CooterPMcGrew/Flight_Computer_REV01/ISS_MCU_REV03-Zynq_PS_CONF.pdf

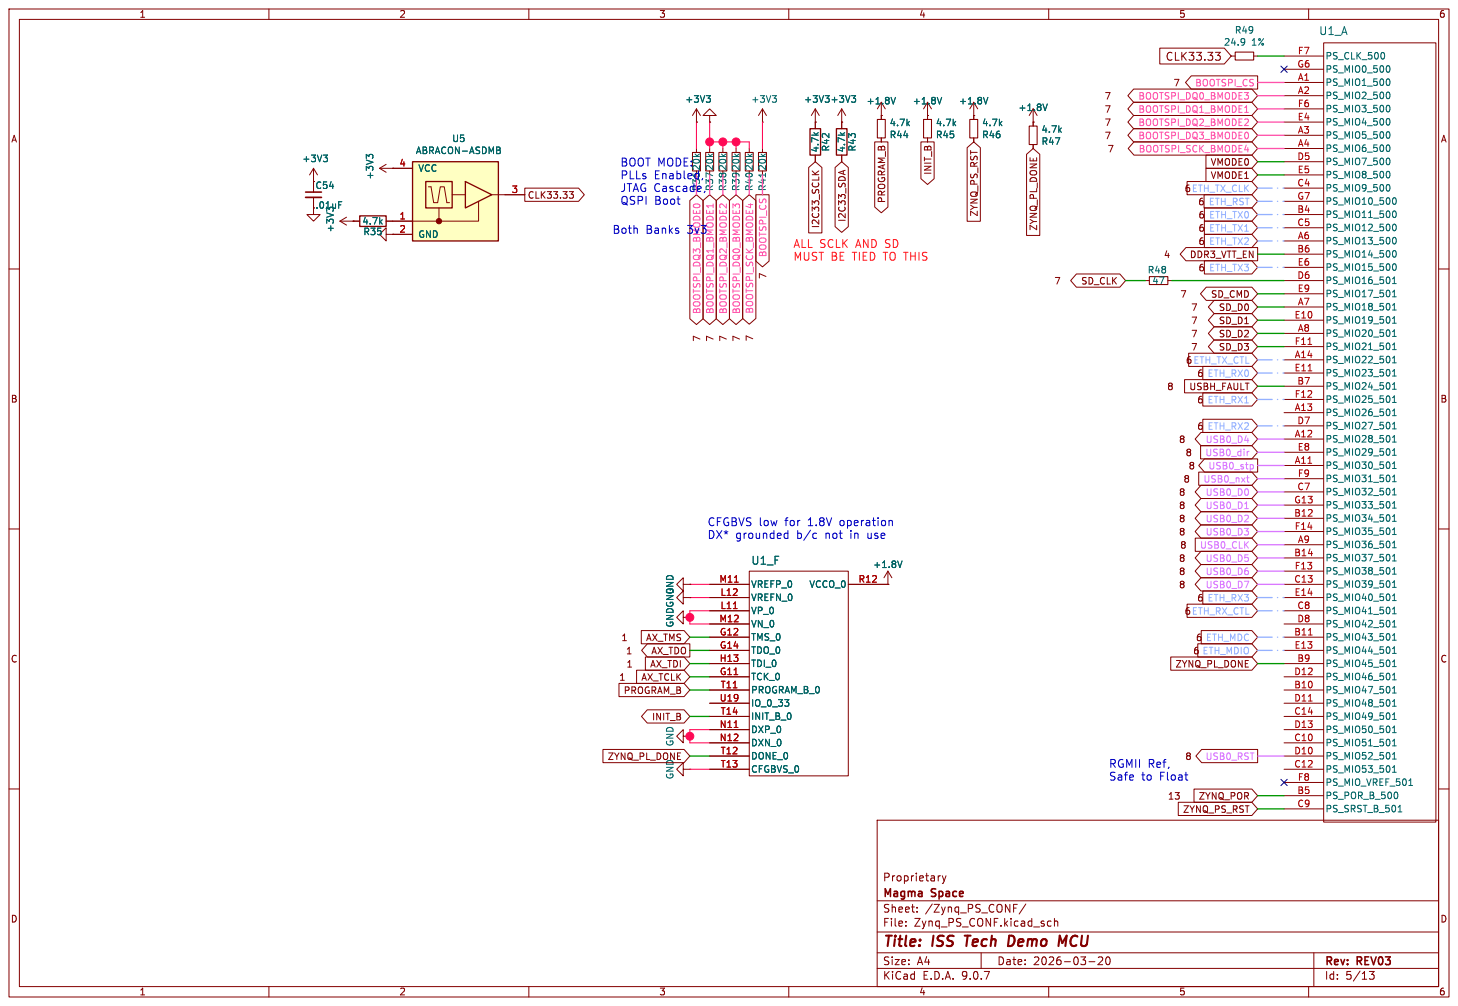
[picture p14: page 1]

Both Banks 3v3 BOOT MODE: PLLs Enabled,

Safe to Float CFGBVS low for 1.8V operation DX* grounded b/c not in use ALL SCLK AND SD

MUST BE TIED TO THIS

Magma Space
File: Zynq_PS_CONF.kicad_sch Sheet: /Zynq_PS_CONF/
Id: 5/13 Title: ISS Tech Demo MCU
