CooterPMcGrew/Flight_Computer_REV01/ISS_MCU_REV05.pdf

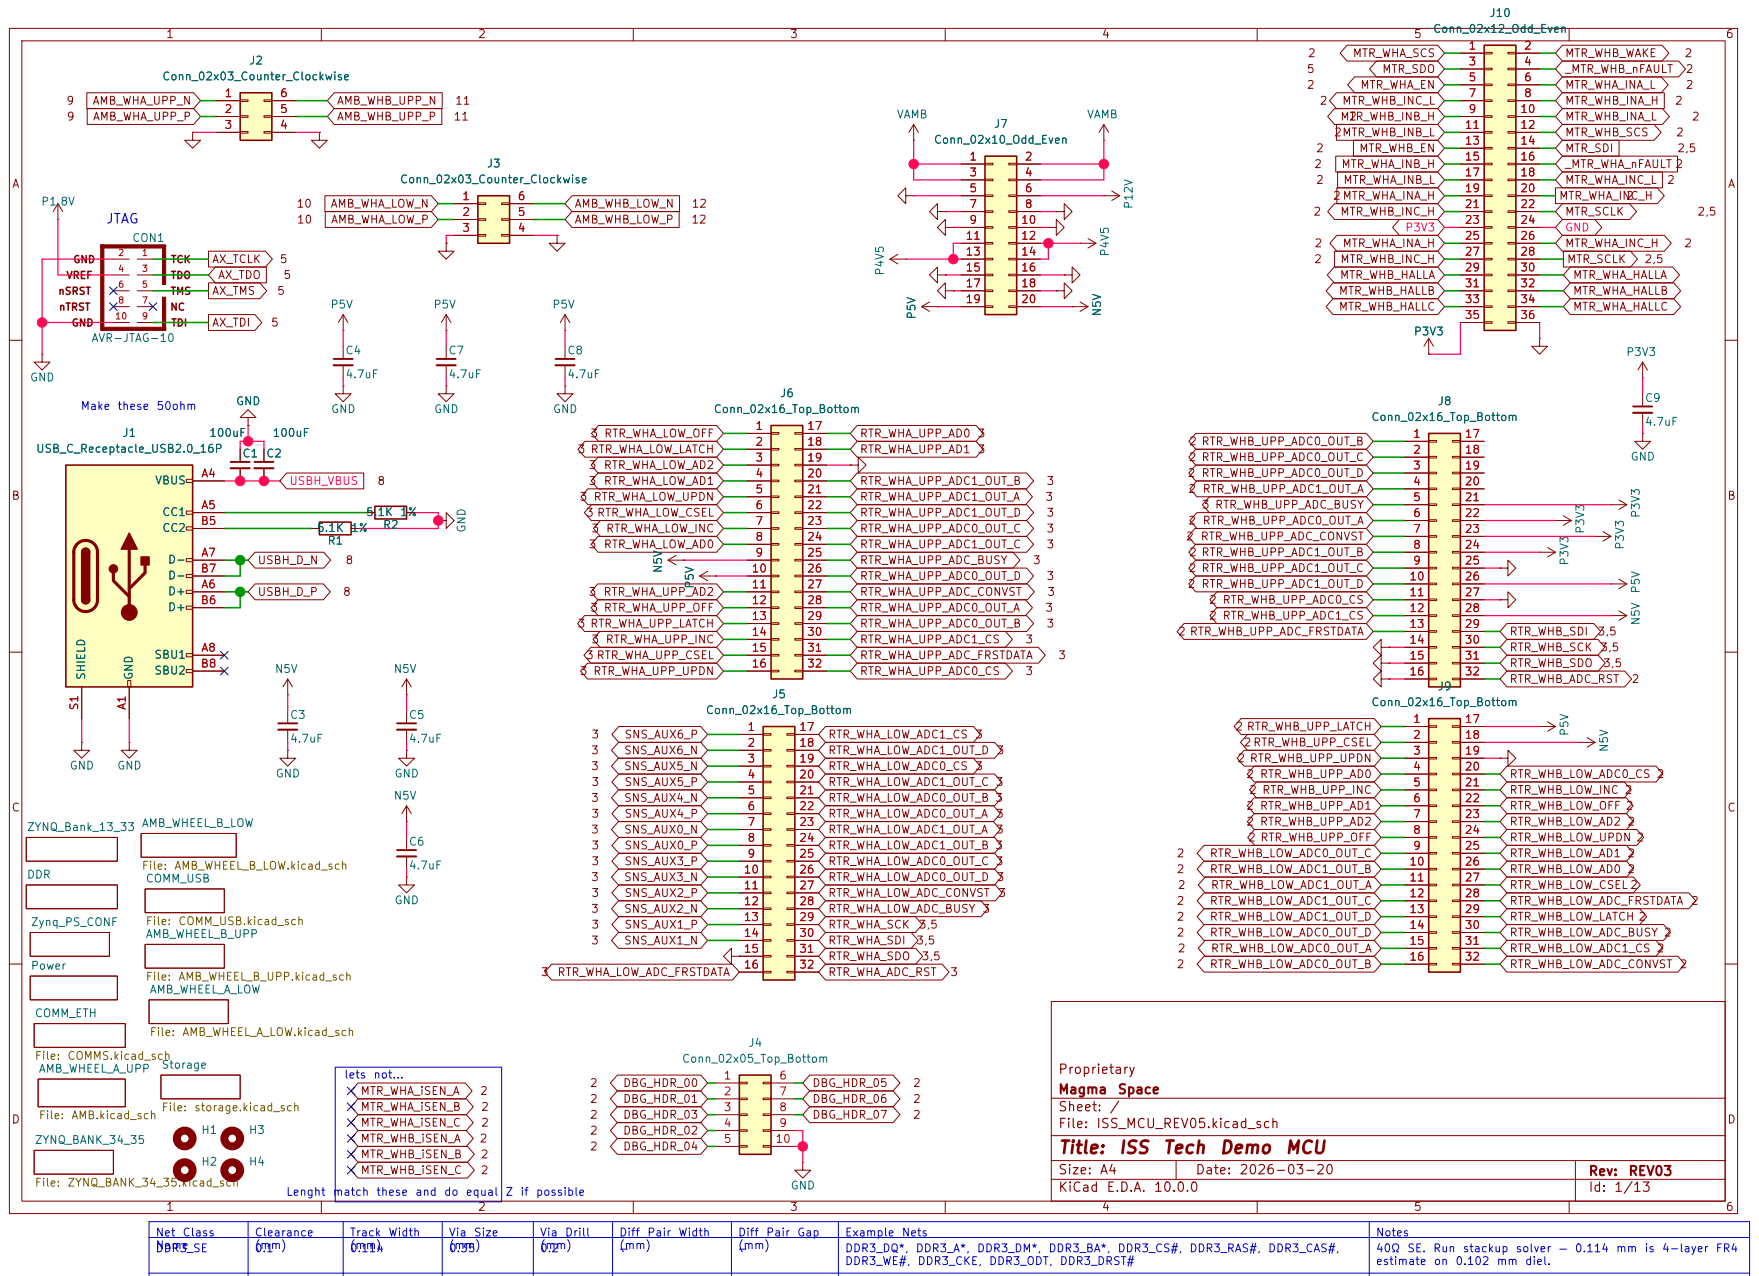
[picture p15: page 1]

Magma Space
Sheet: /
D Date: 2026-03-20 KiCad E.D.A. 10.0.0
File: ISS_MCU_REV05.kicad_sch
Title: ISS Tech Demo MCU

Size: A4 | Rev: REV03

0.1 | Track Width 0.114 | Via Size 0.35 | Via Drill (mm) 0.2 | Diff Pair Width — | Diff Pair Gap — | Example Nets DDR3_DQ*, DDR3_A*, DDR3_DM*, DDR3_BA*, DDR3_CS#, DDR3_RAS#, DDR3_CAS#, | Notes DDR3_SE

(mm) | (mm) | (mm) | | (mm) | (mm) | DDR3_WE#, DDR3_CKE, DDR3_ODT, DDR3_DRST# | 40Ω SE. Run stackup solver — 0.114 mm is 4-layer FR4

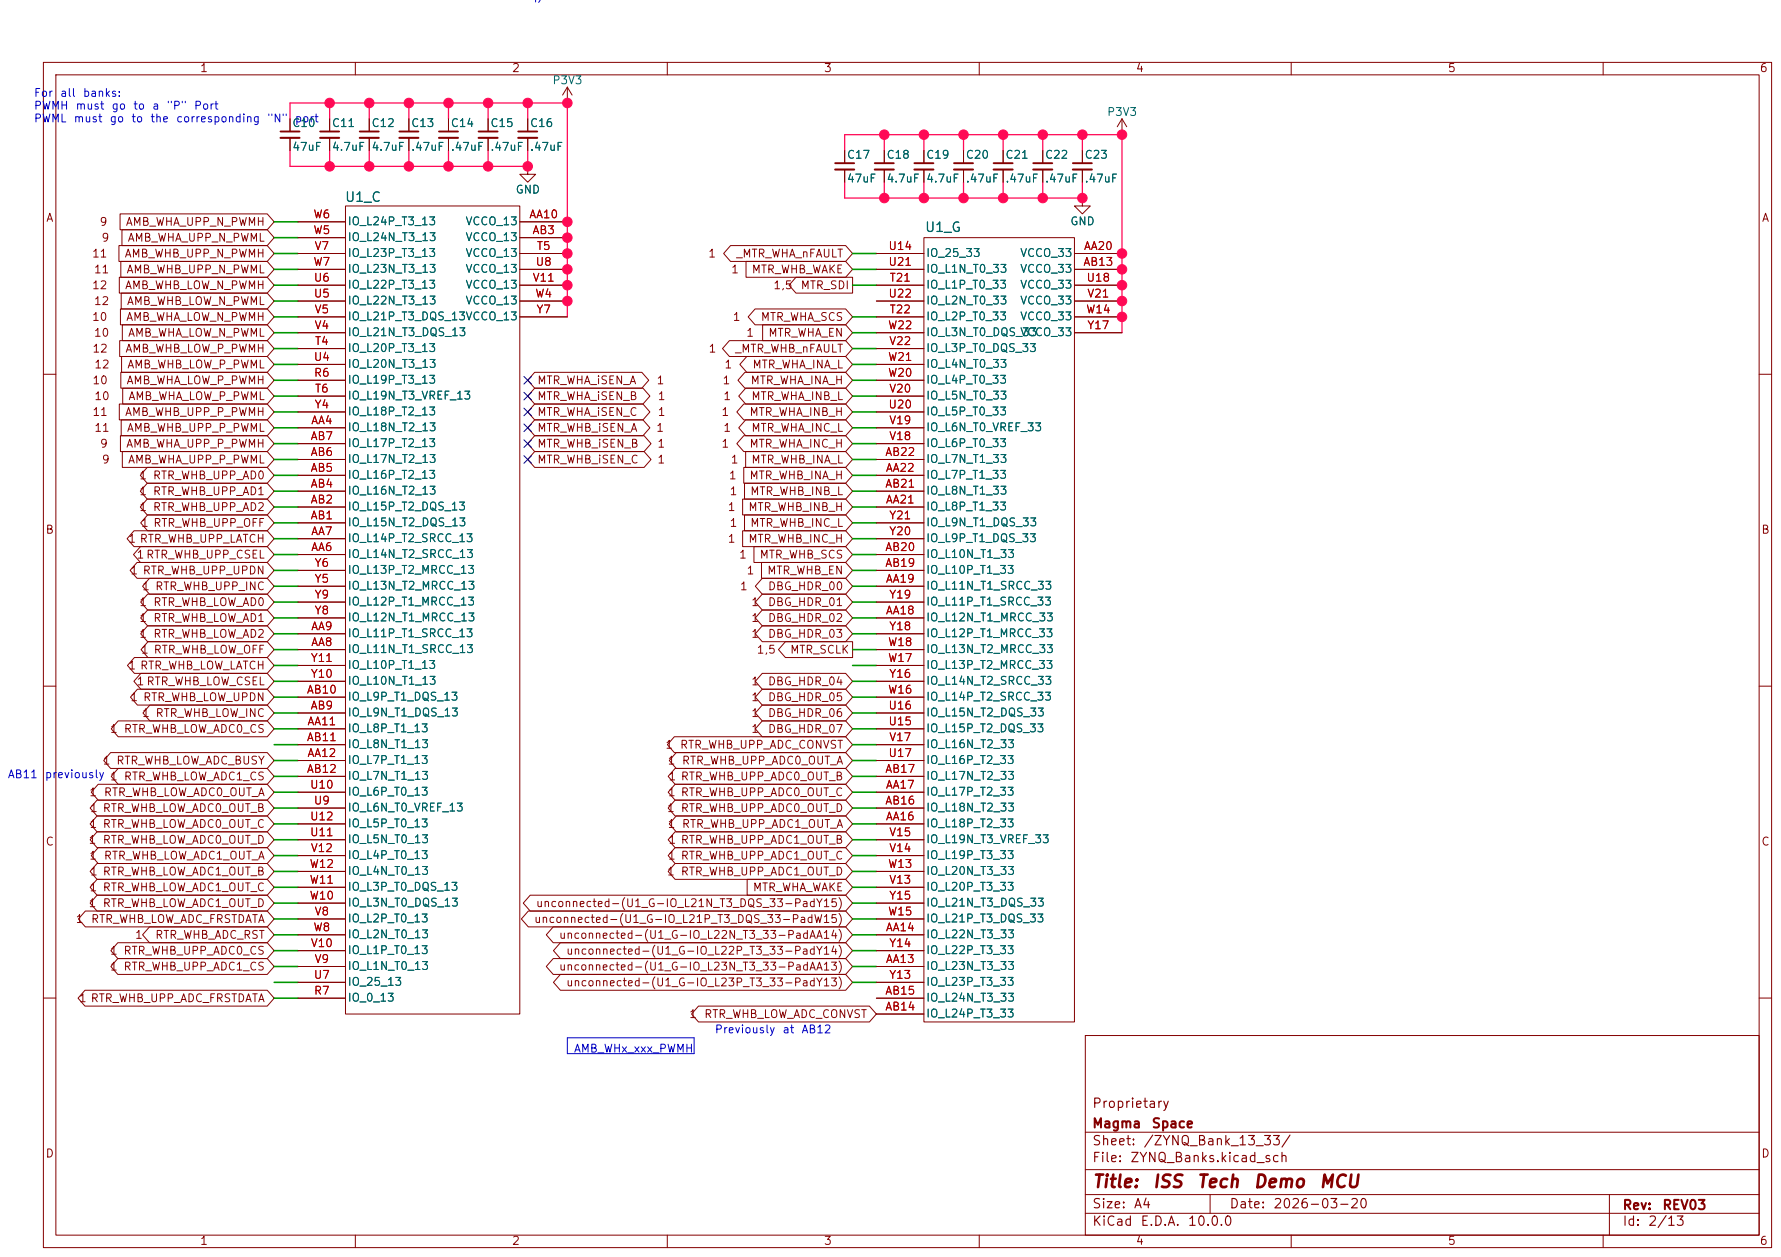
[picture p16: page 2]

Proprietary
Magma Space
Sheet: /ZYNQ_Bank_13_33/
D Date: 2026-03-20 KiCad E.D.A. 10.0.0
File: ZYNQ_Banks.kicad_sch
Title: ISS Tech Demo MCU

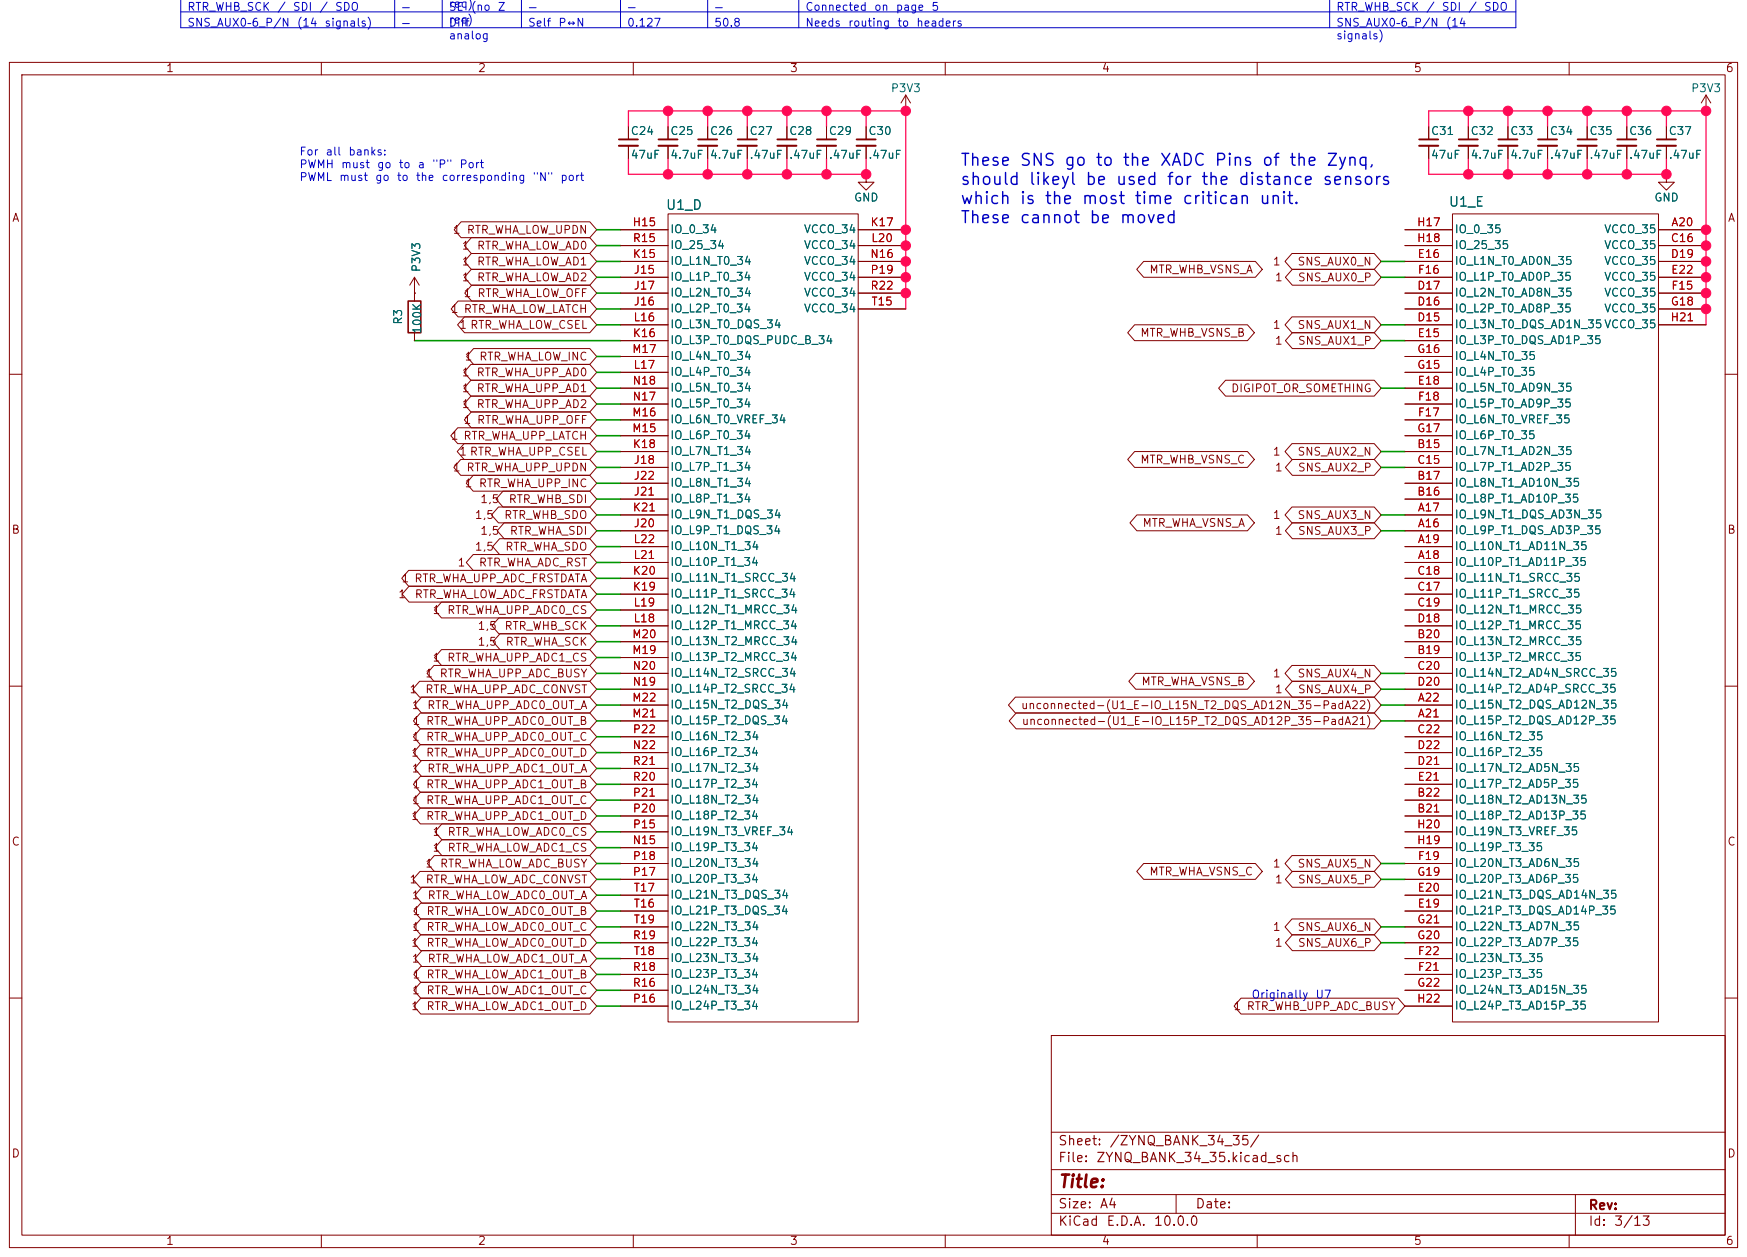
[picture p17: page 3]

For all banks: PWMH must go to a "P" Port PWML must go to the corresponding "N" port

These SNS go to the XADC Pins of the Zynq,
should likeyl be used for the distance sensors
which is the most time critican unit.
These cannot be moved

Size: A4 | Rev:
KiCad E.D.A. 10.0.0

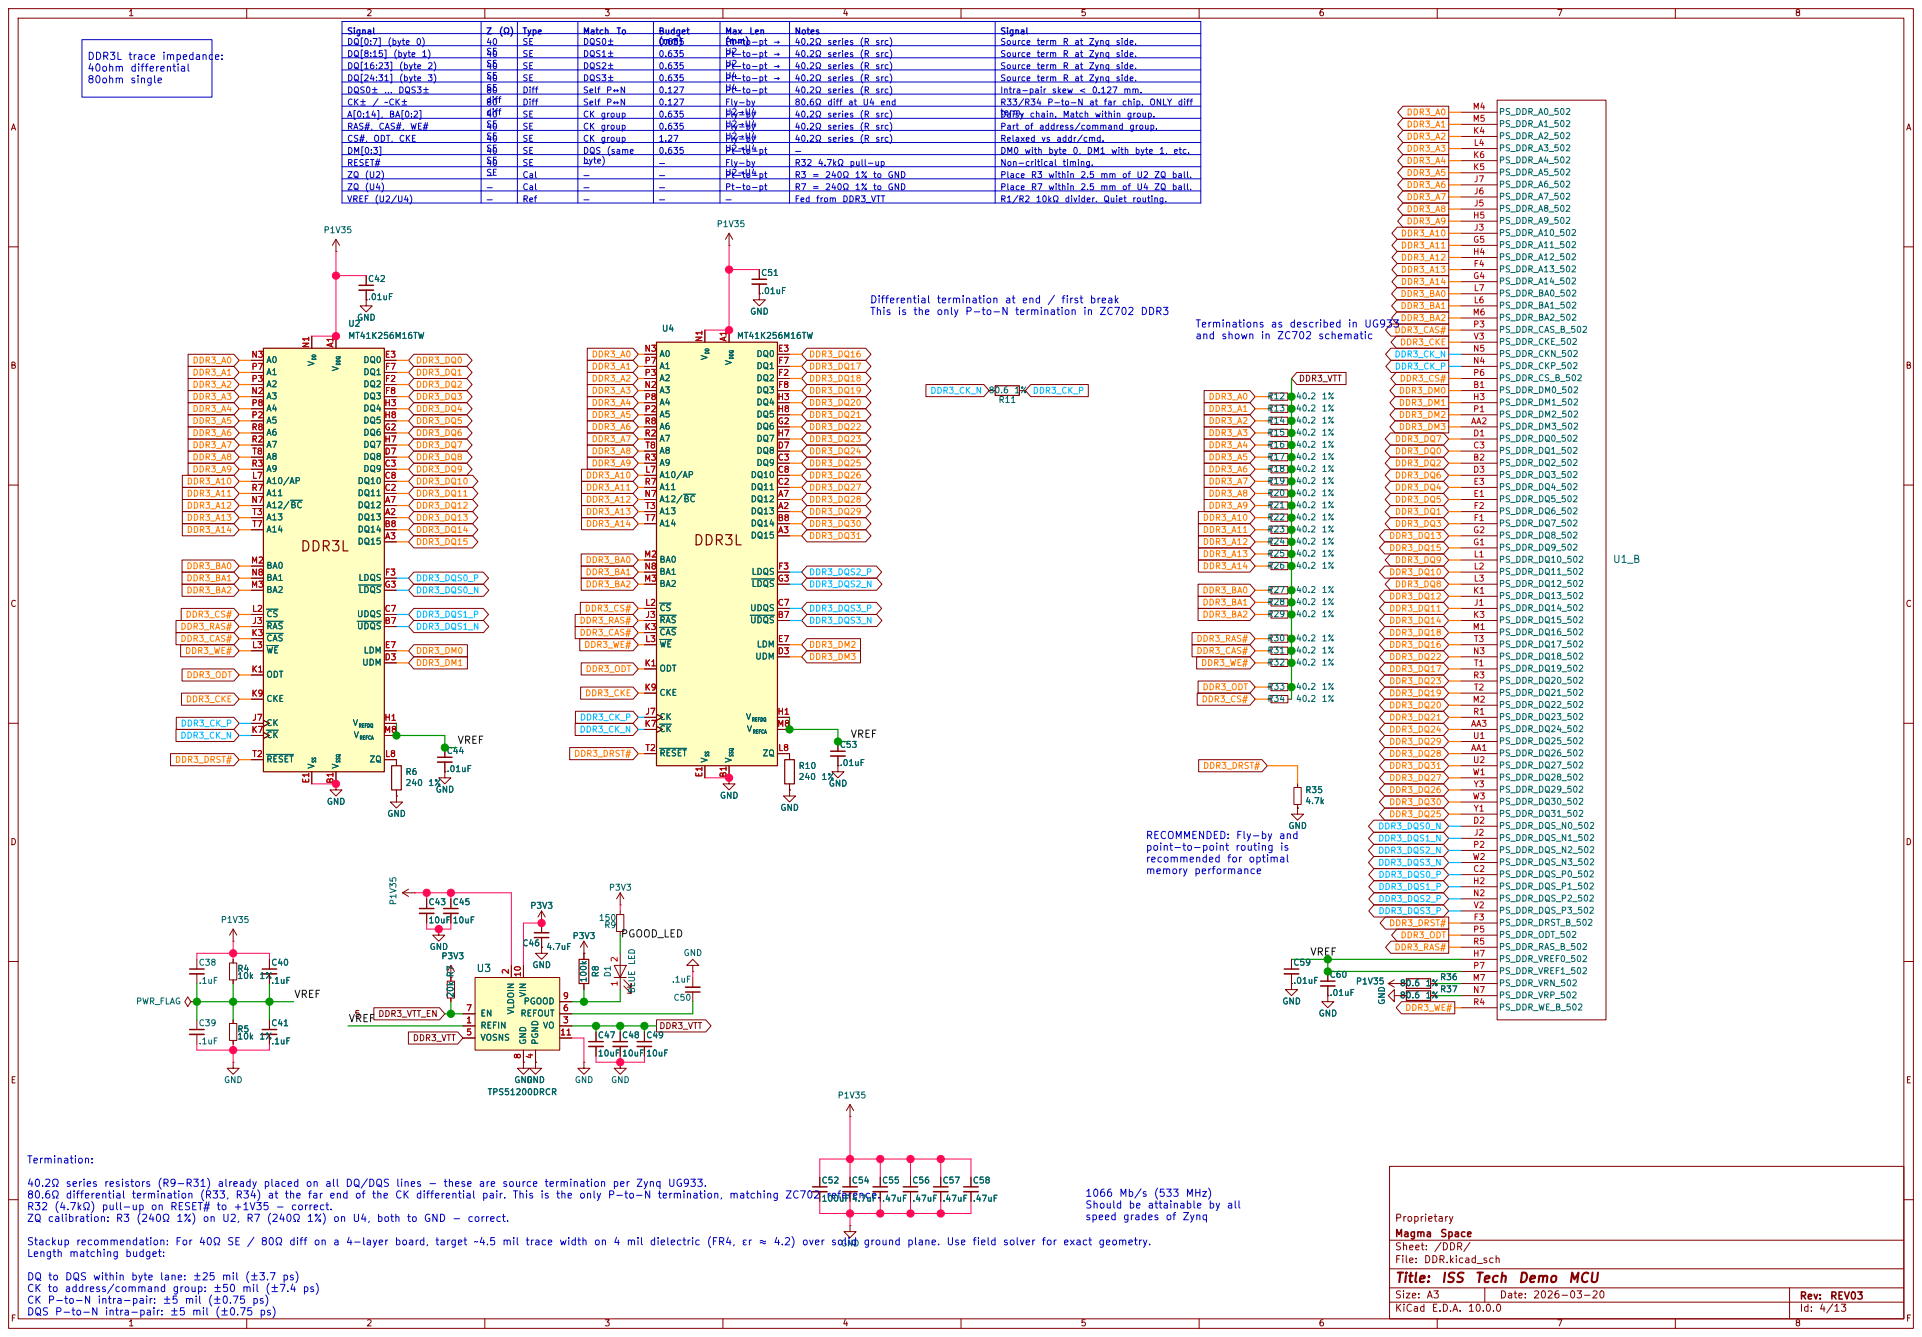
[picture p18: page 4]

Signal | Z (Ω) | Type | Match To | Budget | Max Len

DQ[0:7] (byte 0) | 40 SE 40 | SE | DQS0± | (mm) 0.635 | (mm) Pt-to-pt → | Notes 40.2Ω series (R src) | Signal Source term R at Zynq side. DQ[8:15] (byte 1)

SE 40 | SE | DQS1± | 0.635 | U2 Pt-to-pt → | 40.2Ω series (R src) | Source term R at Zynq side. DQ[16:23] (byte 2)
SE 40 | SE | DQS2± | 0.635 | U2 Pt-to-pt → | 40.2Ω series (R src) | Source term R at Zynq side. DQ[24:31] (byte 3)
80 SE | SE | DQS3± | 0.635 | U4 Pt-to-pt → | 40.2Ω series (R src) | Source term R at Zynq side. DQS0± … DQS3±
diff 80 | Diff | Self P↔N | 0.127 | U4 Pt-to-pt | 40.2Ω series (R src) | Intra-pair skew < 0.127 mm. CK± / ~CK±
40 40 | SE | CK group | 0.635 | Fly-by U2→U4 | 80.6Ω diff at U4 end 40.2Ω series (R src) | R33/R34 P-to-N at far chip. ONLY diff A[0:14], BA[0:2] term. SE Daisy chain. Match within group. RAS#, CAS#, WE#

and shown in ZC702 schematic DDR3L trace impedance:
40ohm differential 80ohm single

diff | Diff | Self P↔N | 0.127 | Fly-by U2→U4

SE 40 | SE | CK group | 0.635 | Fly-by U2→U4 | 40.2Ω series (R src) | Part of address/command group. CS#, ODT, CKE

SE | SE | CK group | 1.27 | Fly-by U2→U4 | 40.2Ω series (R src) | Relaxed vs addr/cmd.

DM[0:3] | 40 SE 40 | SE | DQS (same byte) | 0.635 | Pt-to-pt | — | DM0 with byte 0, DM1 with byte 1, etc. RESET#

SE | SE | — | — | Fly-by U2→U4 | R32 4.7kΩ pull-up | Non-critical timing.

ZQ (U2) | — — — | Cal Cal Ref | — — — | — — — | Pt-to-pt Pt-to-pt — | R3 = 240Ω 1% to GND R7 = 240Ω 1% to GND Fed from DDR3_VTT | Place R3 within 2.5 mm of U2 ZQ ball. ZQ (U4) Place R7 within 2.5 mm of U4 ZQ ball. VREF (U2/U4) R1/R2 10kΩ divider. Quiet routing.

Differential termination at end / first break
This is the only P-to-N termination in ZC702 DDR3
DDR3_DM2 DDR3_DM3 DDR3_DQ24 DDR3_DQ26 DDR3_DQ22 DDR3_DQ25 DDR3_DQ23 DDR3_DQS2_N

Terminations as described in UG933

RECOMMENDED: Fly-by and
point-to-point routing is
recommended for optimal memory performance

1066 Mb/s (533 MHz)
Should be attainable by all
speed grades of Zynq

Proprietary
Magma Space
Sheet: /DDR/
File: DDR.kicad_sch
Title: ISS Tech Demo MCU
F Date: 2026-03-20 KiCad E.D.A. 10.0.0

DQ to DQS within byte lane: ±25 mil (±3.7 ps)
CK to address/command group: ±50 mil (±7.4 ps)
CK P-to-N intra-pair: ±5 mil (±0.75 ps)
DQS P-to-N intra-pair: ±5 mil (±0.75 ps)

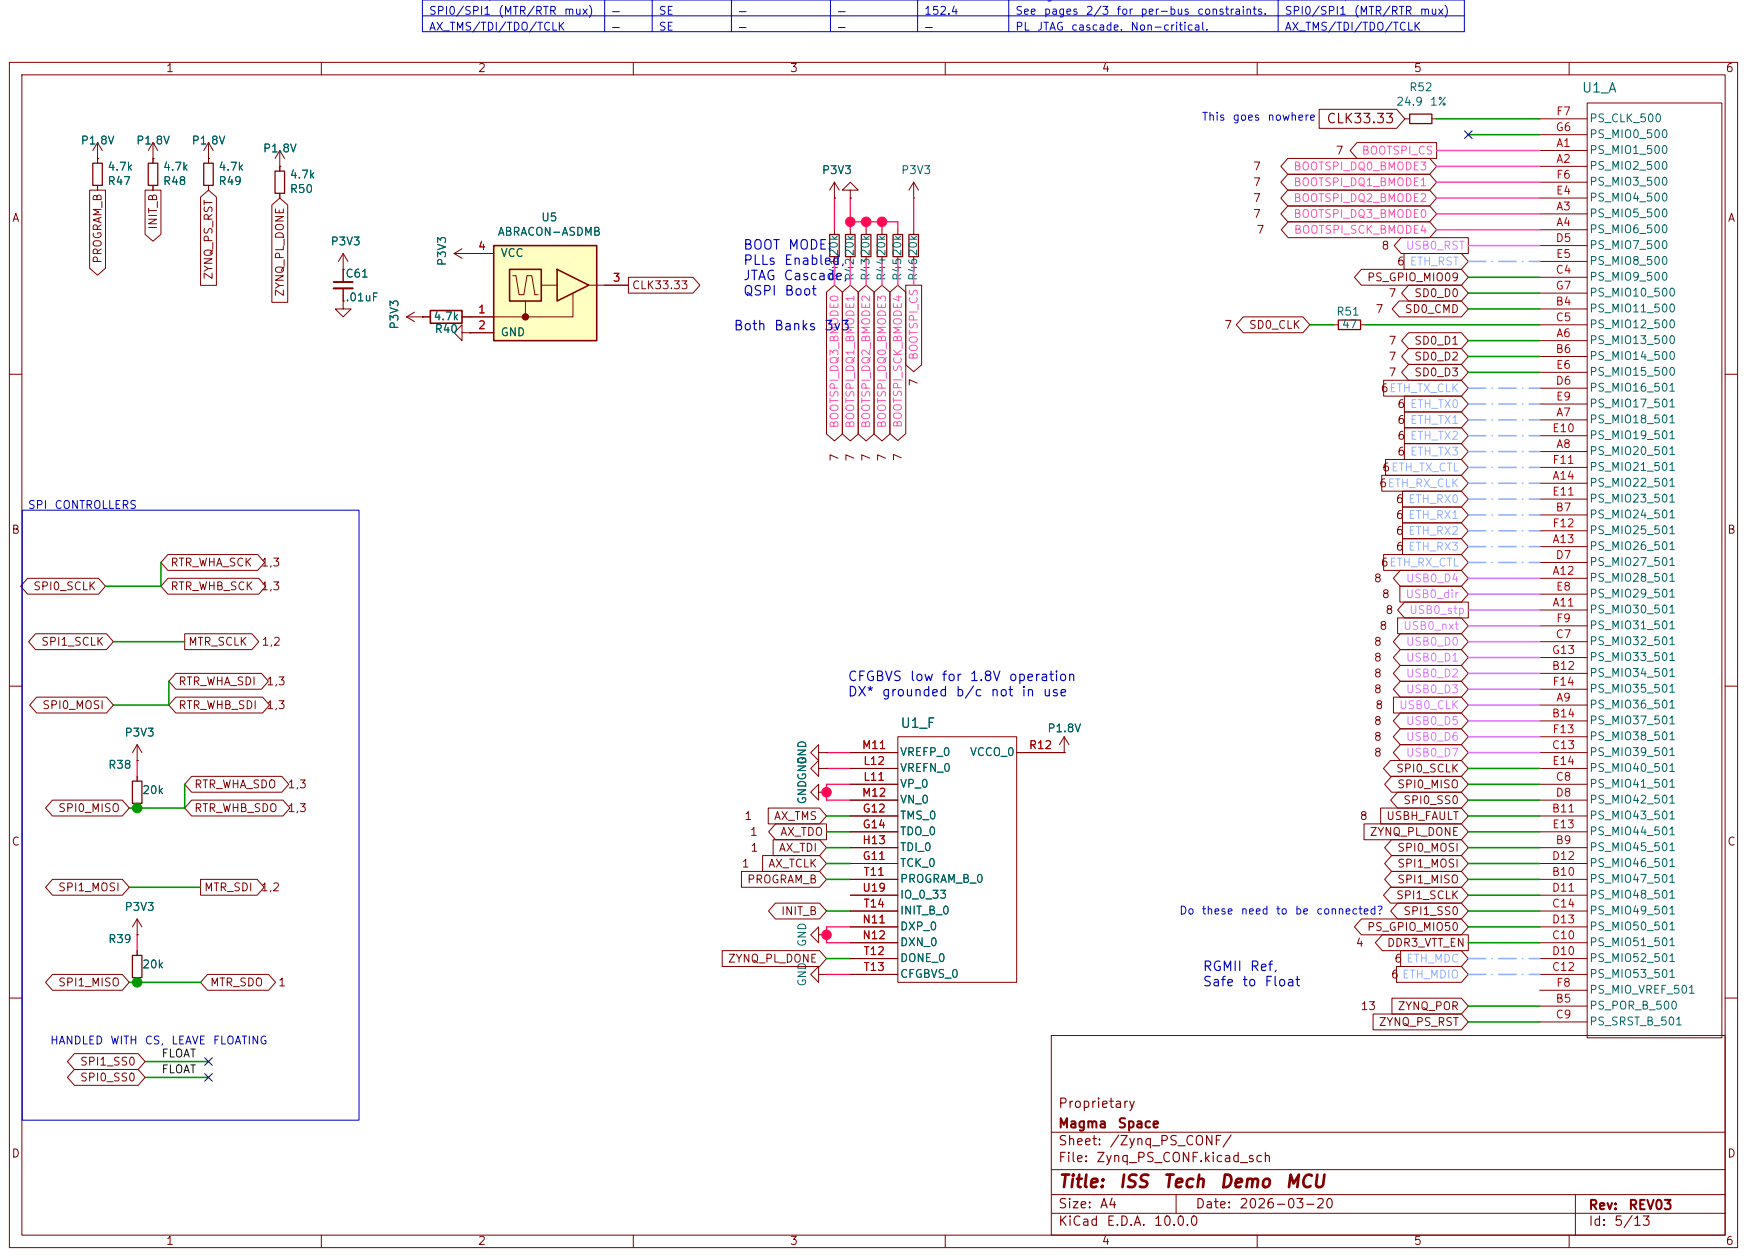
[picture p19: page 5]

SPI0/SPI1 (MTR/RTR mux) | — | SE | — | — | 152.4 | See pages 2/3 for per-bus constraints. | SPI0/SPI1 (MTR/RTR mux)
AX_TMS/TDI/TDO/TCLK | — | SE | — | — | — | PL JTAG cascade. Non-critical. | AX_TMS/TDI/TDO/TCLK

BOOT MODE: PLLs Enabled,

Safe to Float Both Banks 3v3

Proprietary
Magma Space
Sheet: /Zynq_PS_CONF/
D Date: 2026-03-20 KiCad E.D.A. 10.0.0
File: Zynq_PS_CONF.kicad_sch
Title: ISS Tech Demo MCU

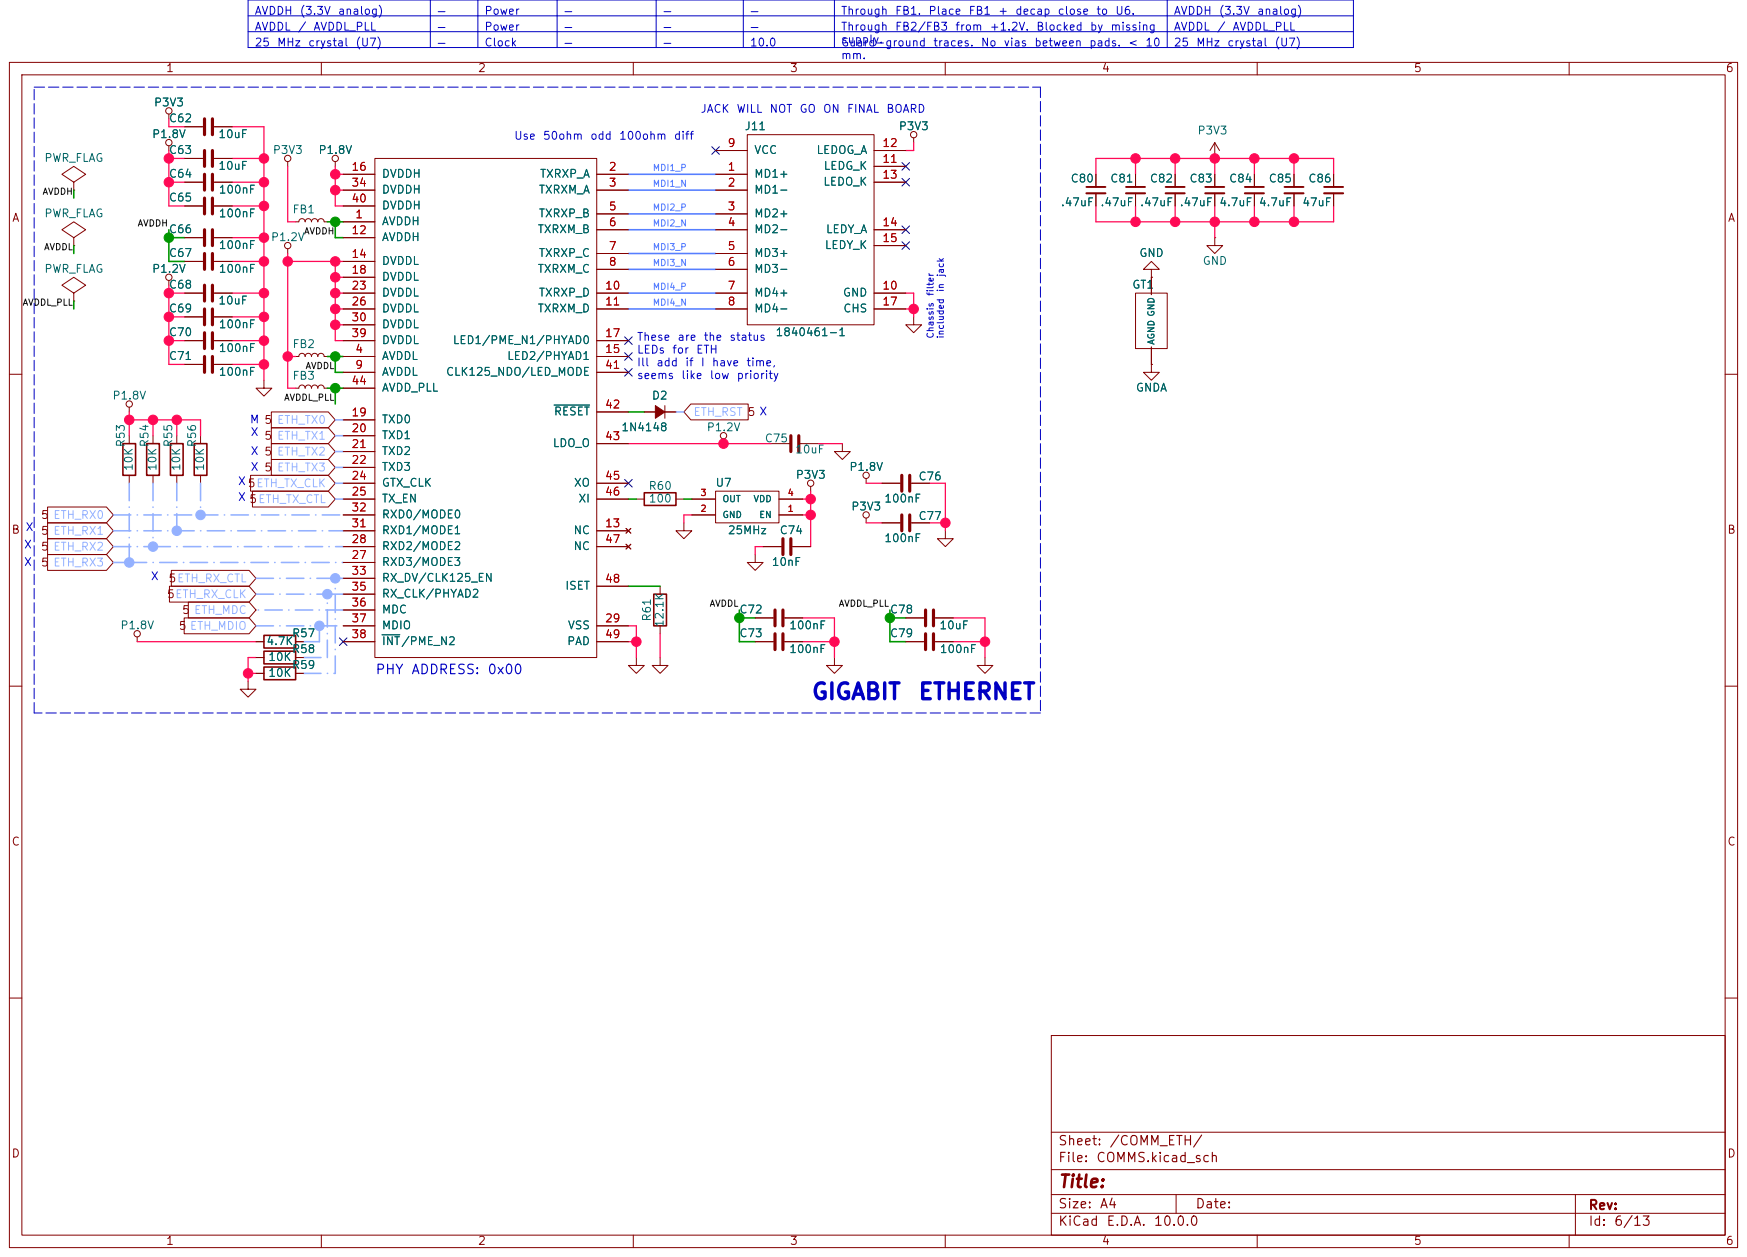
[picture p20: page 6]

AVDDL / AVDDL_PLL | — | Power | — | — | — | Through FB2/FB3 from +1.2V. Blocked by missing

supply.

JACK WILL NOT GO ON FINAL BOARD
AVDDL MDI1_P MDI1_N

These are the status
LEDs for ETH

Ill add if I have time, seems like low priority X

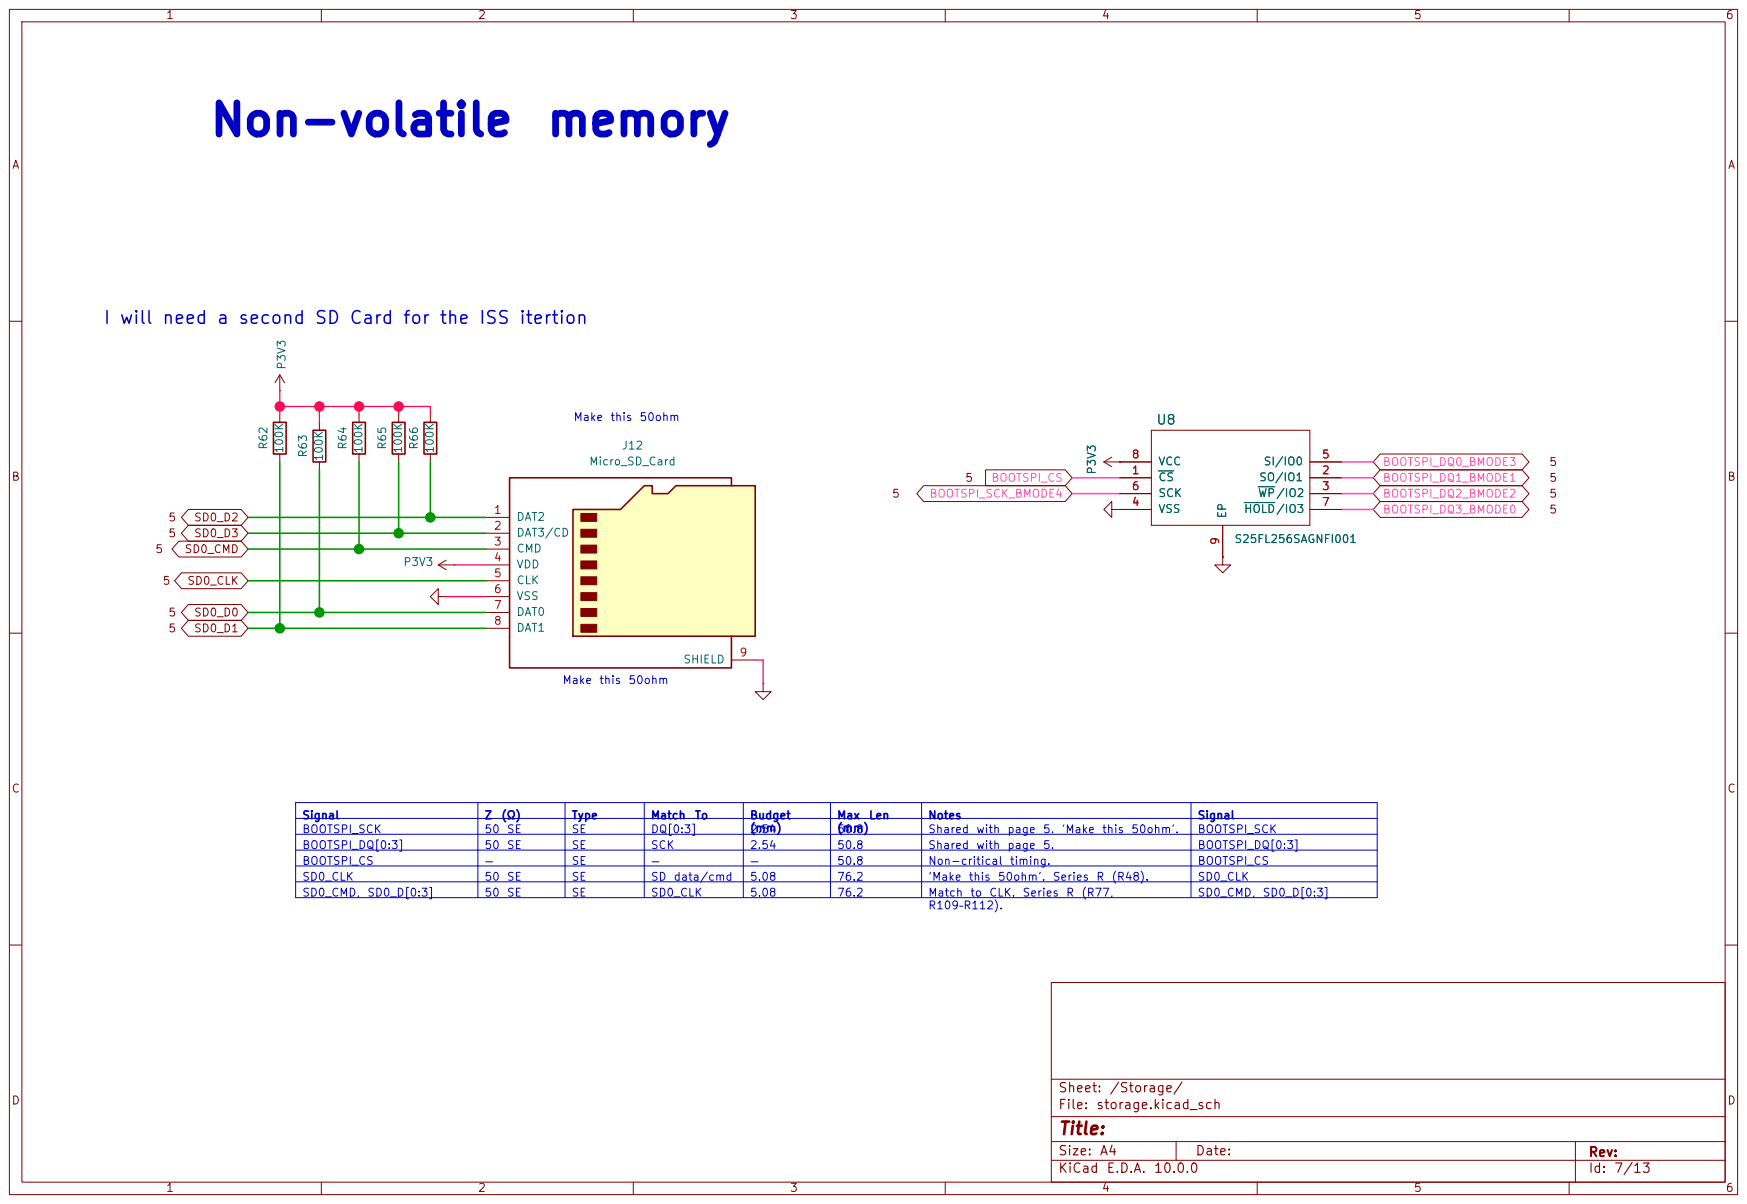
[picture p21: page 7]

I will need a second SD Card for the ISS itertion

Signal | Z (Ω) 50 SE | Type SE | Match To DQ[0:3] | Budget 2.54 | Max Len (mm) 50.8 | Notes Shared with page 5. 'Make this 50ohm'. | Signal BOOTSPI_SCK BOOTSPI_SCK

BOOTSPI_DQ[0:3] | 50 SE — | SE SE | SCK — | 2.54 — | 50.8 | Shared with page 5. Non-critical timing. | BOOTSPI_DQ[0:3] BOOTSPI_CS BOOTSPI_CS

SD0_CLK | 50 SE | SE | SD data/cmd | 5.08 | 76.2 | 'Make this 50ohm'. Series R (R48). | SD0_CLK
SD0_CMD, SD0_D[0:3] | 50 SE | SE | SD0_CLK | 5.08 | 76.2 | Match to CLK. Series R (R77, | SD0_CMD, SD0_D[0:3]

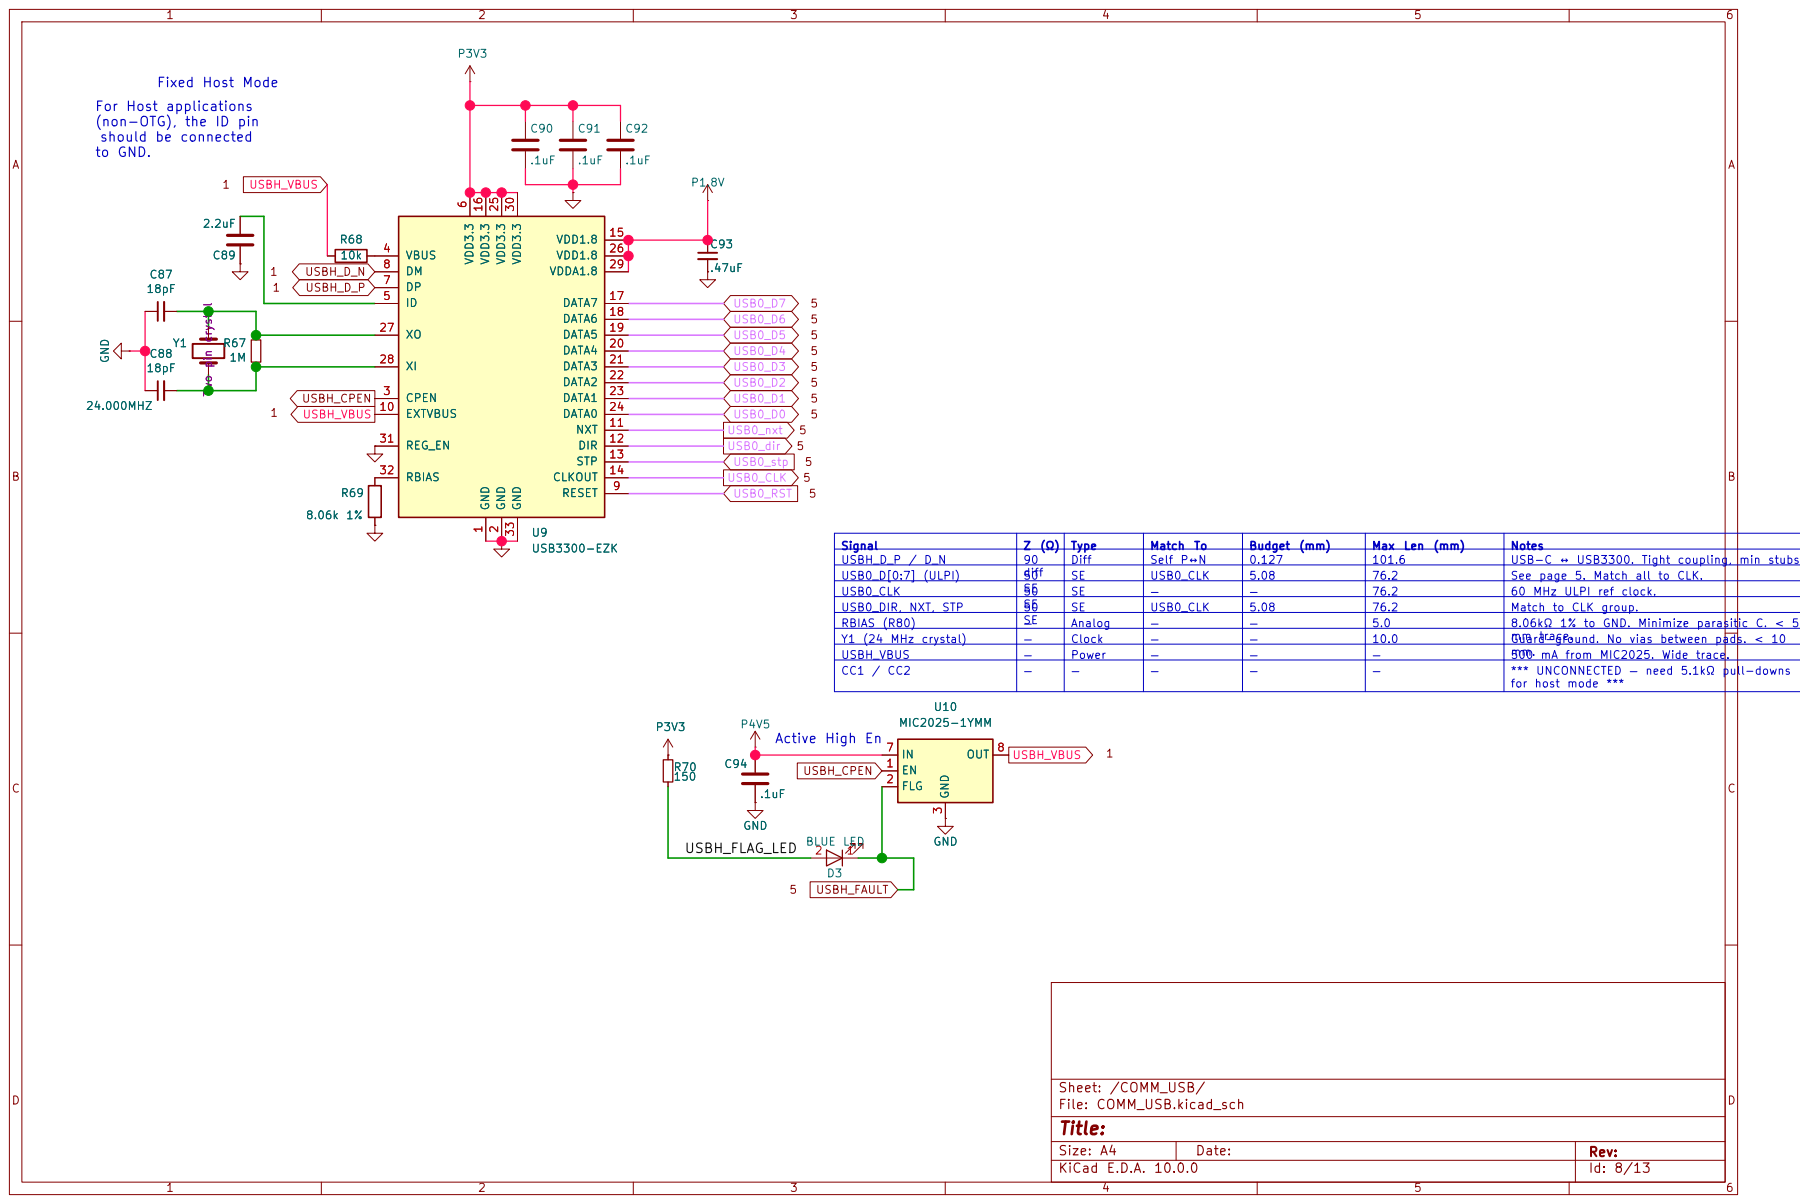
[picture p22: page 8]

to GND. Fixed Host Mode

For Host applications
(non-OTG), the ID pin
should be connected

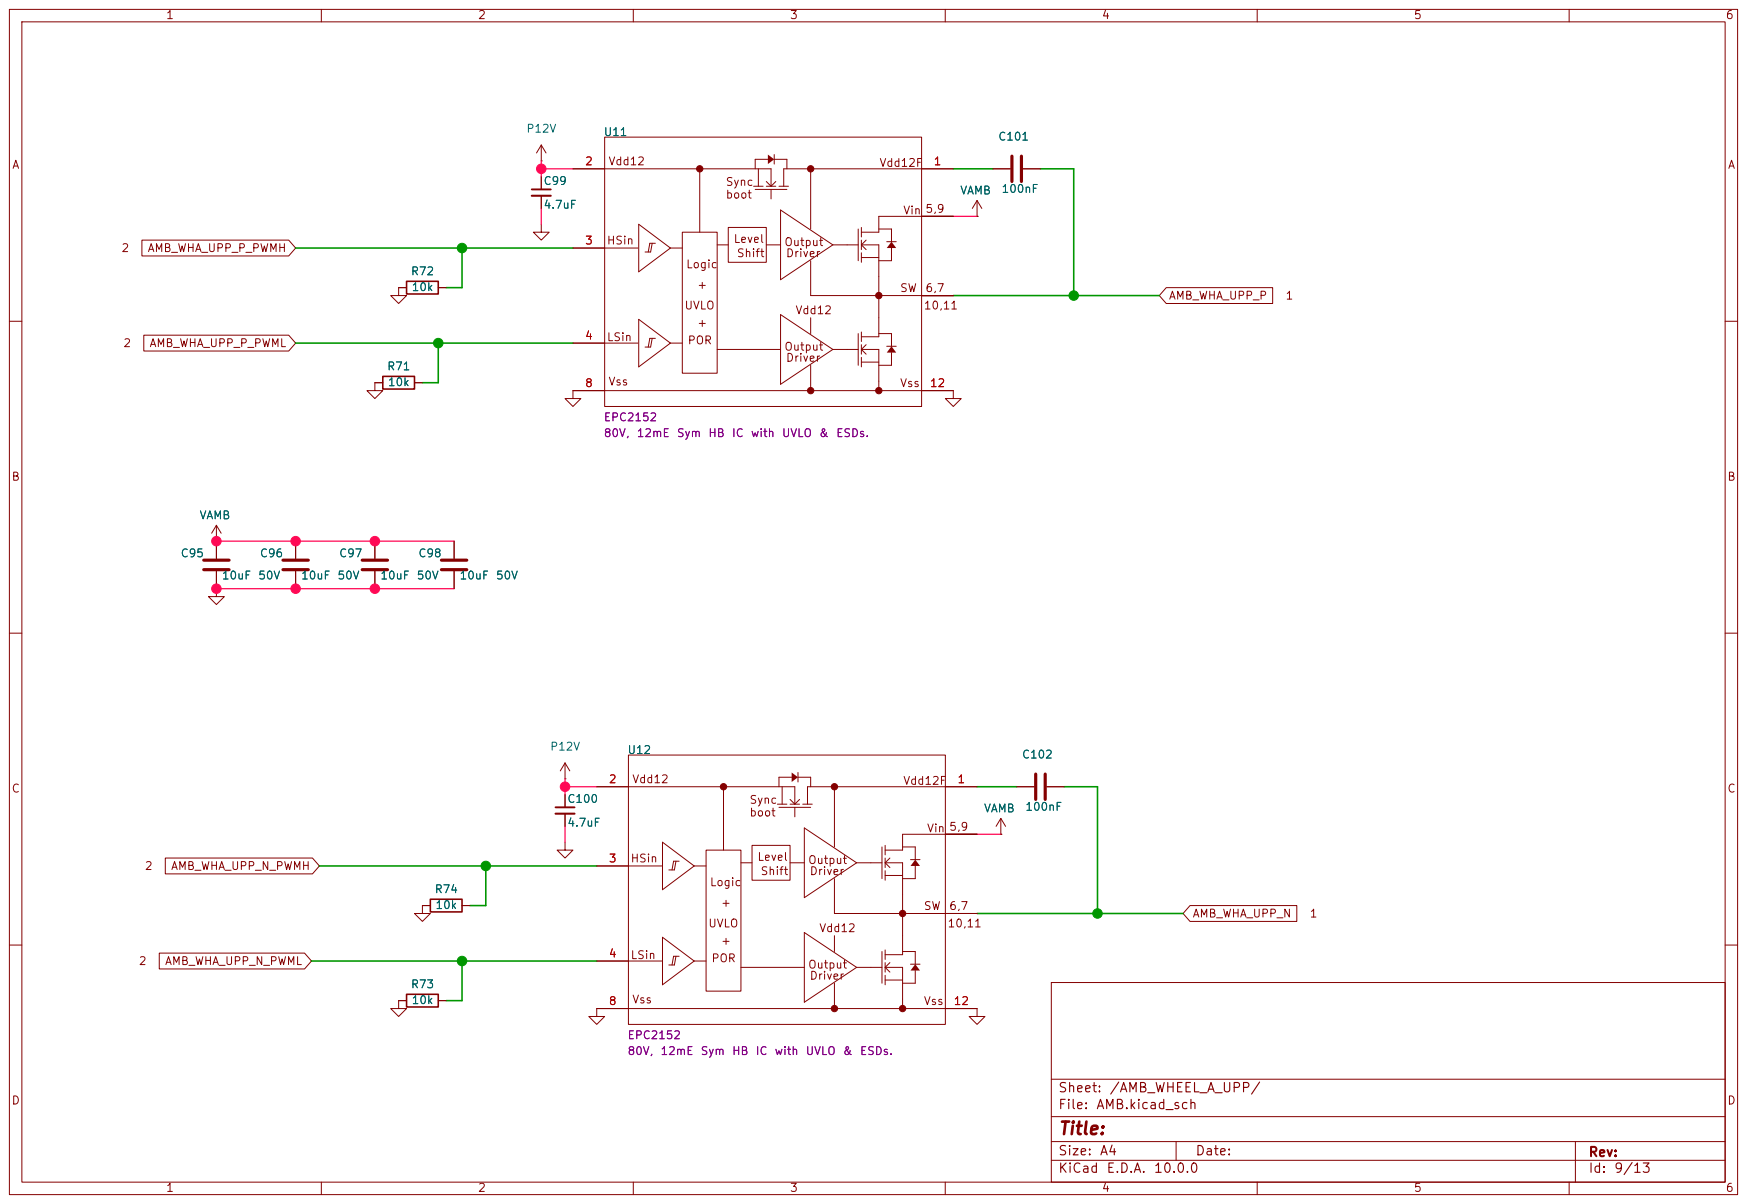
[picture p23: page 9]

80V, 12mE Sym HB IC with UVLO & ESDs. R71

80V, 12mE Sym HB IC with UVLO & ESDs. R73

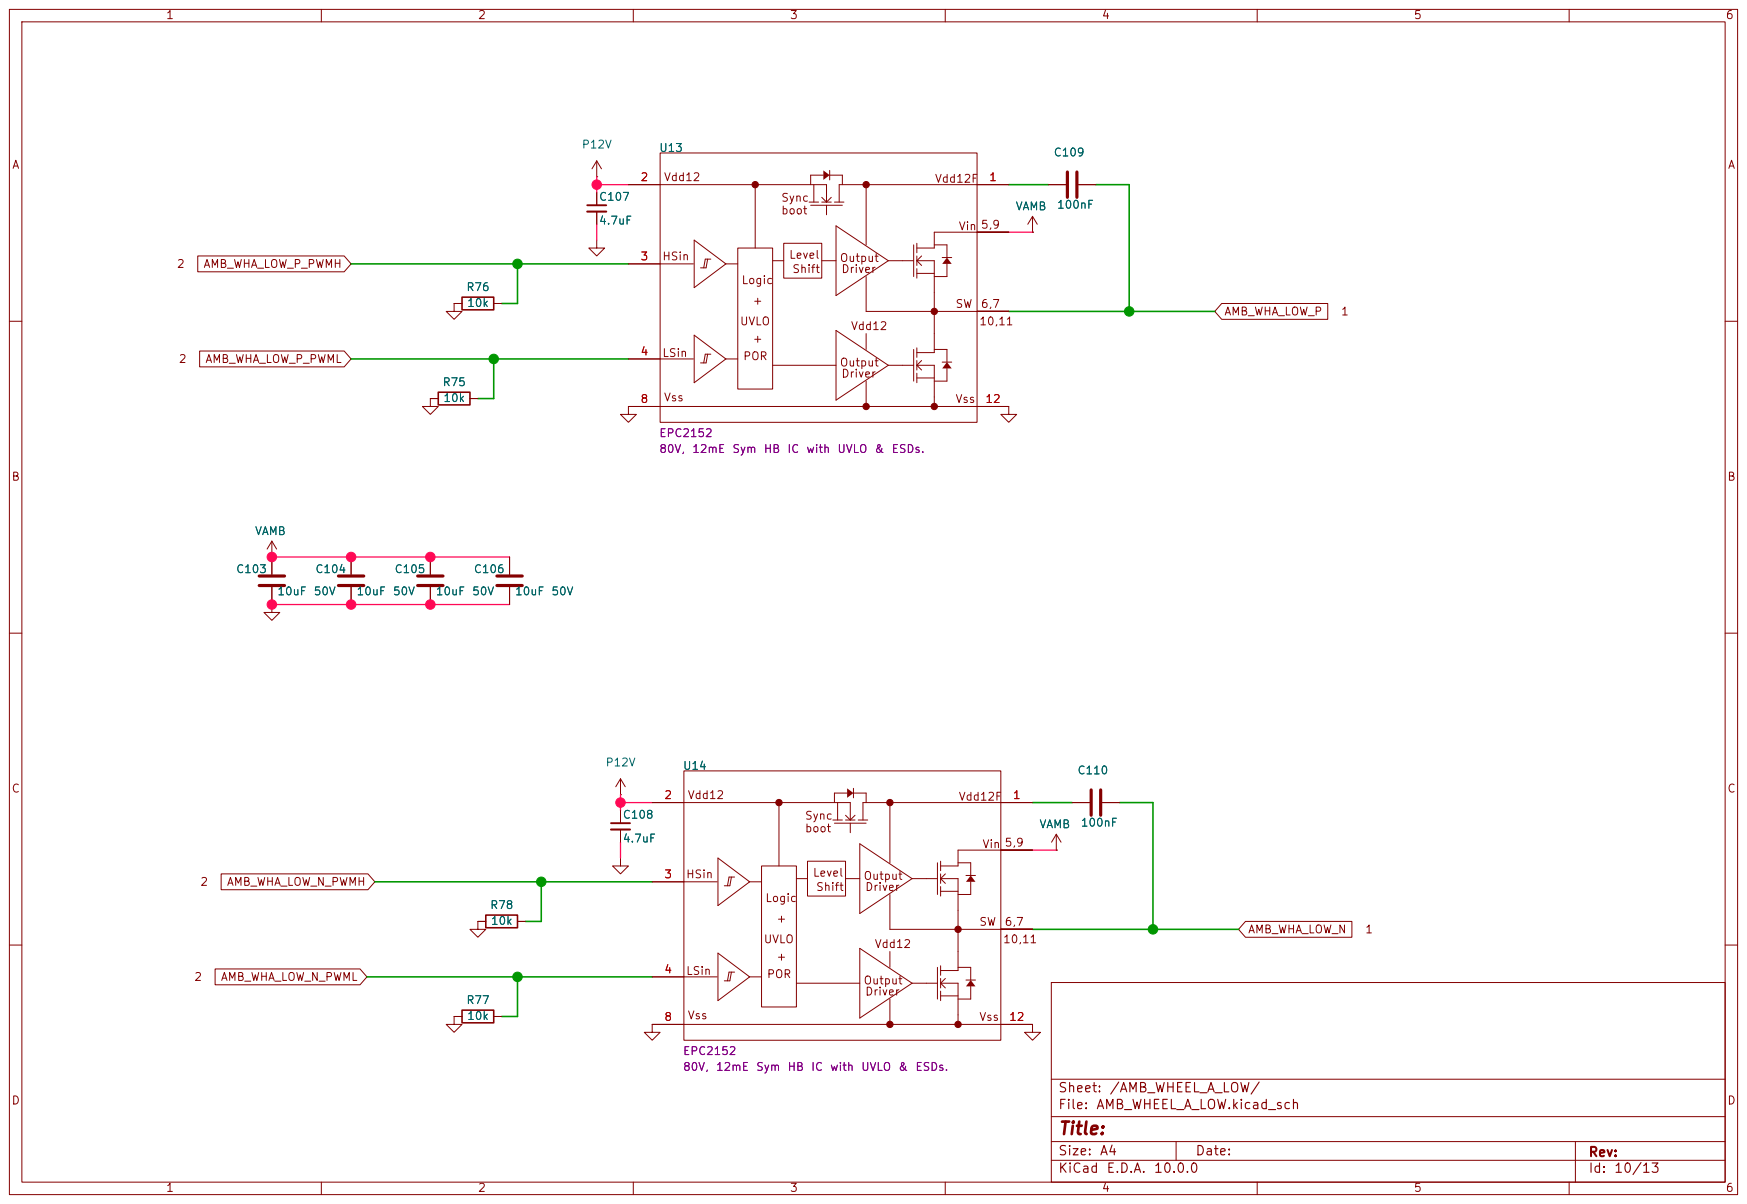
[picture p24: page 10]

80V, 12mE Sym HB IC with UVLO & ESDs. C103

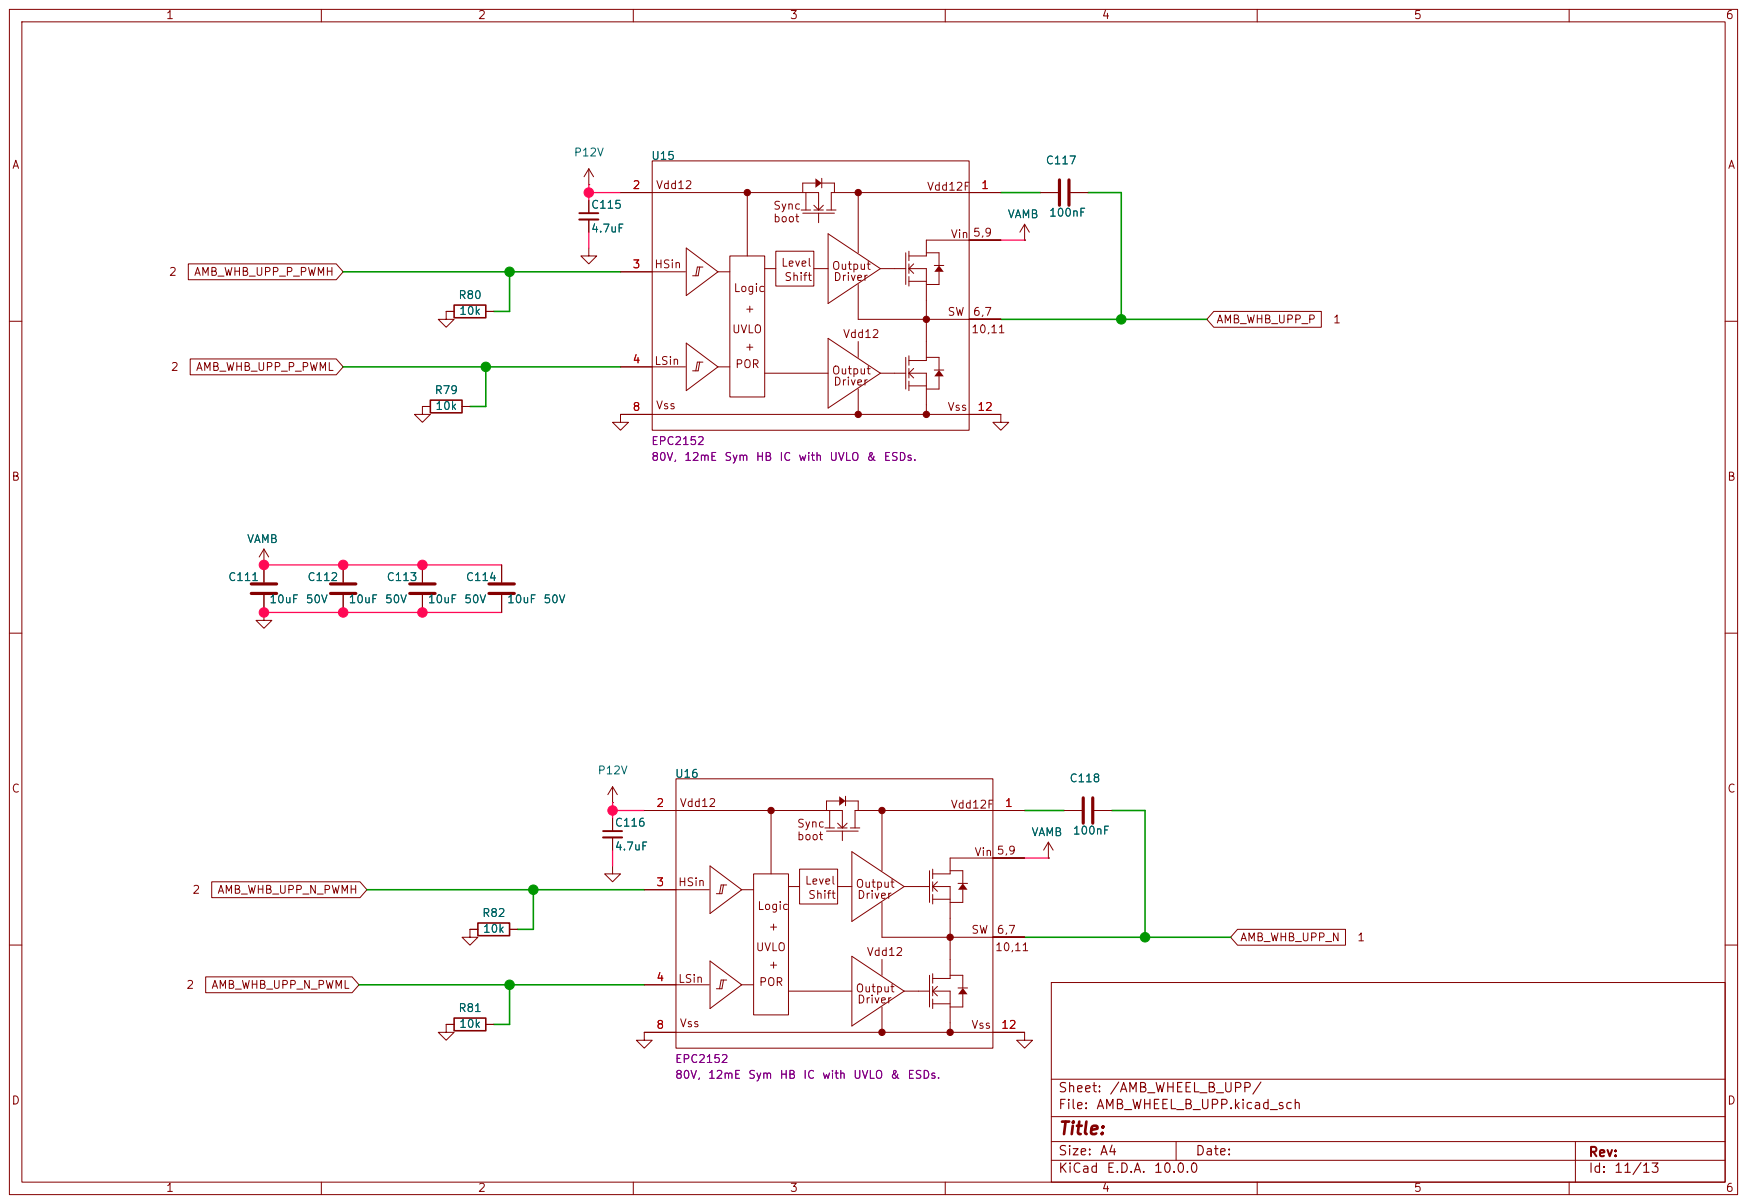
[picture p25: page 11]

80V, 12mE Sym HB IC with UVLO & ESDs. C113

EPC2152
80V, 12mE Sym HB IC with UVLO & ESDs.

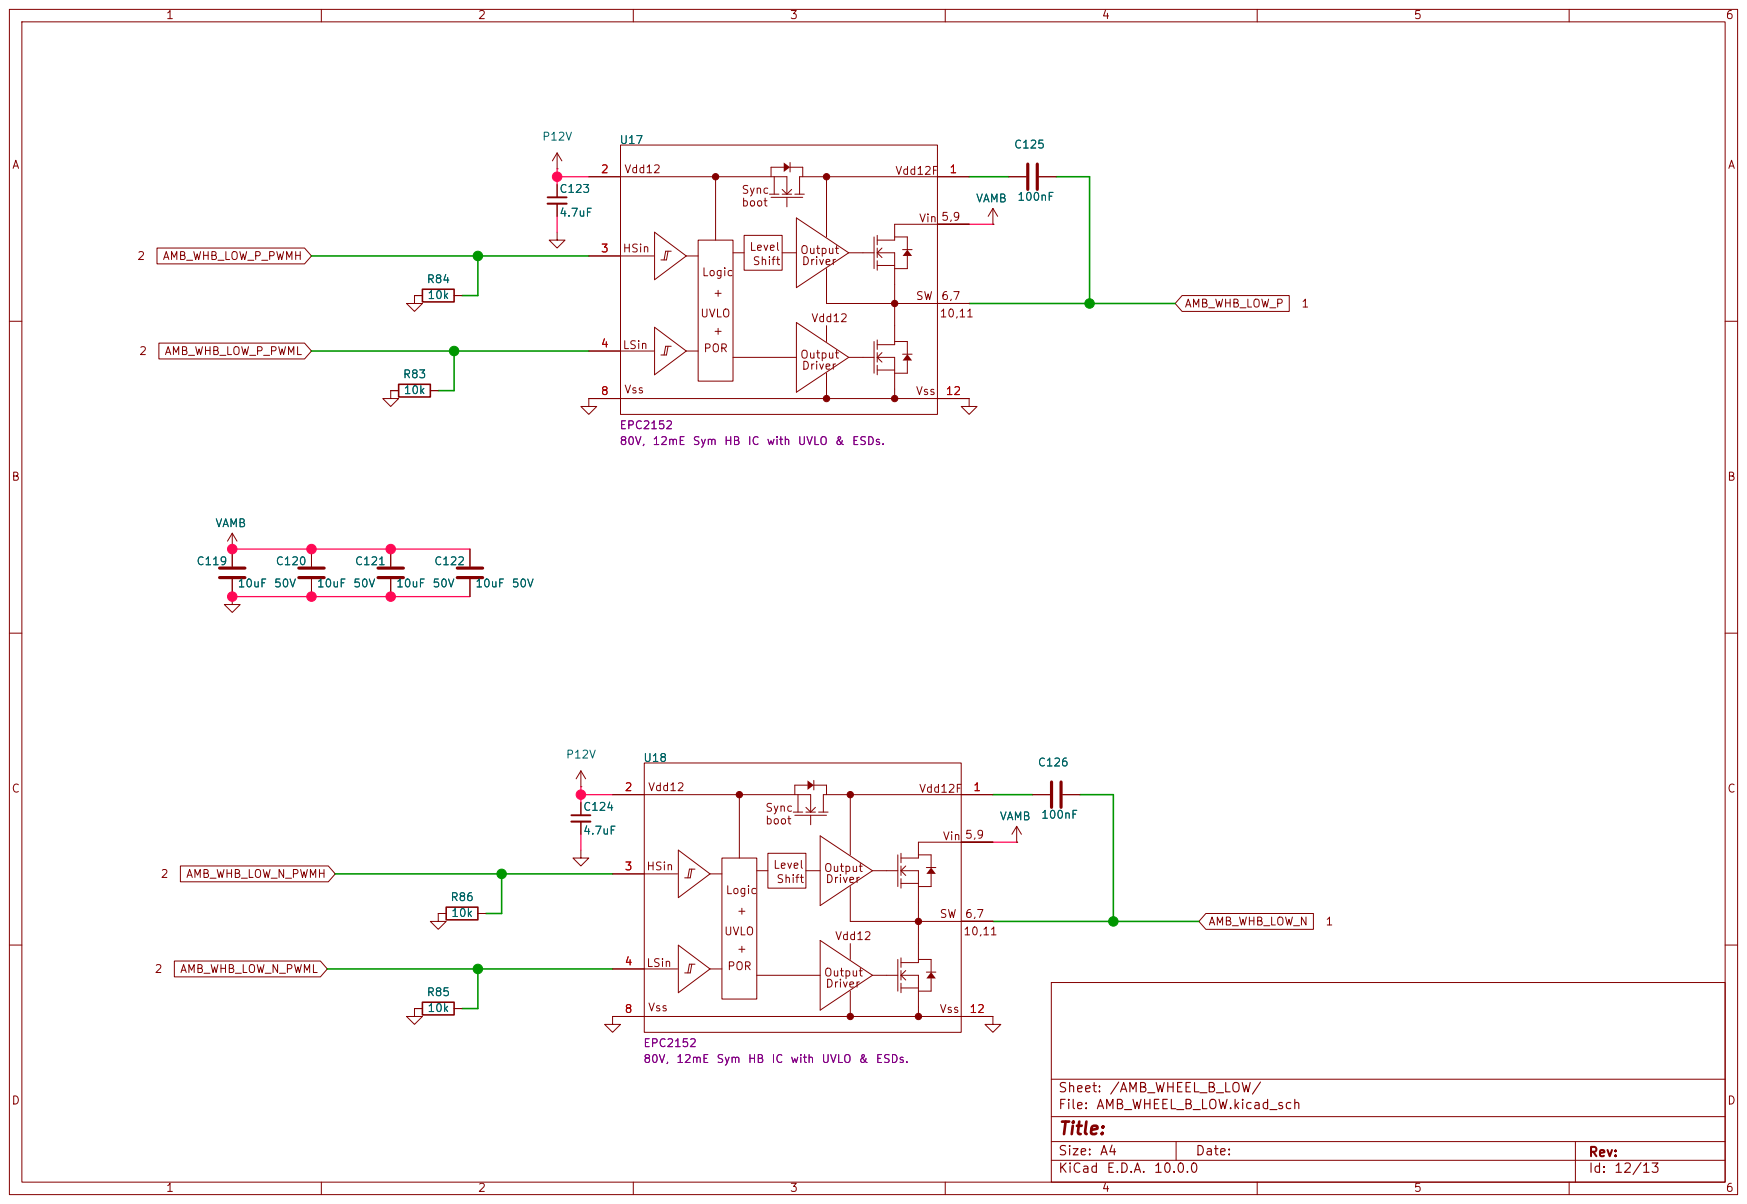
[picture p26: page 12]

80V, 12mE Sym HB IC with UVLO & ESDs. C124

EPC2152
80V, 12mE Sym HB IC with UVLO & ESDs.

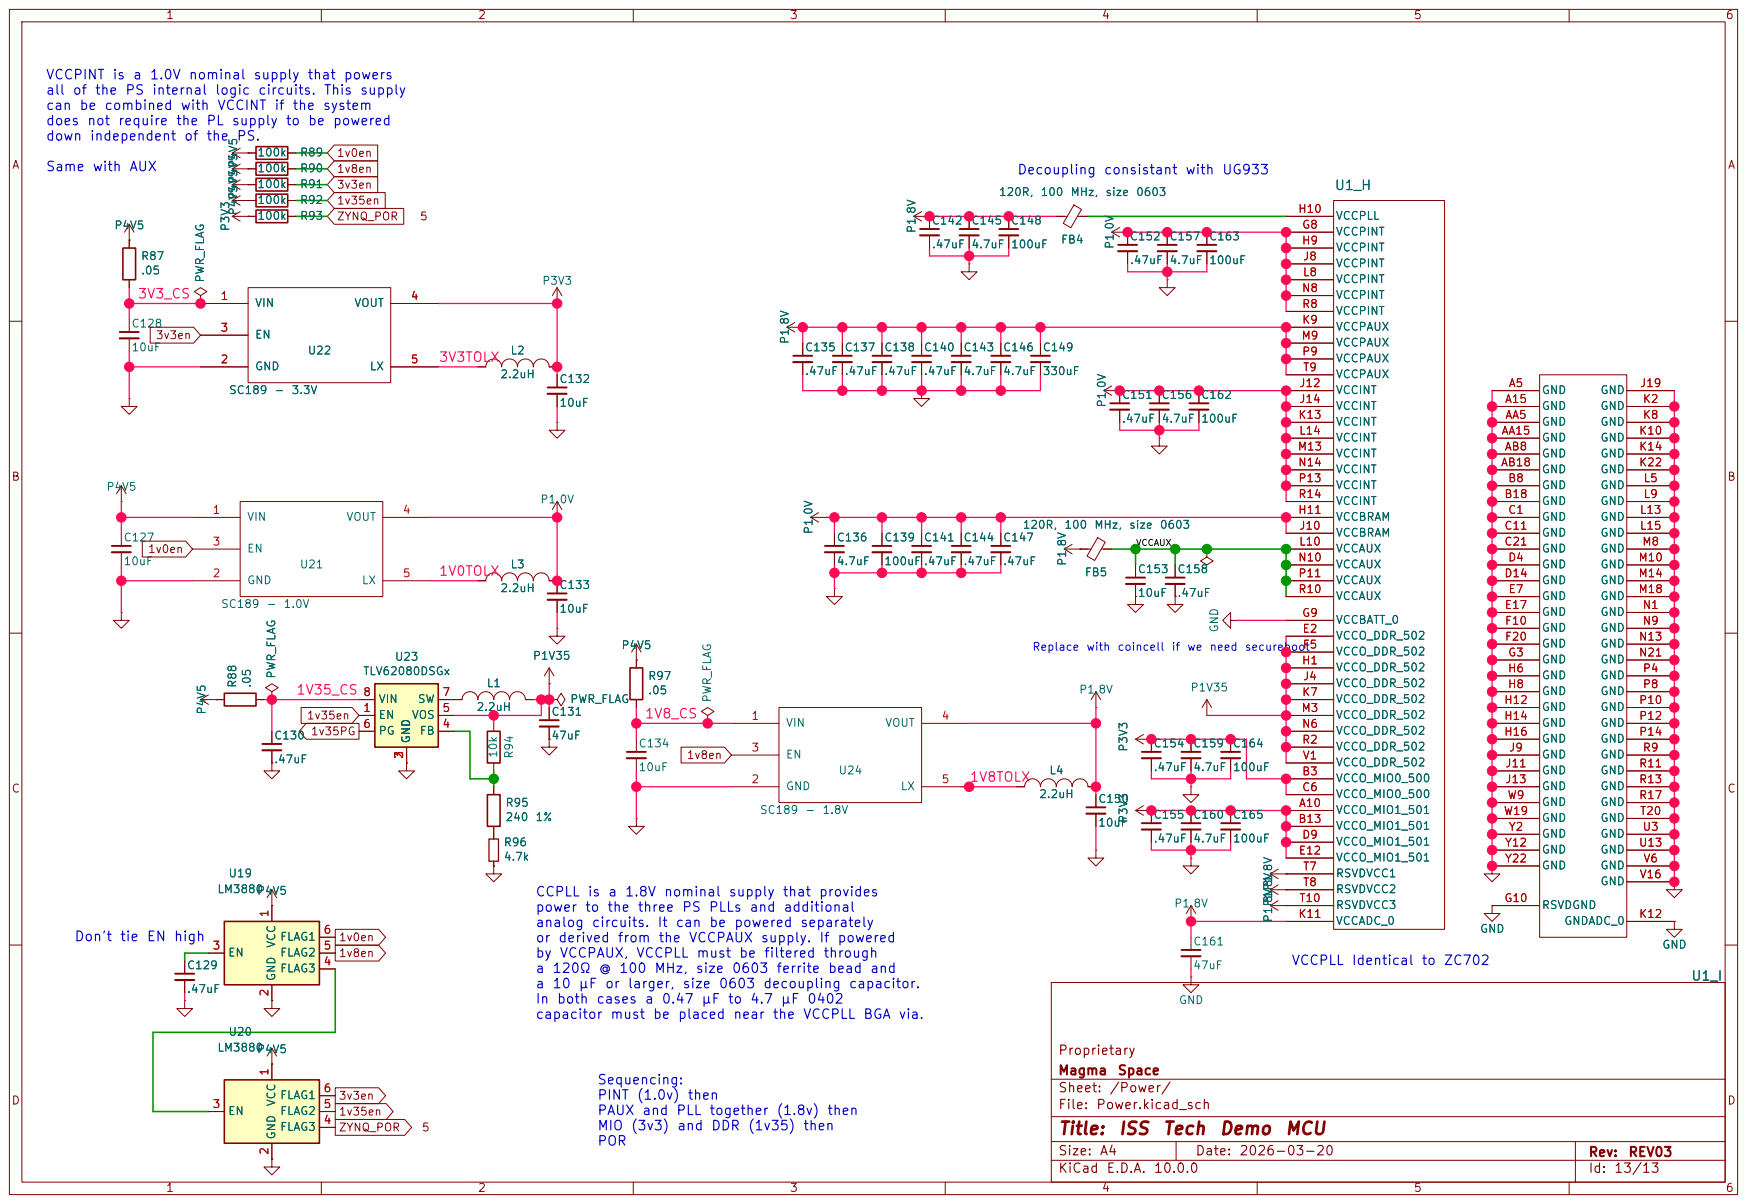
[picture p27: page 13]

VCCPINT is a 1.0V nominal supply that powers all of the PS internal logic circuits. This supply can be combined with VCCINT if the system

does not require the PL supply to be powered
down independent of the PS. Same with AUX
LM3880P4V5 PWR_FLAG R87

Decoupling consistant with UG933 CCPLL is a 1.8V nominal supply that provides power to the three PS PLLs and additional analog circuits. It can be powered separately or derived from the VCCPAUX supply. If powered

1V0TOLX Don't tie EN high

Replace with coincell if we need secureboot

by VCCPAUX, VCCPLL must be filtered through a 120Ω @ 100 MHz, size 0603 ferrite bead and

a 10 µF or larger, size 0603 decoupling capacitor.
In both cases a 0.47 µF to 4.7 µF 0402
capacitor must be placed near the VCCPLL BGA via.

Magma Space
Sheet: /Power/
D Date: 2026-03-20 KiCad E.D.A. 10.0.0
File: Power.kicad_sch
Title: ISS Tech Demo MCU

Sequencing:
PINT (1.0v) then
PAUX and PLL together (1.8v) then MIO (3v3) and DDR (1v35) then POR
