CooterPMcGrew/Flight_Computer_REV01/ISS_MCU_REV03.pdf

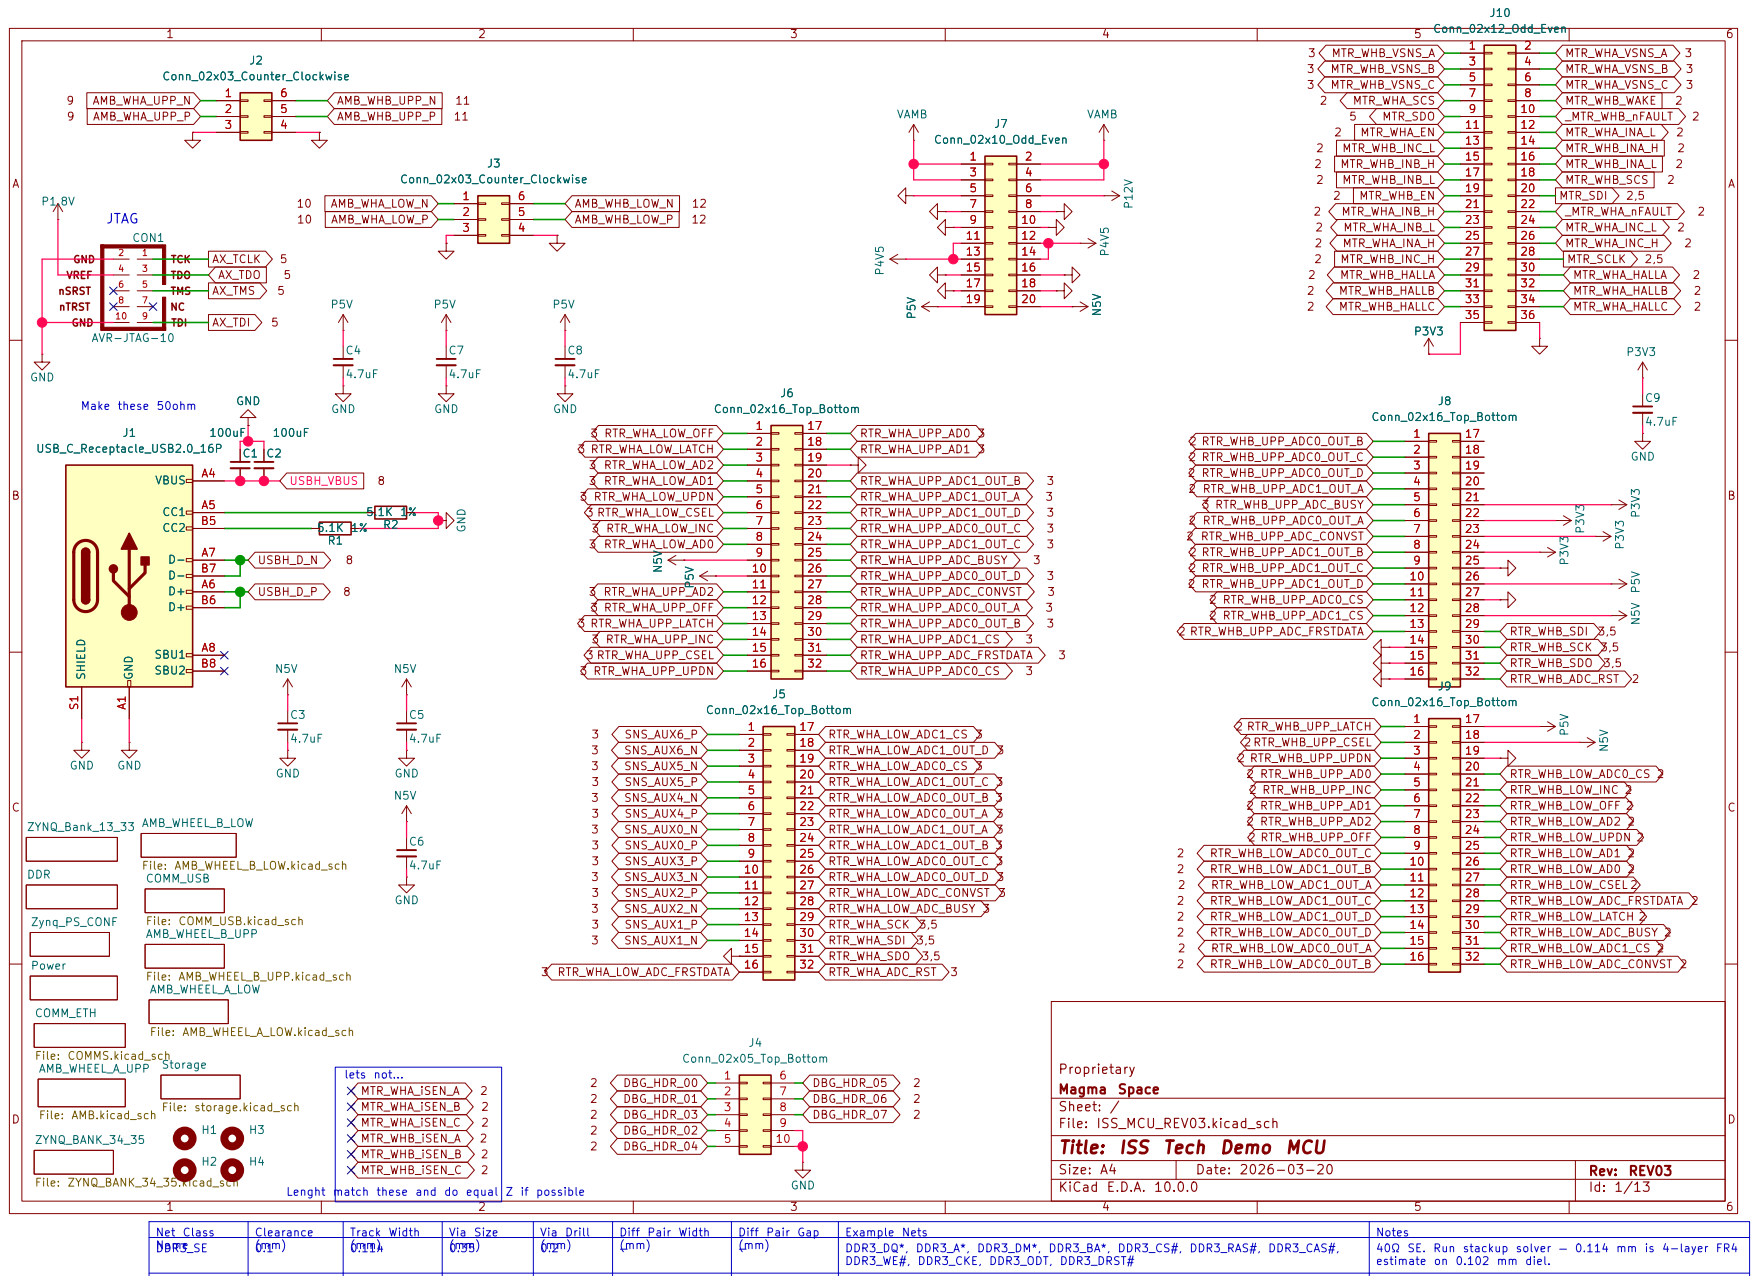
[picture p28: page 1]

File: storage.kicad_sch Power DDR

Proprietary
Magma Space
Sheet: /
D Date: 2026-03-20 KiCad E.D.A. 10.0.0
File: ISS_MCU_REV03.kicad_sch
Title: ISS Tech Demo MCU

Size: A4 | Rev: REV03

Net Class Name | Clearance 0.1 | Track Width 0.114 | Via Size 0.35 | Via Drill (mm) 0.2 | Diff Pair Width — | Diff Pair Gap — | Example Nets DDR3_DQ*, DDR3_A*, DDR3_DM*, DDR3_BA*, DDR3_CS#, DDR3_RAS#, DDR3_CAS#, | Notes DDR3_SE

(mm) | (mm) | (mm) | | (mm) | (mm) | DDR3_WE#, DDR3_CKE, DDR3_ODT, DDR3_DRST# | 40Ω SE. Run stackup solver — 0.114 mm is 4-layer FR4

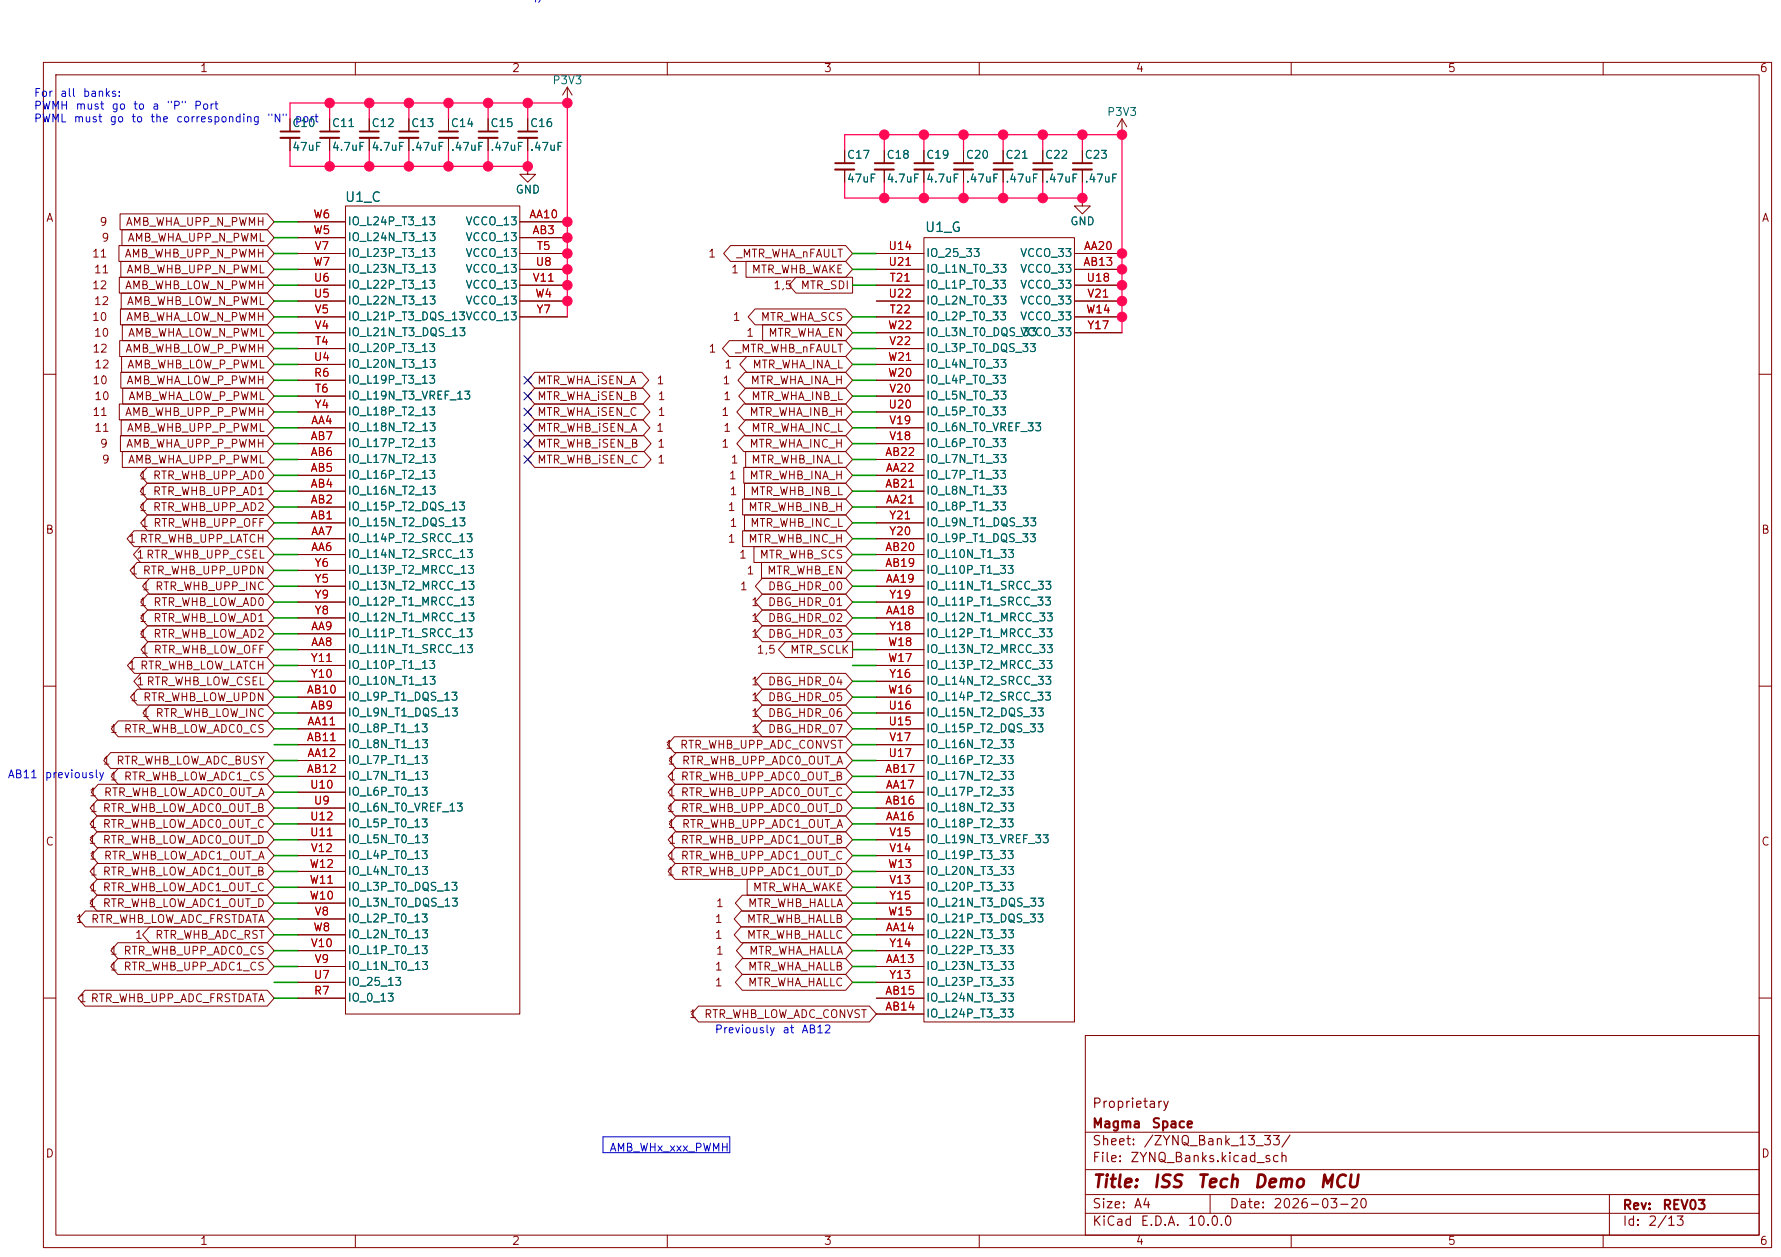
[picture p29: page 2]

Proprietary
Magma Space
Sheet: /ZYNQ_Bank_13_33/
D Date: 2026-03-20 KiCad E.D.A. 10.0.0
File: ZYNQ_Banks.kicad_sch
Title: ISS Tech Demo MCU

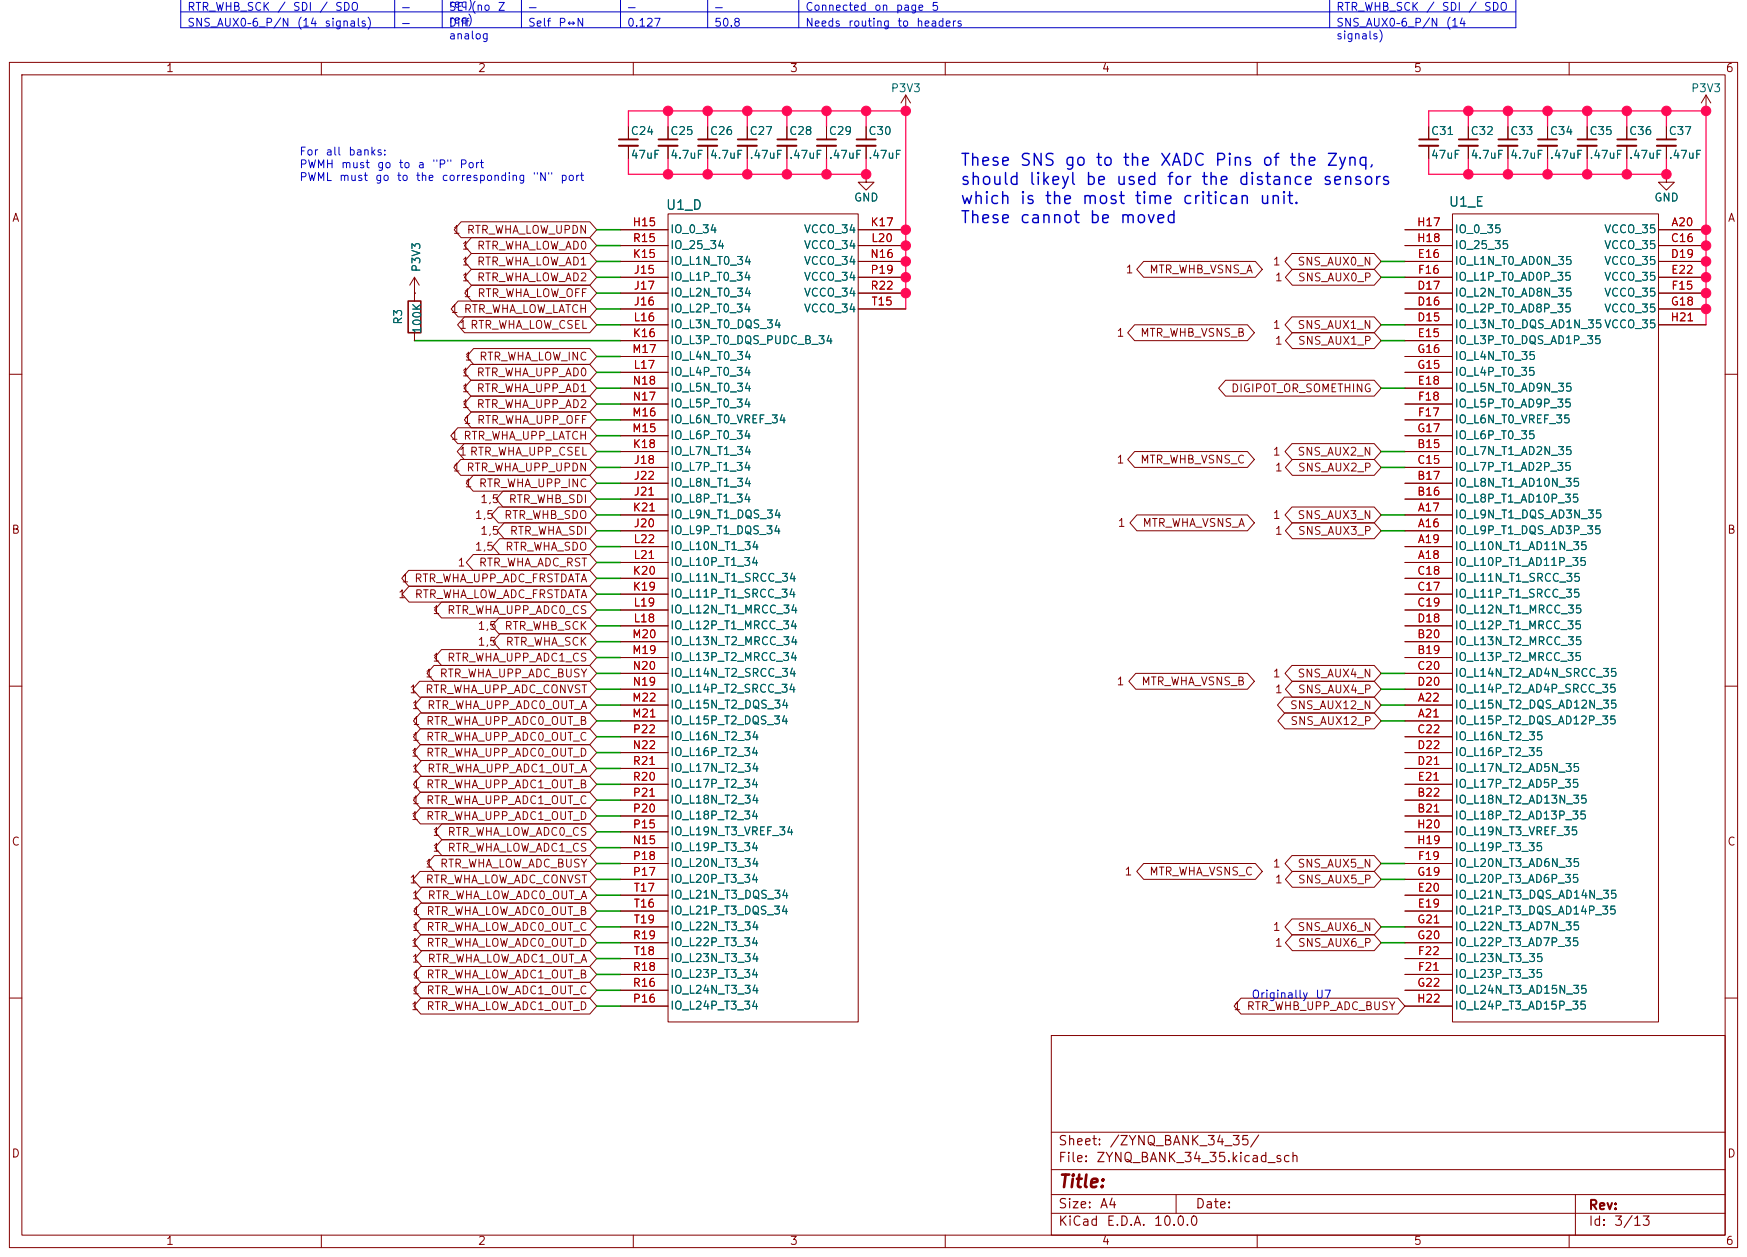
[picture p30: page 3]

For all banks: PWMH must go to a "P" Port PWML must go to the corresponding "N" port

These SNS go to the XADC Pins of the Zynq,
should likeyl be used for the distance sensors
which is the most time critican unit.
These cannot be moved

Size: A4 | Rev:
KiCad E.D.A. 10.0.0

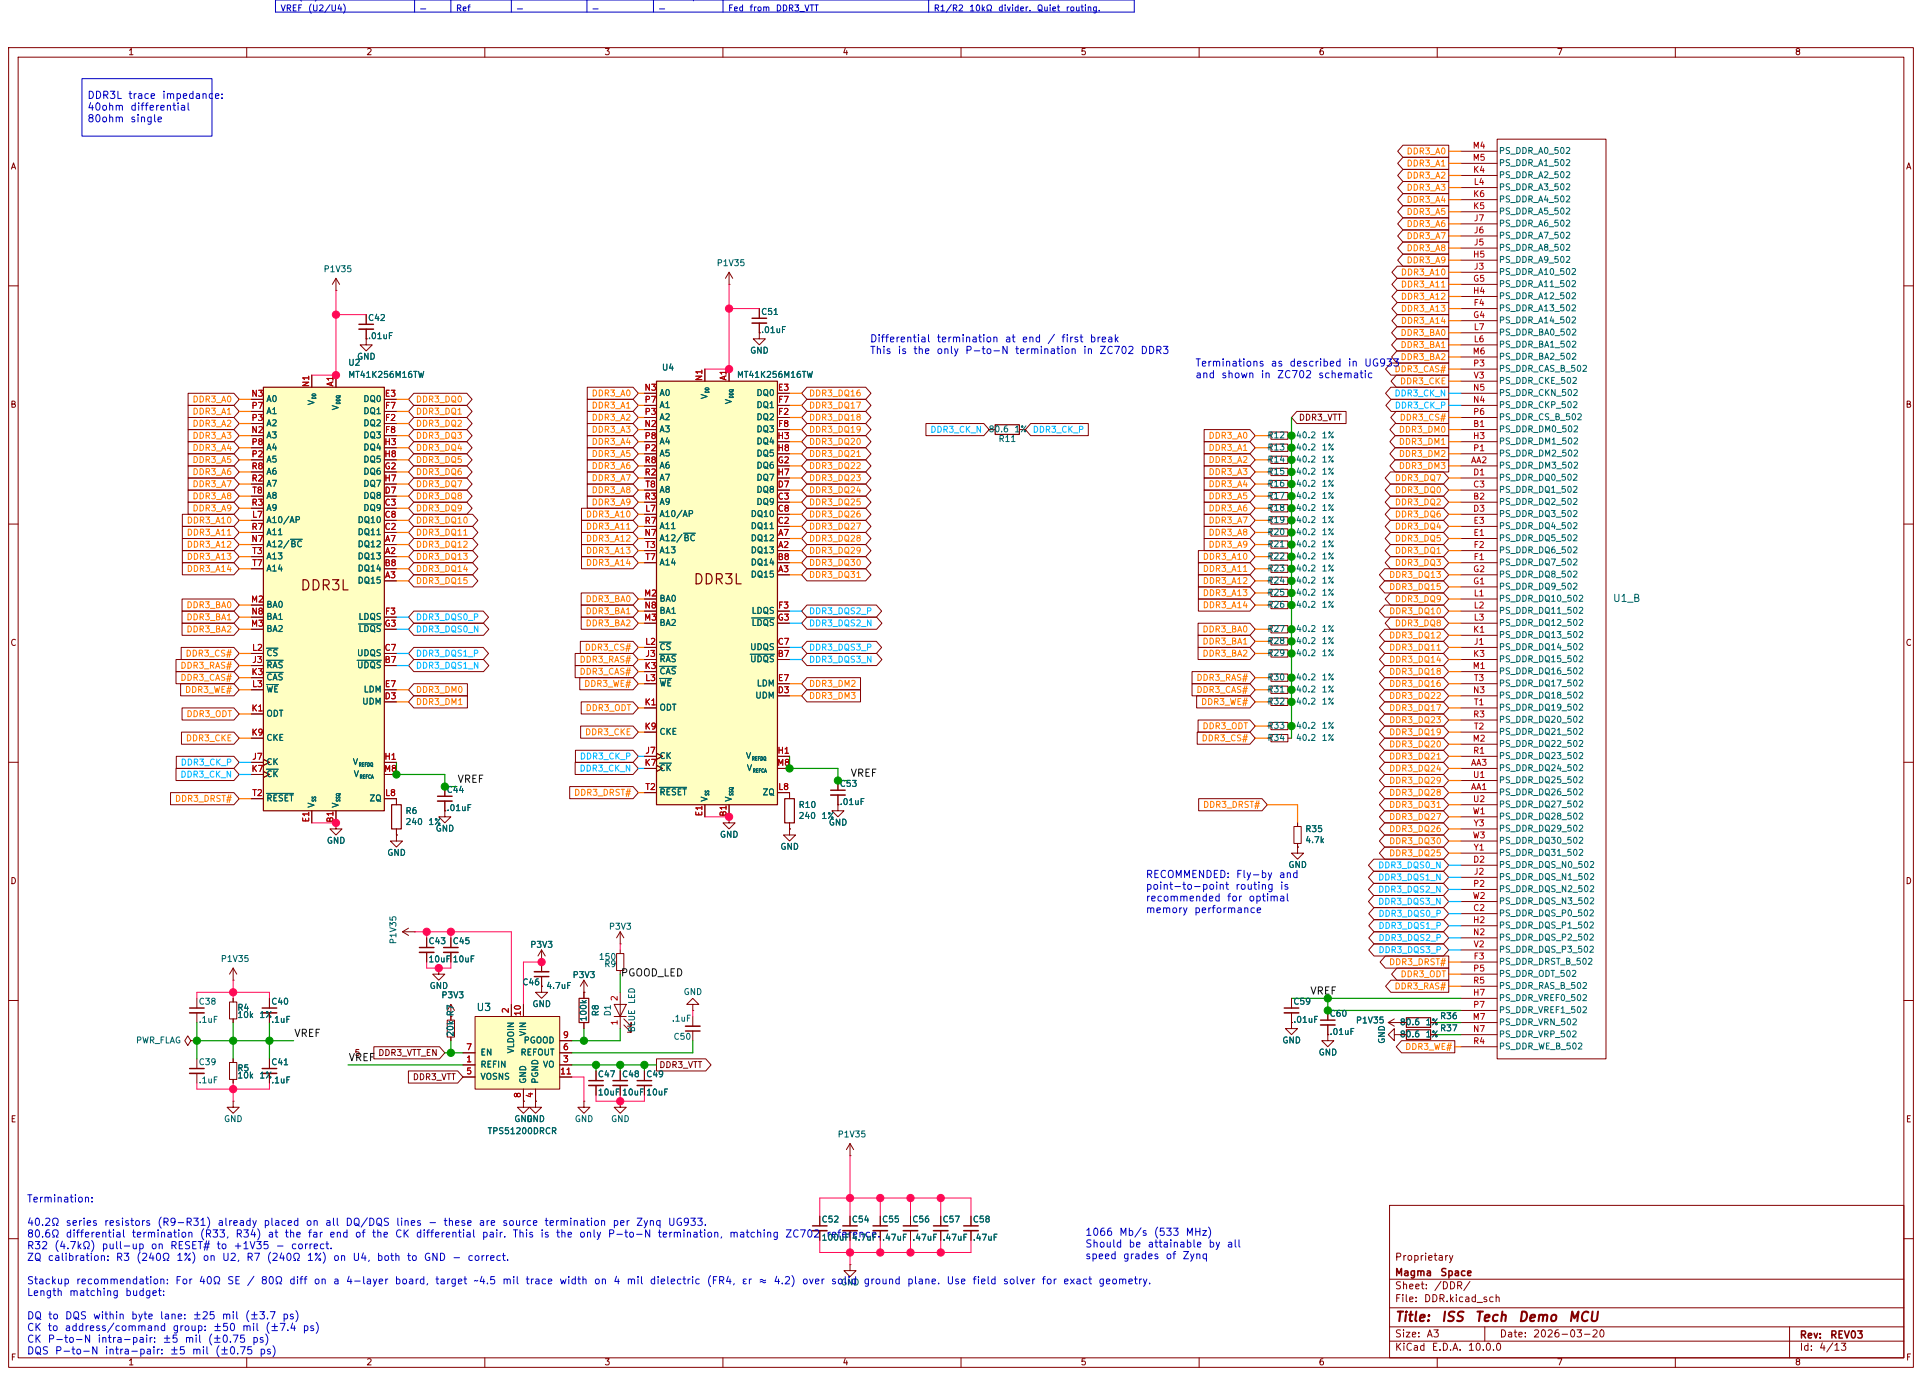
[picture p31: page 4]

and shown in ZC702 schematic Differential termination at end / first break
This is the only P-to-N termination in ZC702 DDR3

Terminations as described in UG933

RECOMMENDED: Fly-by and
point-to-point routing is
recommended for optimal memory performance

1066 Mb/s (533 MHz)
Should be attainable by all
speed grades of Zynq

Proprietary
Magma Space
Sheet: /DDR/
File: DDR.kicad_sch
Title: ISS Tech Demo MCU
F Date: 2026-03-20 KiCad E.D.A. 10.0.0

DQ to DQS within byte lane: ±25 mil (±3.7 ps)
CK to address/command group: ±50 mil (±7.4 ps)
CK P-to-N intra-pair: ±5 mil (±0.75 ps)
DQS P-to-N intra-pair: ±5 mil (±0.75 ps)

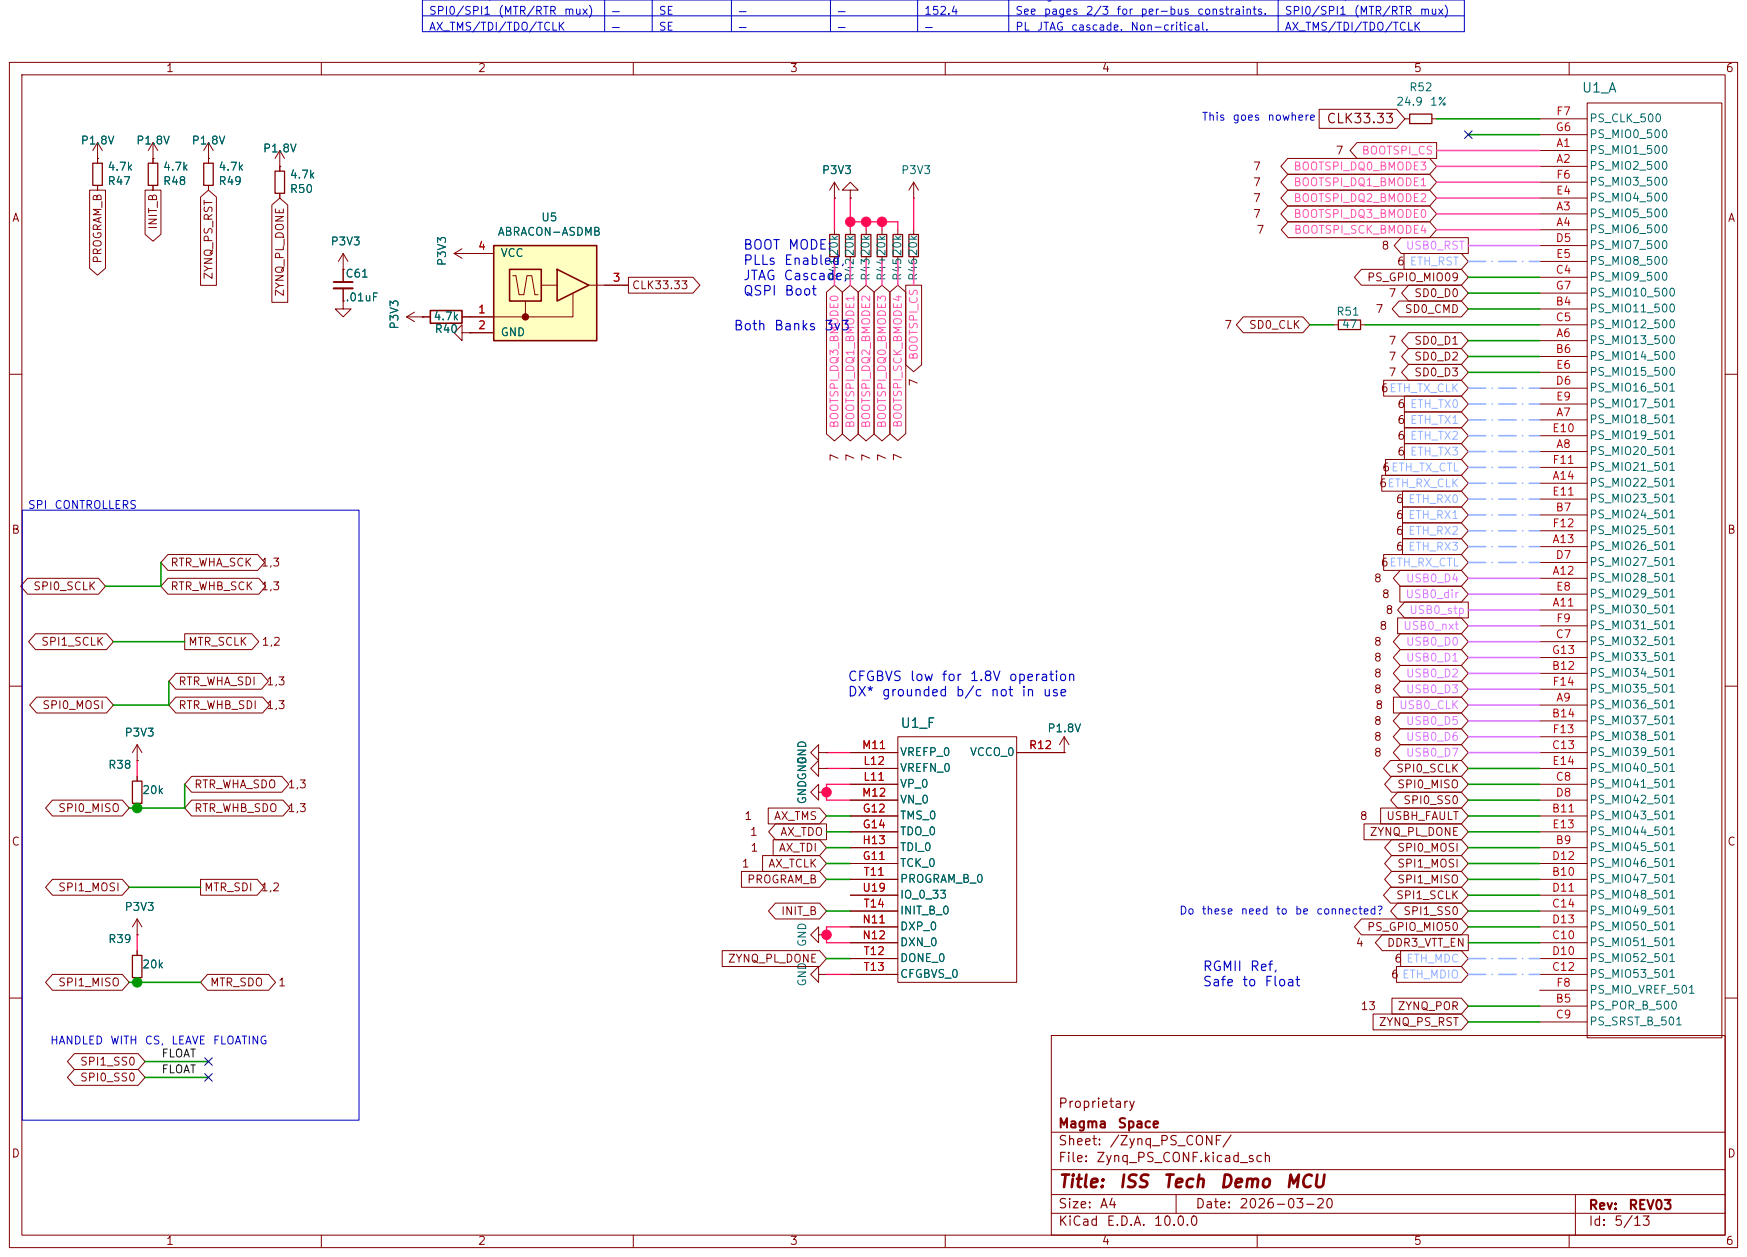
[picture p32: page 5]

SPI0/SPI1 (MTR/RTR mux) | — | SE | — | — | 152.4 | See pages 2/3 for per-bus constraints. | SPI0/SPI1 (MTR/RTR mux)
AX_TMS/TDI/TDO/TCLK | — | SE | — | — | — | PL JTAG cascade. Non-critical. | AX_TMS/TDI/TDO/TCLK

This goes nowhere SPI CONTROLLERS HANDLED WITH CS, LEAVE FLOATING

DX* grounded b/c not in use BOOT MODE: PLLs Enabled,

Do these need to be connected? CFGBVS low for 1.8V operation
TMS_0 G12
TDO_0 G14
TDI_0 H13
TCK_0 G11

Magma Space
Sheet: /Zynq_PS_CONF/
D Date: 2026-03-20 KiCad E.D.A. 10.0.0
File: Zynq_PS_CONF.kicad_sch
Title: ISS Tech Demo MCU

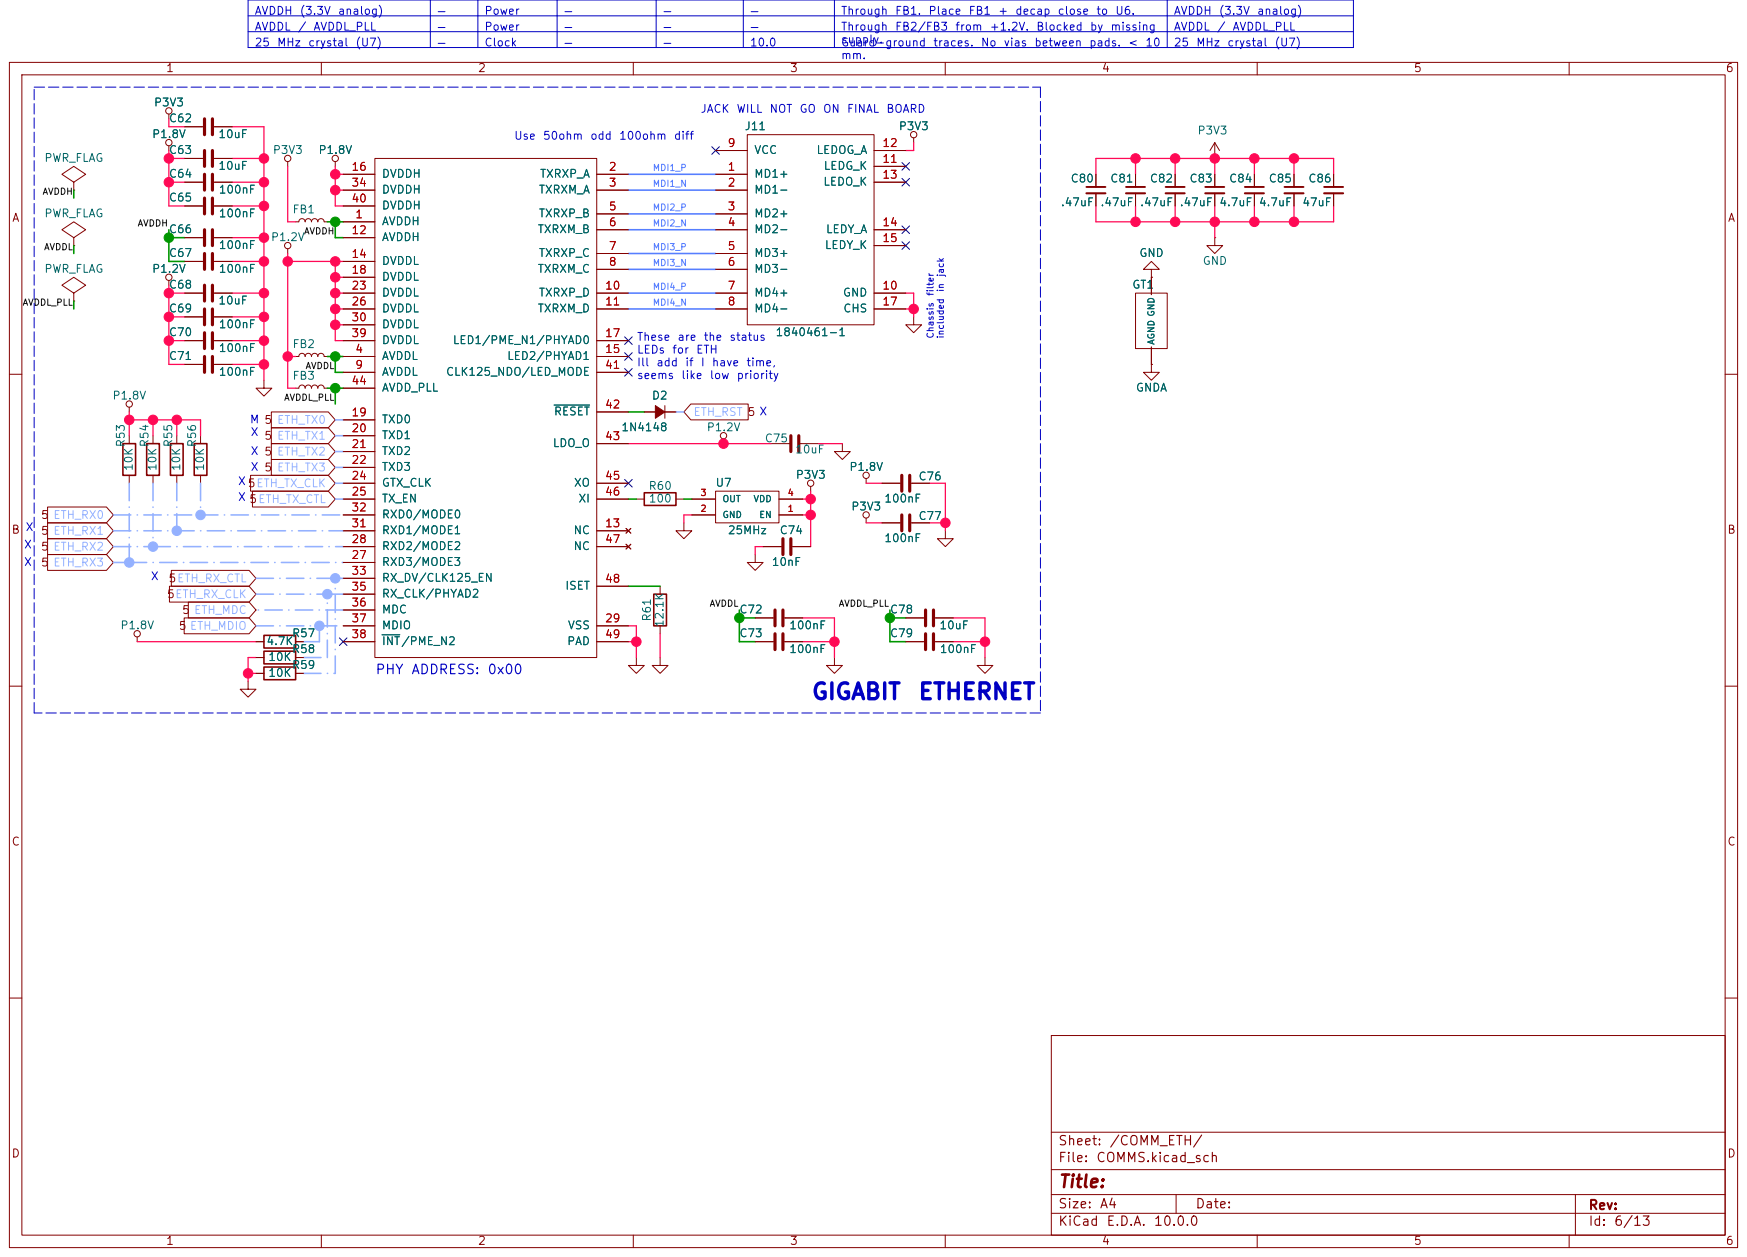
[picture p33: page 6]

AVDDL / AVDDL_PLL | — | Power | — | — | — | Through FB2/FB3 from +1.2V. Blocked by missing

supply.

JACK WILL NOT GO ON FINAL BOARD Use 50ohm odd 100ohm diff X

These are the status
LEDs for ETH

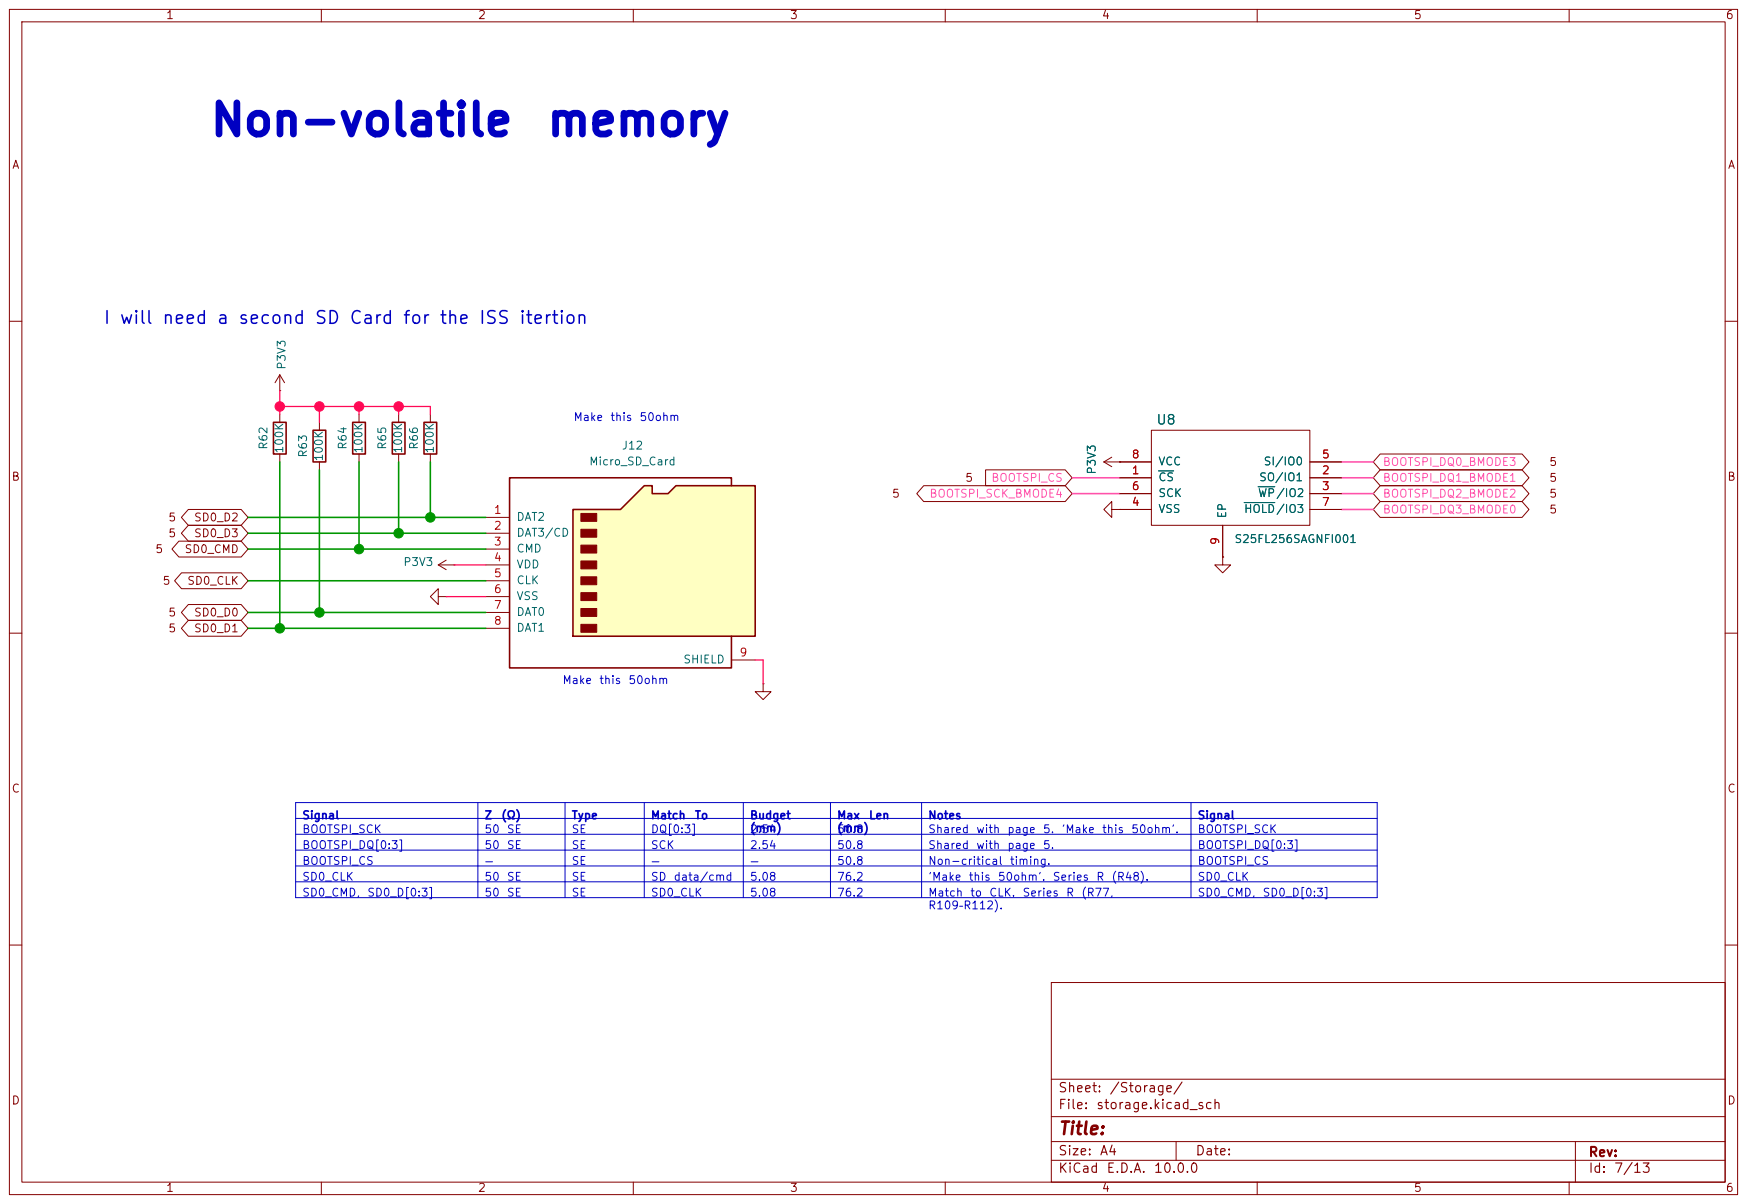
[picture p34: page 7]

Signal | Z (Ω) 50 SE | Type SE | Match To DQ[0:3] | Budget 2.54 | Max Len (mm) 50.8 | Notes Shared with page 5. 'Make this 50ohm'. | Signal BOOTSPI_SCK BOOTSPI_SCK

BOOTSPI_DQ[0:3] | 50 SE — | SE SE | SCK — | 2.54 — | 50.8 | Shared with page 5. Non-critical timing. | BOOTSPI_DQ[0:3] BOOTSPI_CS BOOTSPI_CS

SD0_CLK | 50 SE | SE | SD data/cmd | 5.08 | 76.2 | 'Make this 50ohm'. Series R (R48). | SD0_CLK
SD0_CMD, SD0_D[0:3] | 50 SE | SE | SD0_CLK | 5.08 | 76.2 | Match to CLK. Series R (R77, | SD0_CMD, SD0_D[0:3]

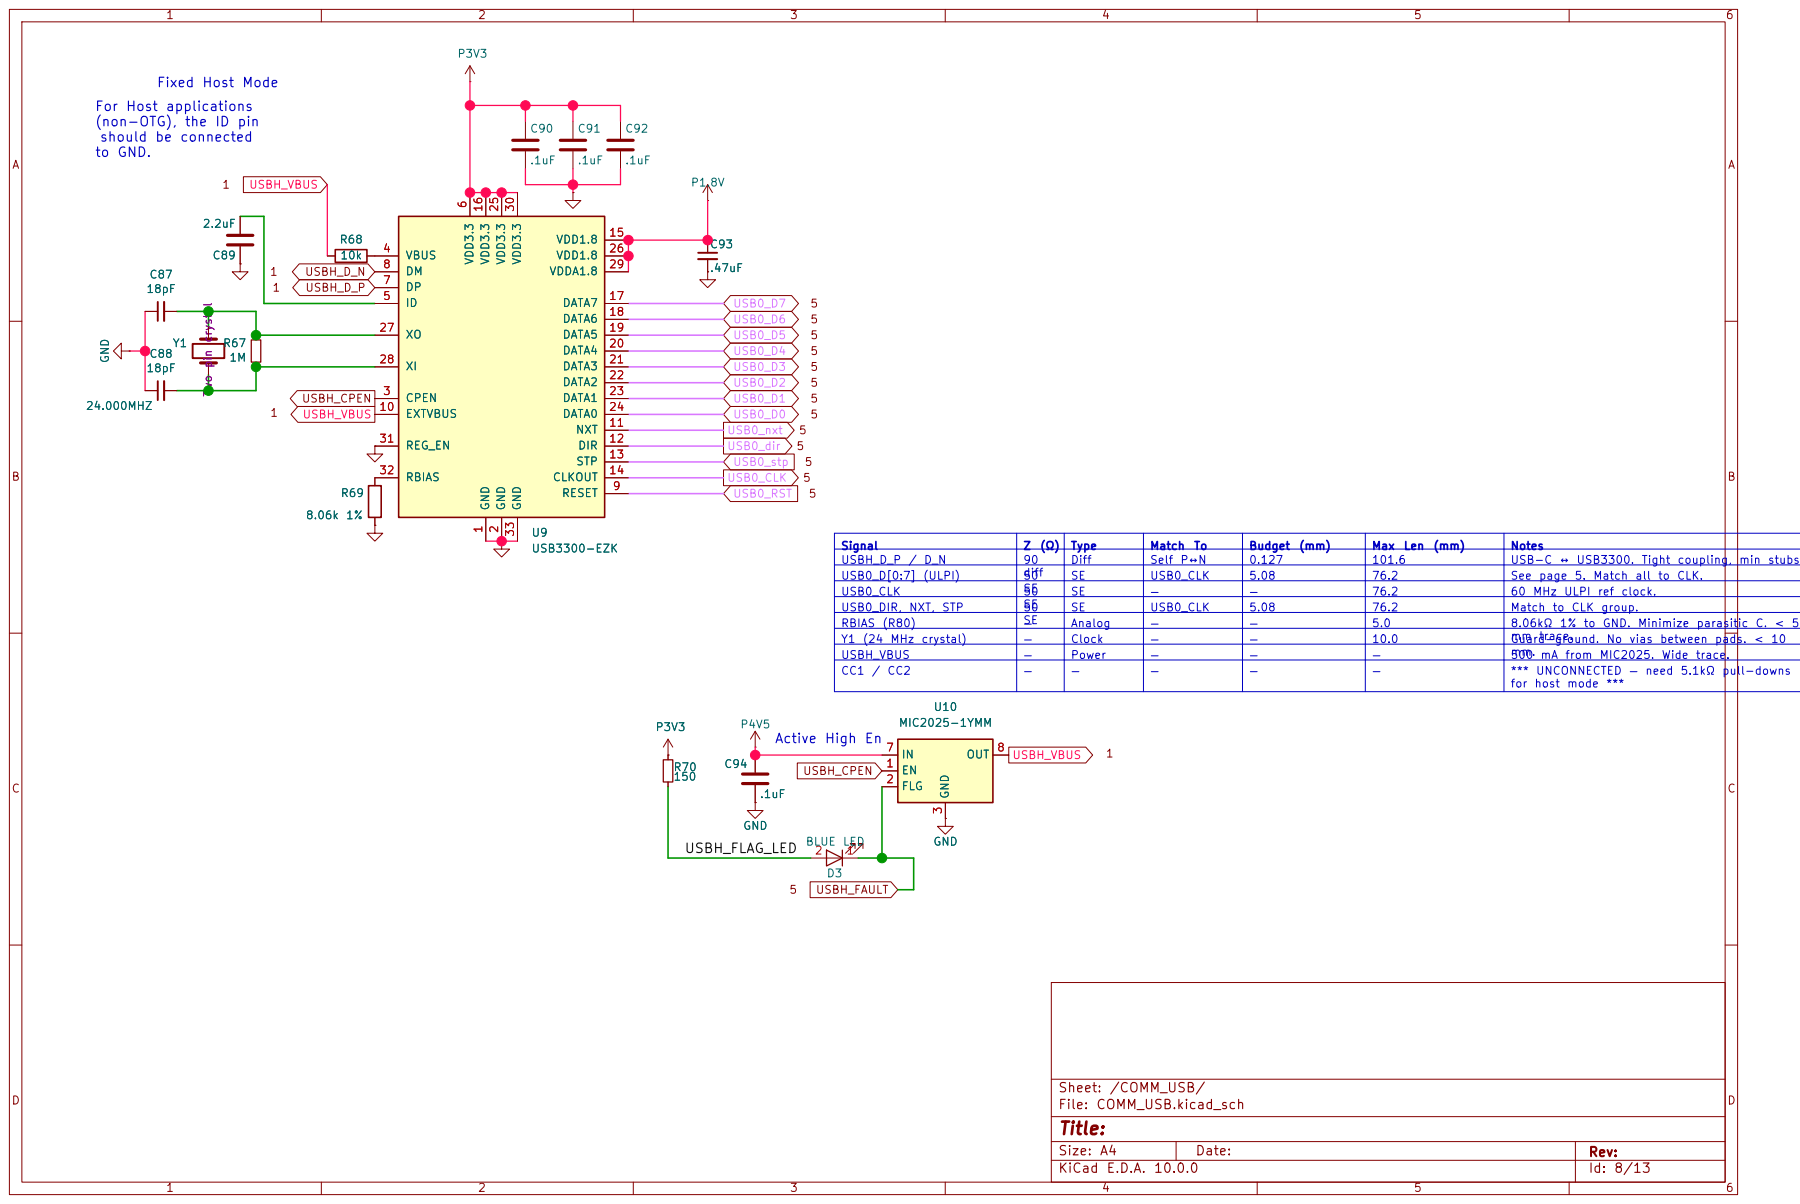
[picture p35: page 8]

For Host applications
(non-OTG), the ID pin
should be connected

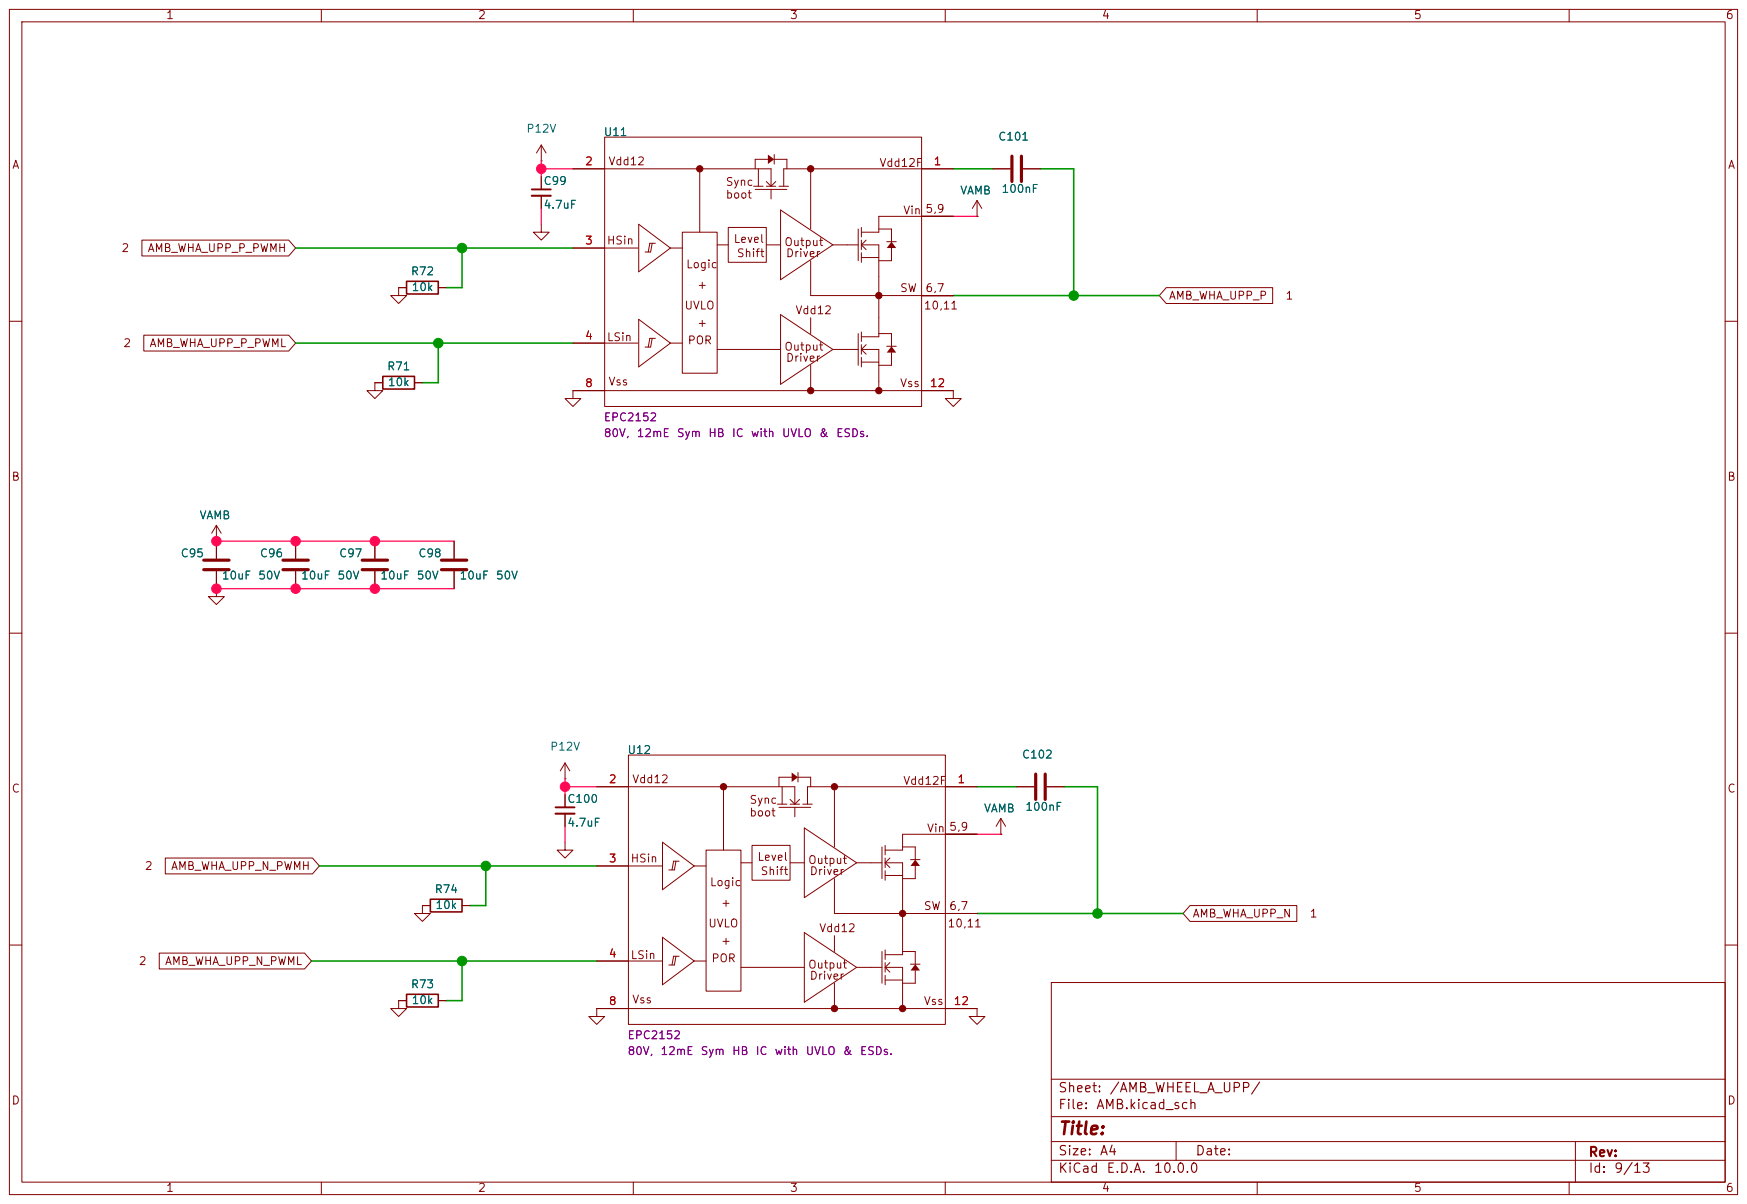
[picture p36: page 9]

80V, 12mE Sym HB IC with UVLO & ESDs. C100

EPC2152
80V, 12mE Sym HB IC with UVLO & ESDs.

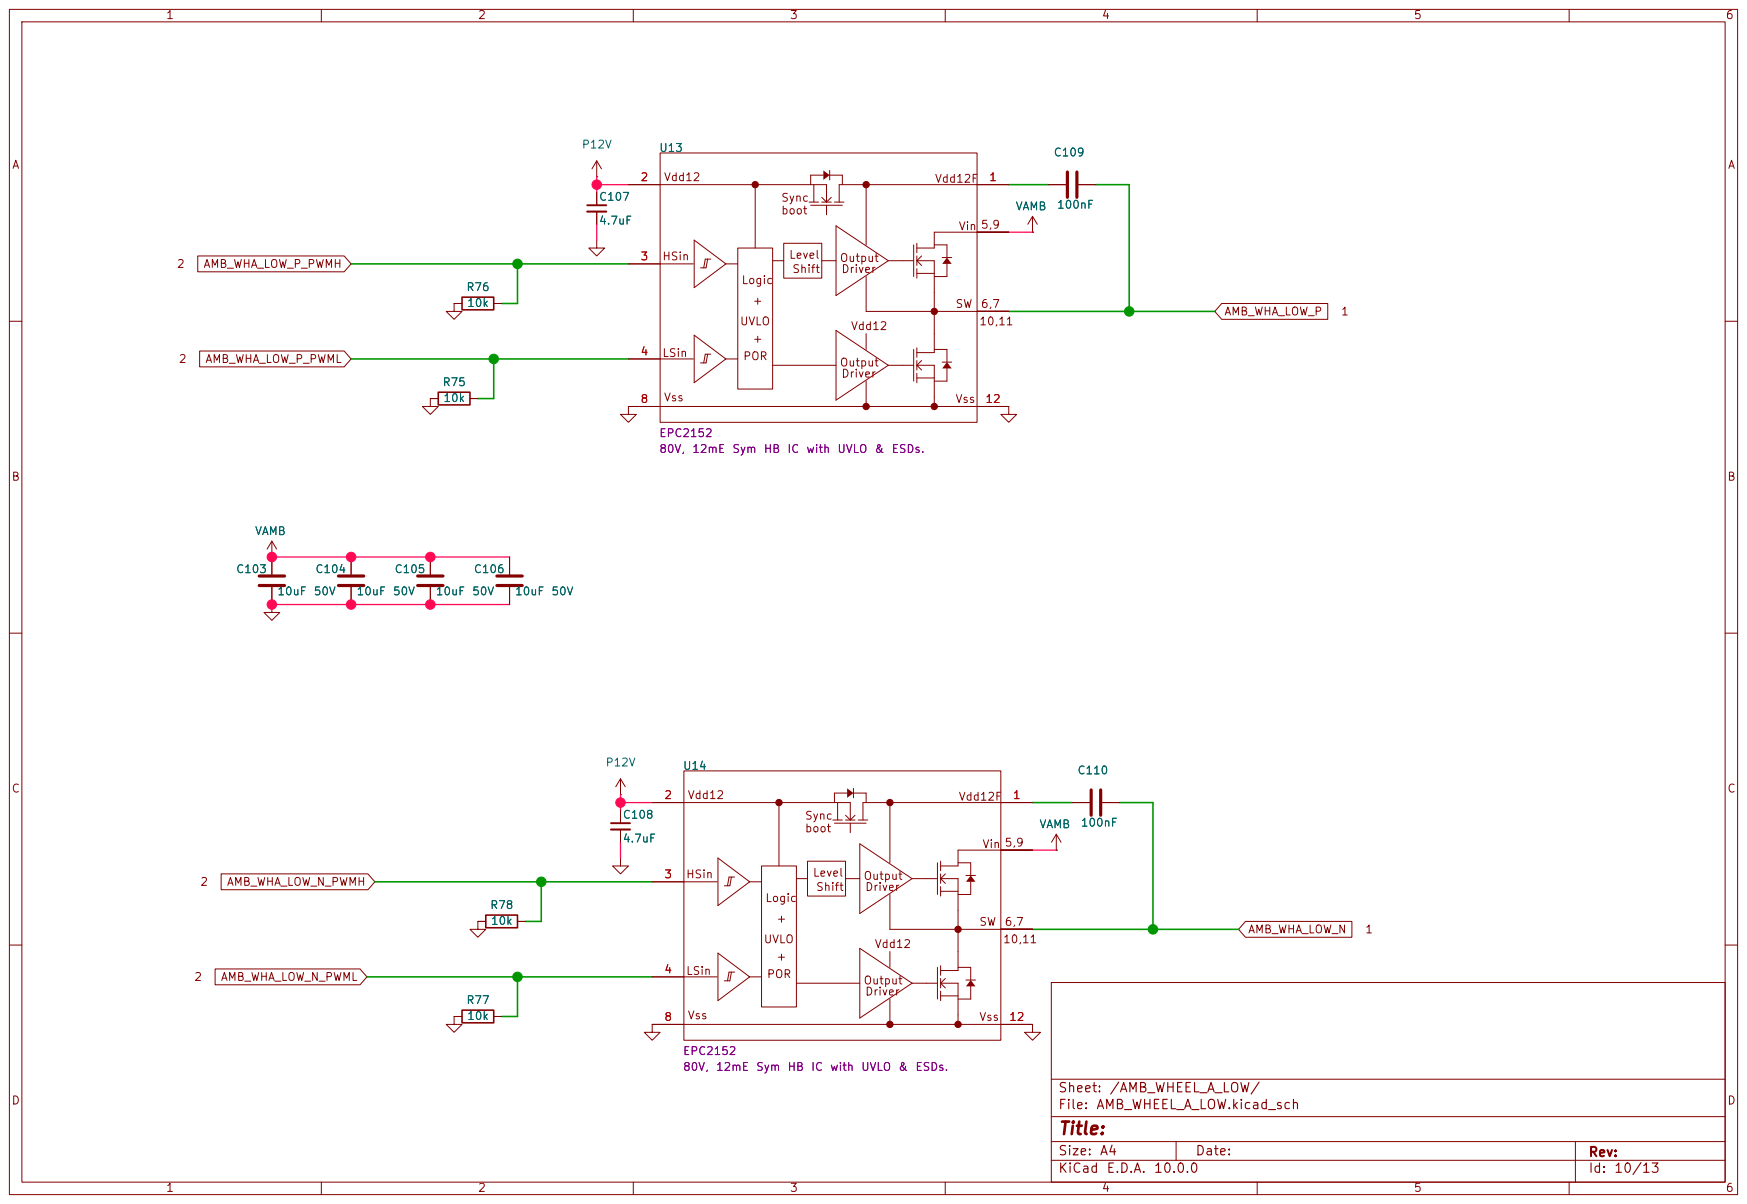
[picture p37: page 10]

EPC2152
80V, 12mE Sym HB IC with UVLO & ESDs.


80V, 12mE Sym HB IC with UVLO & ESDs. C113

EPC2152
80V, 12mE Sym HB IC with UVLO & ESDs.


80V, 12mE Sym HB IC with UVLO & ESDs. C124

EPC2152
80V, 12mE Sym HB IC with UVLO & ESDs.

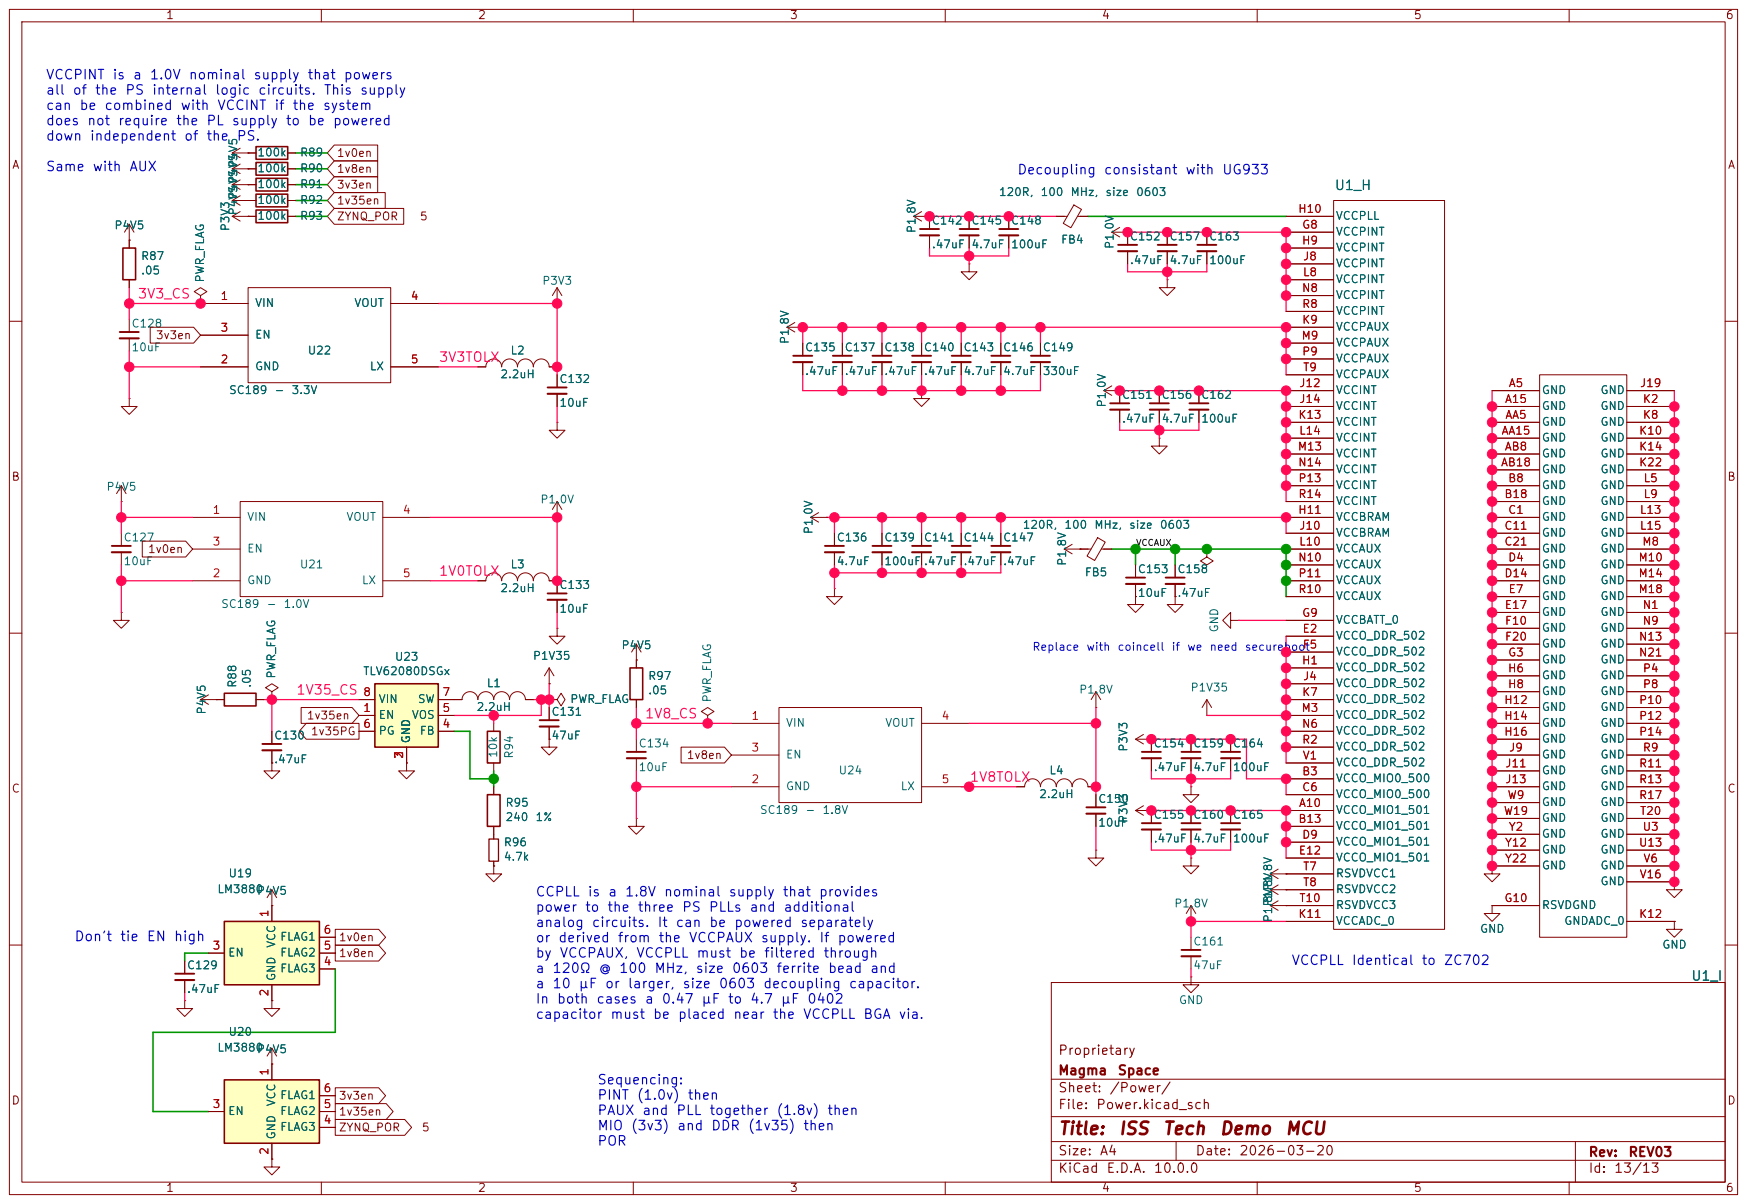
[picture p38: page 13]

VCCPINT is a 1.0V nominal supply that powers all of the PS internal logic circuits. This supply can be combined with VCCINT if the system

does not require the PL supply to be powered
down independent of the PS. Same with AUX

Decoupling consistant with UG933 CCPLL is a 1.8V nominal supply that provides power to the three PS PLLs and additional analog circuits. It can be powered separately or derived from the VCCPAUX supply. If powered

1V0TOLX Don't tie EN high

Replace with coincell if we need secureboot

by VCCPAUX, VCCPLL must be filtered through a 120Ω @ 100 MHz, size 0603 ferrite bead and

a 10 µF or larger, size 0603 decoupling capacitor.
In both cases a 0.47 µF to 4.7 µF 0402
capacitor must be placed near the VCCPLL BGA via.

Proprietary
Magma Space
Sheet: /Power/
D Date: 2026-03-20 KiCad E.D.A. 10.0.0
File: Power.kicad_sch
Title: ISS Tech Demo MCU

Sequencing:
PINT (1.0v) then
PAUX and PLL together (1.8v) then MIO (3v3) and DDR (1v35) then POR
