CooterPMcGrew/Flight_Computer_REV01/AMB.kicad_sch

## KiCad design AMB.kicad_sch (2026-05-14)

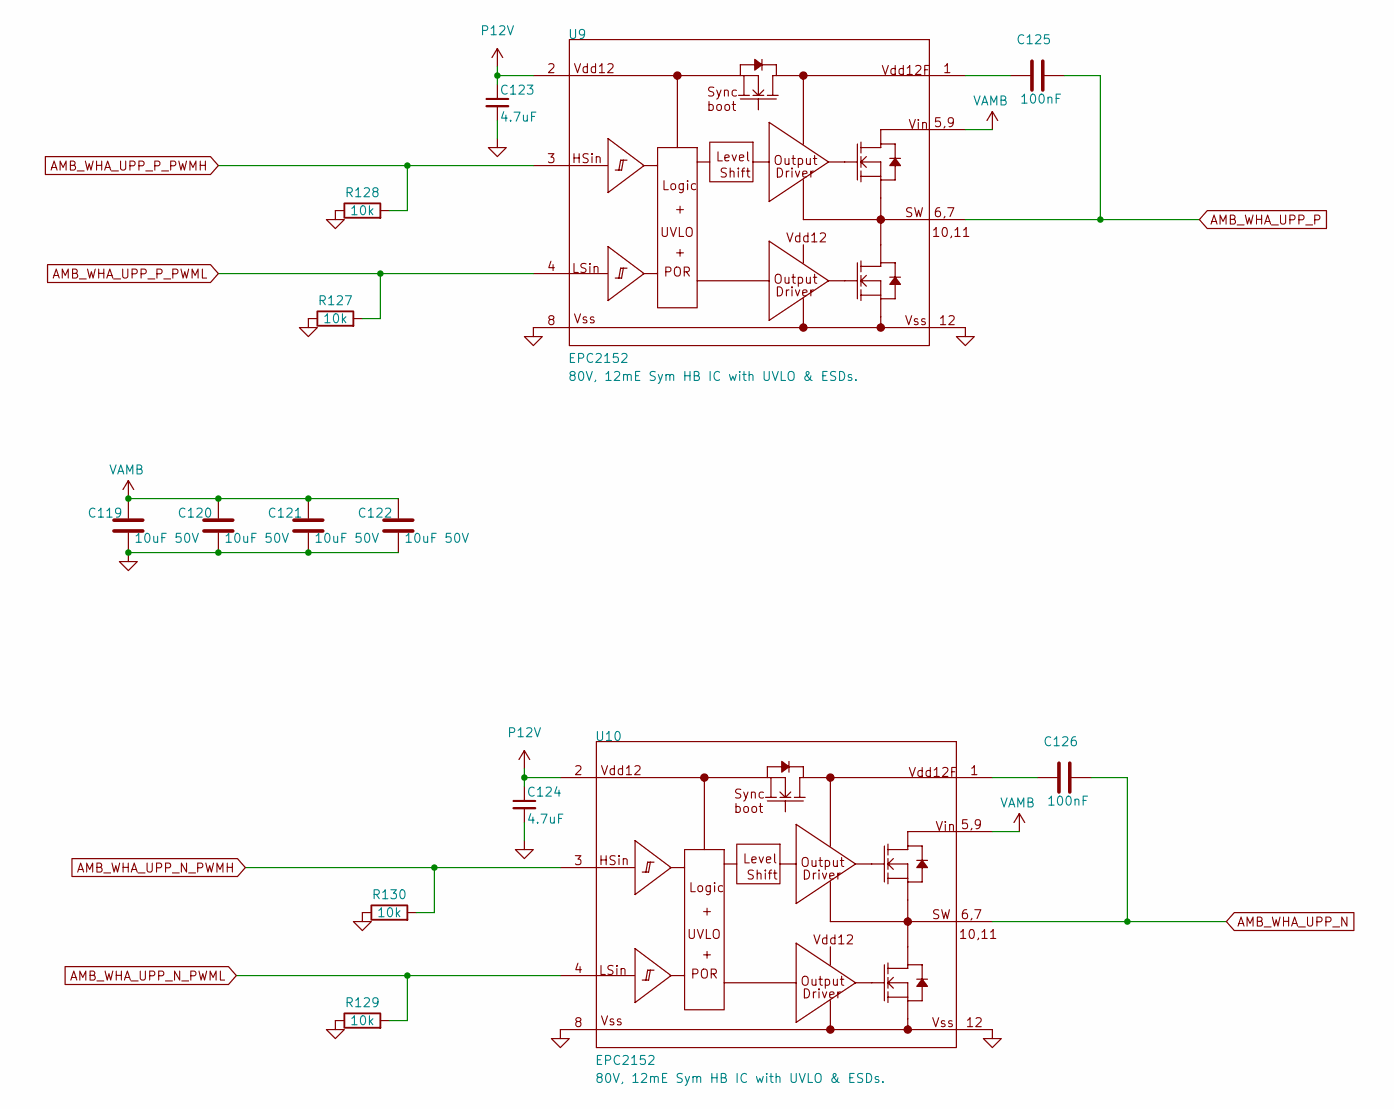
[picture p39: schematic AMB.kicad_sch]

Parts:
C119, C120, C121, C122: 10uF 50V; C_0805_2012Metric
C123, C124: 4.7uF; C_0603_1608Metric
C125, C126: 100nF; C_0603_1608Metric
R127, R128, R129, R130: 10k; R_0402_1005Metric
U9, U10: EPC2152; D0122; PART NUMBER EPC2152

Connections:
AMB_WHA_UPP_N: C126.2, U10.6 (SW), U10.7 (SW), U10.10 (SW), U10.11 (SW)
AMB_WHA_UPP_N_PWMH: R130.2, U10.3 (HSin)
AMB_WHA_UPP_N_PWML: R129.2, U10.4 (LSin)
AMB_WHA_UPP_P: C125.2, U9.6 (SW), U9.7 (SW), U9.10 (SW), U9.11 (SW)
AMB_WHA_UPP_P_PWMH: R128.2, U9.3 (HSin)
AMB_WHA_UPP_P_PWML: R127.2, U9.4 (LSin)
GND: C119.2, C120.2, C121.2, C122.2, C123.2, C124.2, R127.1, R128.1, R129.1, R130.1, U9.8 (Vss), U9.12 (Vss), U10.8 (Vss), U10.12 (Vss)
unnamed: C125.1, U9.1 (Vdd12F)
unnamed: C126.1, U10.1 (Vdd12F)
P12V: C123.1, C124.1, U9.2 (Vdd12), U10.2 (Vdd12)
VAMB: C119.1, C120.1, C121.1, C122.1, U9.5 (Vin), U9.9 (Vin), U10.5 (Vin), U10.9 (Vin)
