CooterPMcGrew/Flight_Computer_REV01/AMB_WHEEL_A_LOW.kicad_sch

## KiCad design AMB_WHEEL_A_LOW.kicad_sch (2026-05-14)

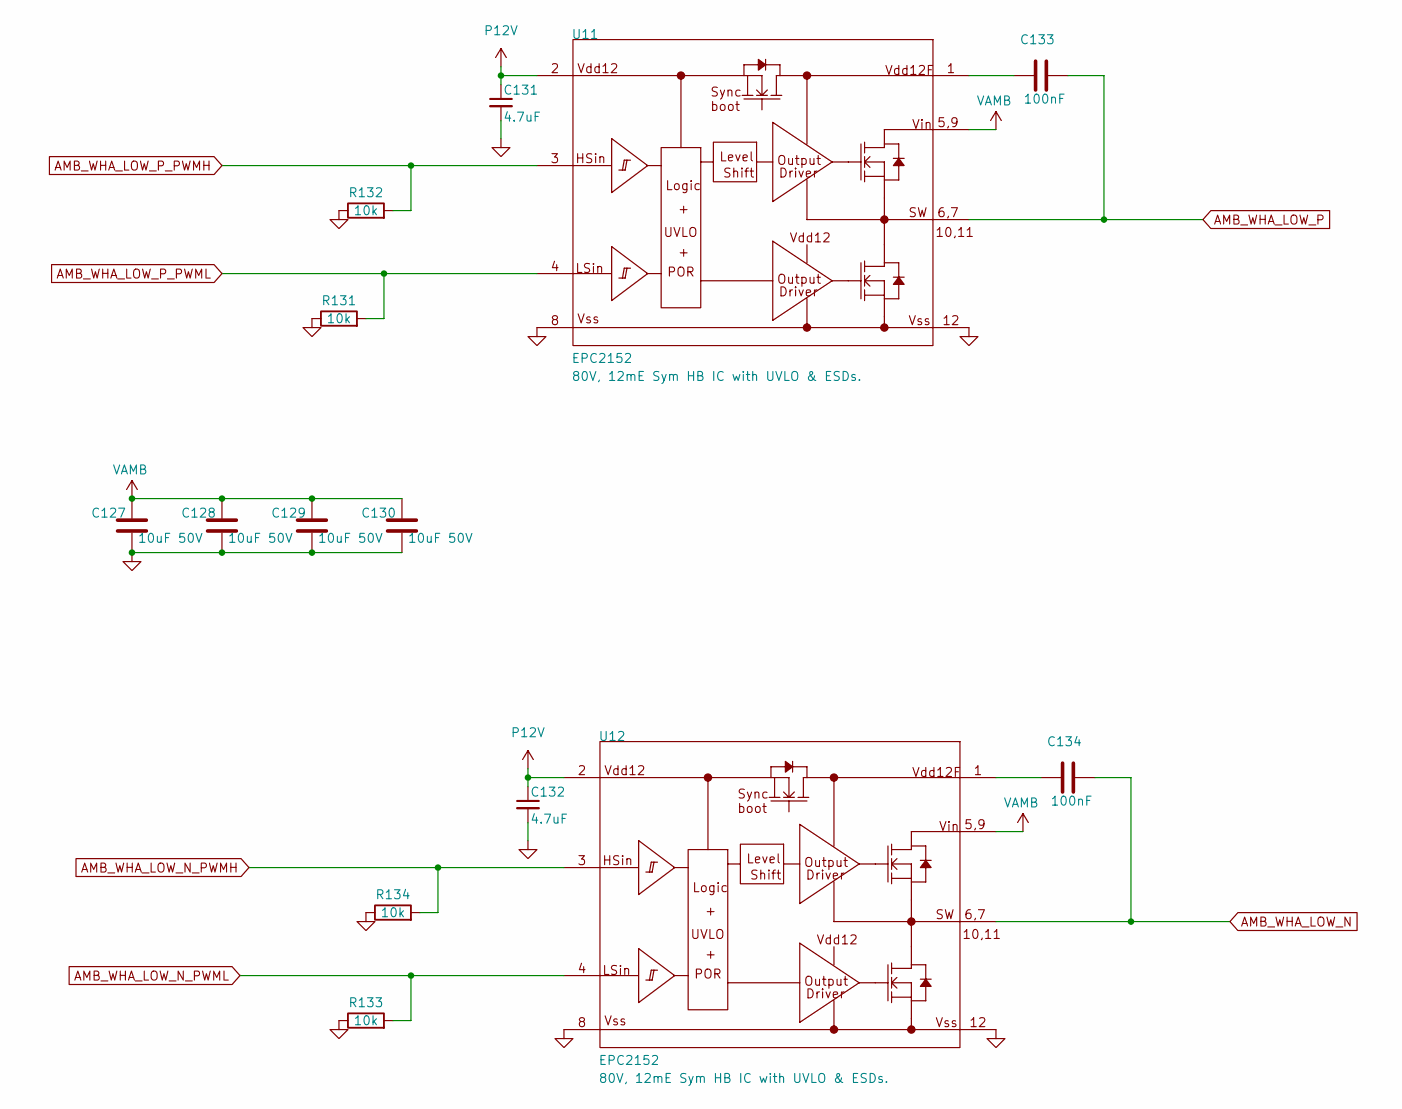
[picture p40: schematic AMB_WHEEL_A_LOW.kicad_sch]

Parts:
C127, C128, C129, C130: 10uF 50V; C_0805_2012Metric
C131, C132: 4.7uF; C_0603_1608Metric
C133, C134: 100nF; C_0603_1608Metric
R131, R132, R133, R134: 10k; R_0402_1005Metric
U11, U12: EPC2152; D0122; PART NUMBER EPC2152

Connections:
AMB_WHA_LOW_N: C134.2, U12.6 (SW), U12.7 (SW), U12.10 (SW), U12.11 (SW)
AMB_WHA_LOW_N_PWMH: R134.2, U12.3 (HSin)
AMB_WHA_LOW_N_PWML: R133.2, U12.4 (LSin)
AMB_WHA_LOW_P: C133.2, U11.6 (SW), U11.7 (SW), U11.10 (SW), U11.11 (SW)
AMB_WHA_LOW_P_PWMH: R132.2, U11.3 (HSin)
AMB_WHA_LOW_P_PWML: R131.2, U11.4 (LSin)
GND: C127.2, C128.2, C129.2, C130.2, C131.2, C132.2, R131.1, R132.1, R133.1, R134.1, U11.8 (Vss), U11.12 (Vss), U12.8 (Vss), U12.12 (Vss)
unnamed: C133.1, U11.1 (Vdd12F)
unnamed: C134.1, U12.1 (Vdd12F)
P12V: C131.1, C132.1, U11.2 (Vdd12), U12.2 (Vdd12)
VAMB: C127.1, C128.1, C129.1, C130.1, U11.5 (Vin), U11.9 (Vin), U12.5 (Vin), U12.9 (Vin)
