CooterPMcGrew/Flight_Computer_REV01/AMB_WHEEL_B_LOW.kicad_sch

## KiCad design AMB_WHEEL_B_LOW.kicad_sch (2026-05-14)

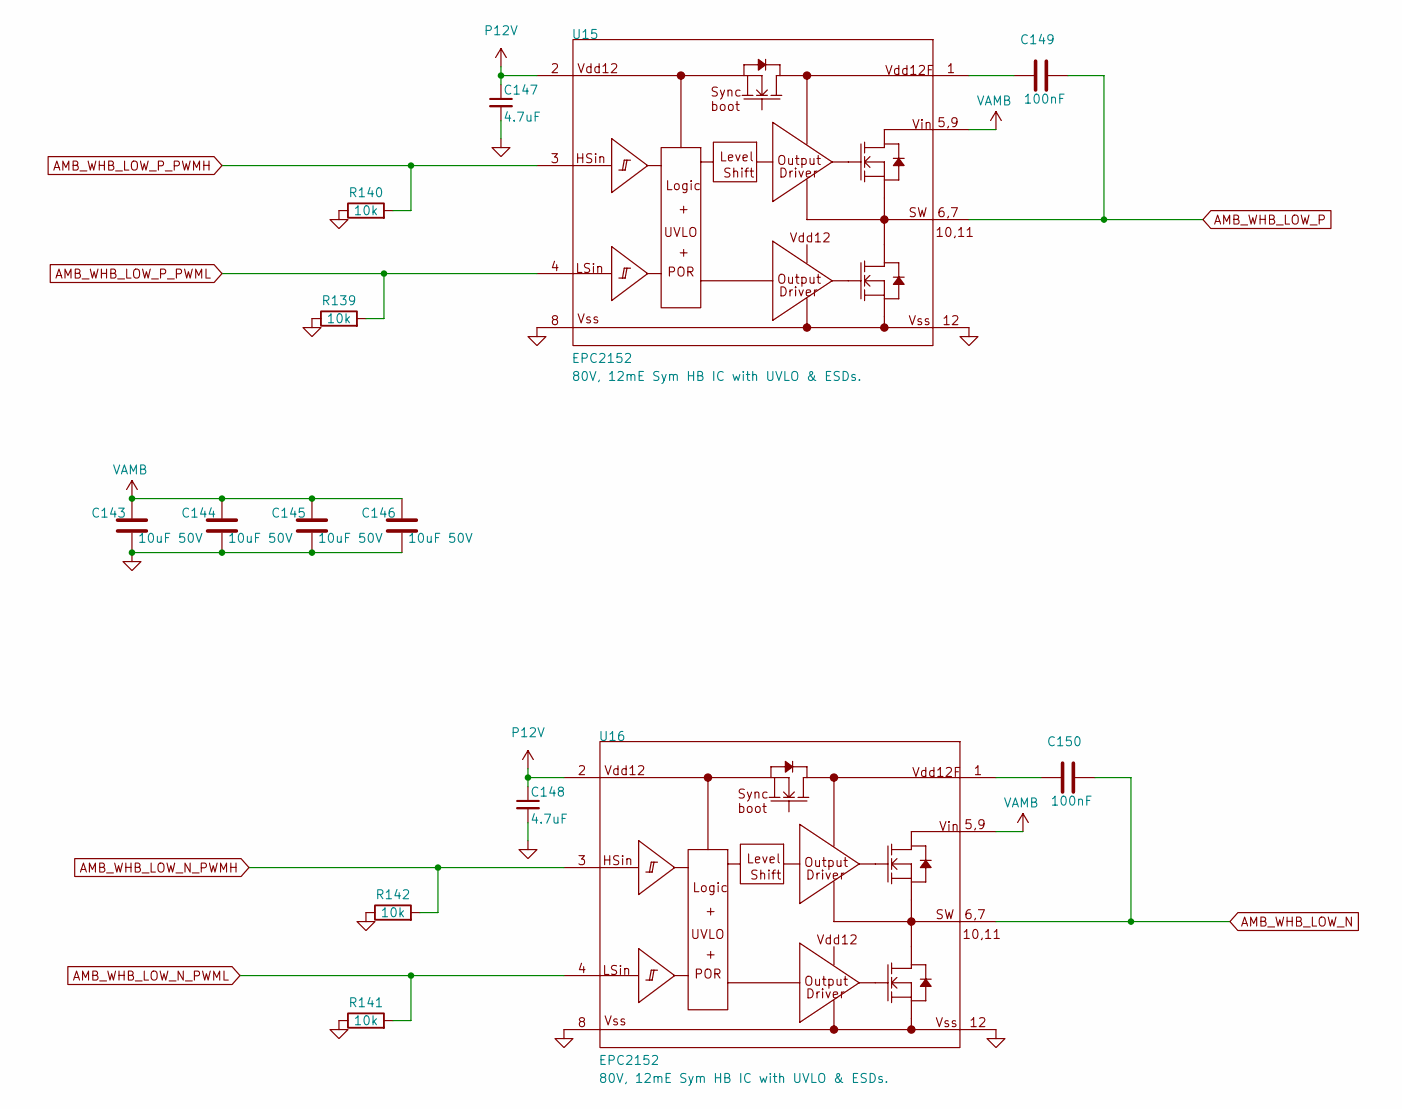
[picture p41: schematic AMB_WHEEL_B_LOW.kicad_sch]

Parts:
C143, C144, C145, C146: 10uF 50V; C_0805_2012Metric
C147, C148: 4.7uF; C_0603_1608Metric
C149, C150: 100nF; C_0603_1608Metric
R139, R140, R141, R142: 10k; R_0402_1005Metric
U15, U16: EPC2152; D0122; PART NUMBER EPC2152

Connections:
AMB_WHB_LOW_N: C150.2, U16.6 (SW), U16.7 (SW), U16.10 (SW), U16.11 (SW)
AMB_WHB_LOW_N_PWMH: R142.2, U16.3 (HSin)
AMB_WHB_LOW_N_PWML: R141.2, U16.4 (LSin)
AMB_WHB_LOW_P: C149.2, U15.6 (SW), U15.7 (SW), U15.10 (SW), U15.11 (SW)
AMB_WHB_LOW_P_PWMH: R140.2, U15.3 (HSin)
AMB_WHB_LOW_P_PWML: R139.2, U15.4 (LSin)
GND: C143.2, C144.2, C145.2, C146.2, C147.2, C148.2, R139.1, R140.1, R141.1, R142.1, U15.8 (Vss), U15.12 (Vss), U16.8 (Vss), U16.12 (Vss)
unnamed: C149.1, U15.1 (Vdd12F)
unnamed: C150.1, U16.1 (Vdd12F)
P12V: C147.1, C148.1, U15.2 (Vdd12), U16.2 (Vdd12)
VAMB: C143.1, C144.1, C145.1, C146.1, U15.5 (Vin), U15.9 (Vin), U16.5 (Vin), U16.9 (Vin)
