CooterPMcGrew/Flight_Computer_REV01/AMB_WHEEL_B_UPP.kicad_sch

## KiCad design AMB_WHEEL_B_UPP.kicad_sch (2026-05-14)

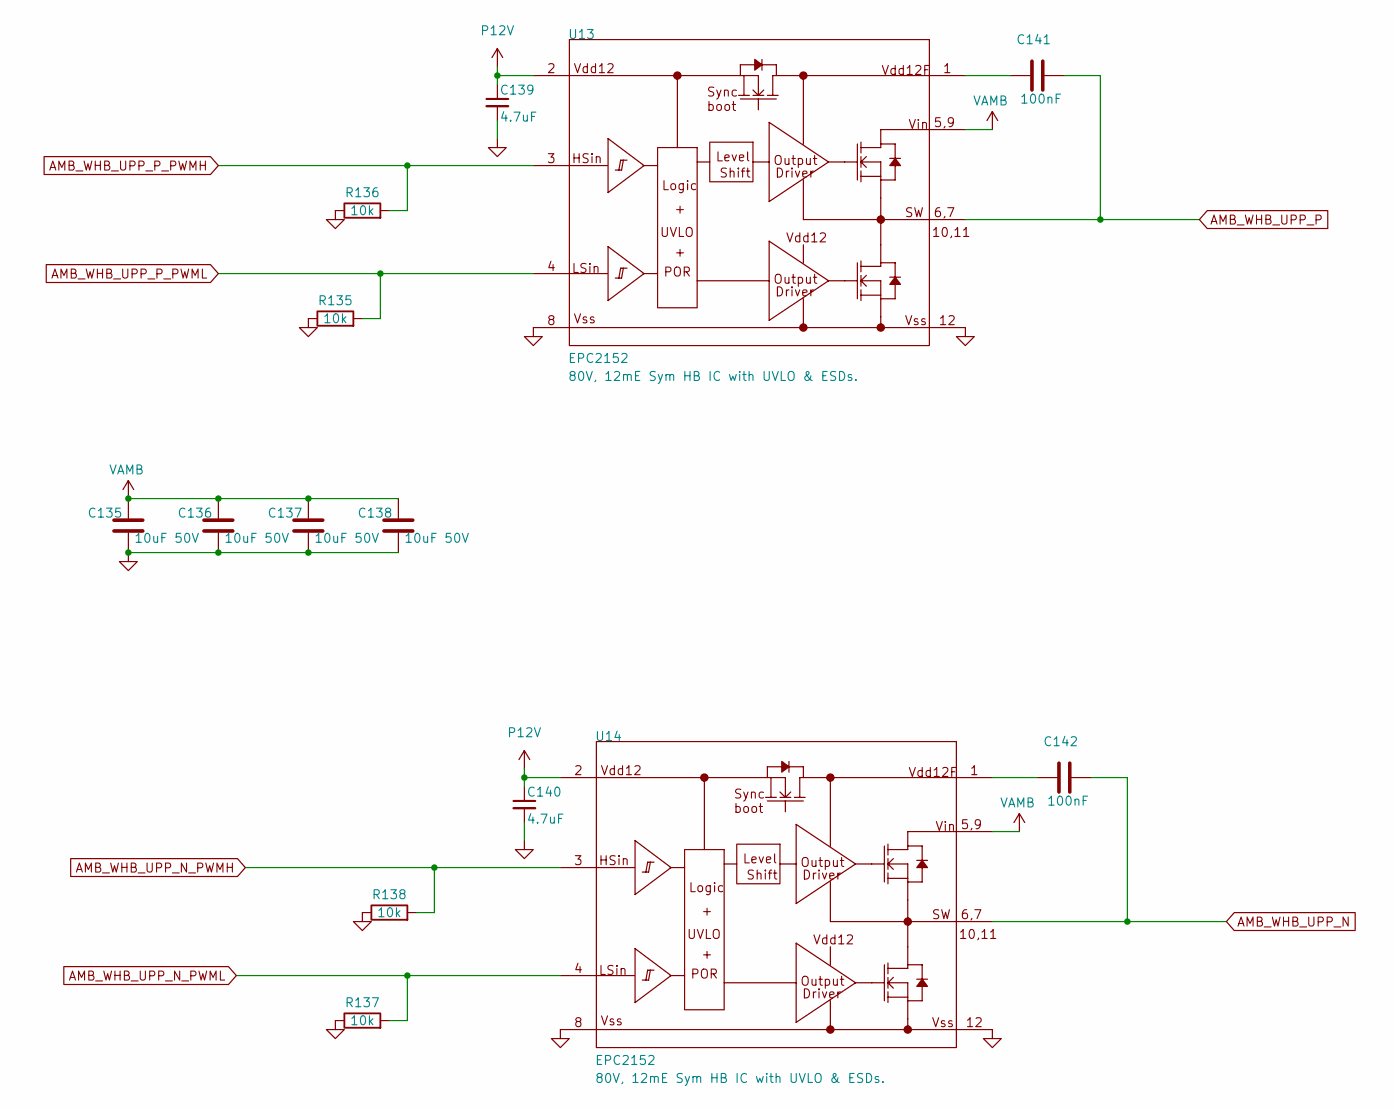
[picture p42: schematic AMB_WHEEL_B_UPP.kicad_sch]

Parts:
C135, C136, C137, C138: 10uF 50V; C_0805_2012Metric
C139, C140: 4.7uF; C_0603_1608Metric
C141, C142: 100nF; C_0603_1608Metric
R135, R136, R137, R138: 10k; R_0402_1005Metric
U13, U14: EPC2152; D0122; PART NUMBER EPC2152

Connections:
AMB_WHB_UPP_N: C142.2, U14.6 (SW), U14.7 (SW), U14.10 (SW), U14.11 (SW)
AMB_WHB_UPP_N_PWMH: R138.2, U14.3 (HSin)
AMB_WHB_UPP_N_PWML: R137.2, U14.4 (LSin)
AMB_WHB_UPP_P: C141.2, U13.6 (SW), U13.7 (SW), U13.10 (SW), U13.11 (SW)
AMB_WHB_UPP_P_PWMH: R136.2, U13.3 (HSin)
AMB_WHB_UPP_P_PWML: R135.2, U13.4 (LSin)
GND: C135.2, C136.2, C137.2, C138.2, C139.2, C140.2, R135.1, R136.1, R137.1, R138.1, U13.8 (Vss), U13.12 (Vss), U14.8 (Vss), U14.12 (Vss)
unnamed: C141.1, U13.1 (Vdd12F)
unnamed: C142.1, U14.1 (Vdd12F)
P12V: C139.1, C140.1, U13.2 (Vdd12), U14.2 (Vdd12)
VAMB: C135.1, C136.1, C137.1, C138.1, U13.5 (Vin), U13.9 (Vin), U14.5 (Vin), U14.9 (Vin)
