CooterPMcGrew/Flight_Computer_REV01/COMMS.kicad_sch

## KiCad design COMMS.kicad_sch (2026-05-14)

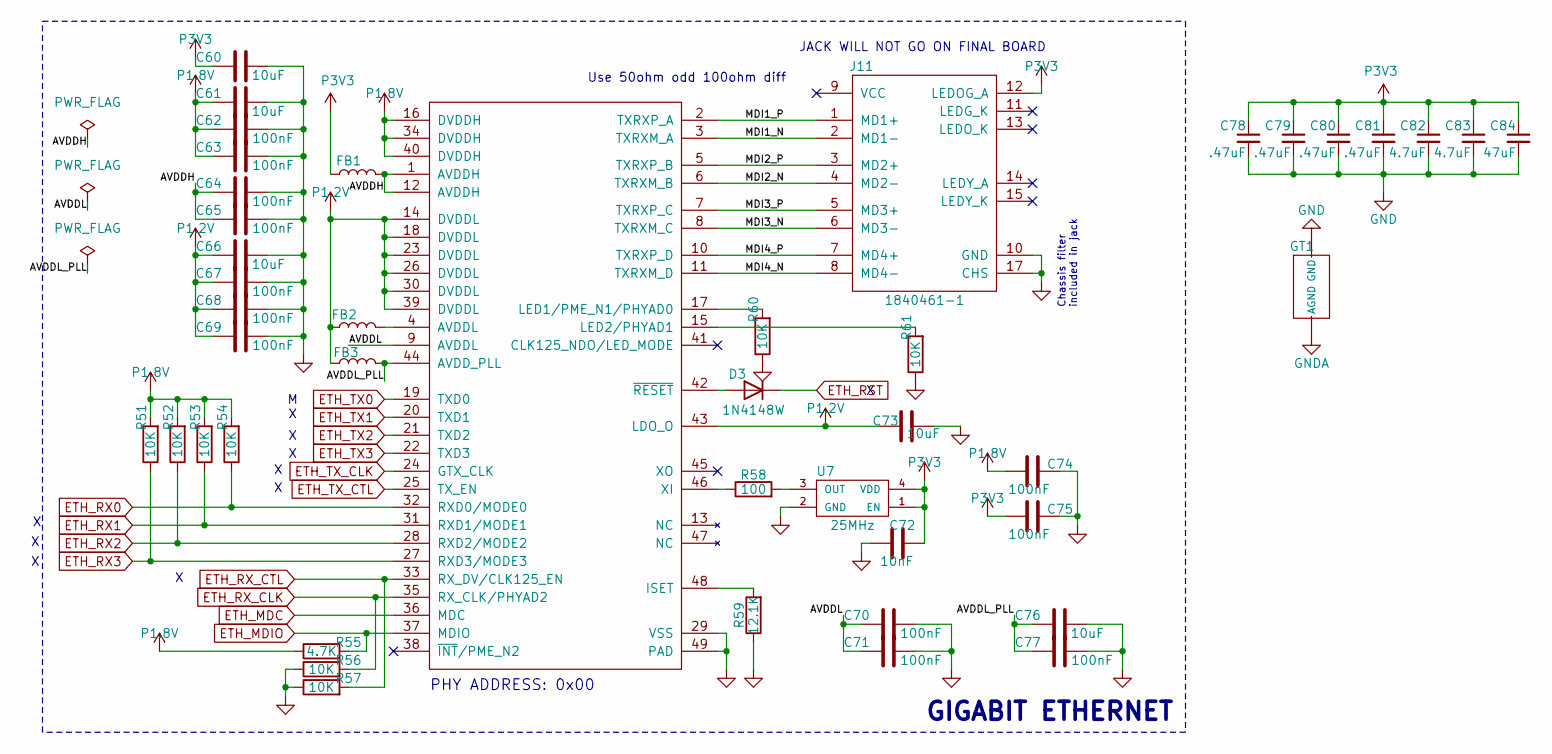
[picture p43: schematic COMMS.kicad_sch]

Parts:
C60, C61, C66, C73, C76: 10uF; C_0402_1005Metric
C62, C63, C64, C65, C67, C68, C69, C70, C71, C74, C75, C77: 100nF; C_0201_0603Metric
C72: 10nF; C_0201_0603Metric
C78, C79, C80, C81: .47uF; C_0402_1005Metric
C82, C83: 4.7uF; C_0402_1005Metric
C84: 47uF; C_0805_2012Metric
D3: 1N4148W; D_DO-35_SOD27_P3.81mm_Vertical_CathodeUp
FB1, FB2, FB3: MPZ1608S601ATA00; R_0603_1608Metric_Pad0.98x0.95mm_HandSolder
GT1: GNDTIE; gndtie
J11: 1840461-1
R51, R52, R53, R54, R56, R57, R60, R61: 10K; R_0402_1005Metric
R55: 4.7K; R_0402_1005Metric
R58: 100; R_0402_1005Metric
R59: 12.1K; R_0402_1005Metric
U6: KSZ9031RNXIA; QFN-48-1EP_7x7mm_P0.5mm_EP5.15x5.15mm
U7: 25MHz; ABRACON-ASDMB

Connections:
AVDDH: C64.1, C65.1, FB1.2, U6.1 (AVDDH), U6.12 (AVDDH)
AVDDL: C70.1, C71.1, U6.9 (AVDDL)
AVDDL_PLL: C76.1, C77.1, FB3.2, U6.44 (AVDD_PLL)
ETH_MDC: U6.36 (MDC)
ETH_MDIO: R55.2, U6.37 (MDIO)
ETH_RST: D3.1 (K)
ETH_RX0: R54.1, U6.32 (RXD0/MODE0)
ETH_RX1: R53.1, U6.31 (RXD1/MODE1)
ETH_RX2: R52.1, U6.28 (RXD2/MODE2)
ETH_RX3: R51.1, U6.27 (RXD3/MODE3)
ETH_RX_CLK: R56.2, U6.35 (RX_CLK/PHYAD2)
ETH_RX_CTL: R57.2, U6.33 (RX_DV/CLK125_EN)
ETH_TX0: U6.19 (TXD0)
ETH_TX1: U6.20 (TXD1)
ETH_TX2: U6.21 (TXD2)
ETH_TX3: U6.22 (TXD3)
ETH_TX_CLK: U6.24 (GTX_CLK)
ETH_TX_CTL: U6.25 (TX_EN)
GND: C60.2, C61.2, C62.2, C63.2, C64.2, C65.2, C66.2, C67.2, C68.2, C69.2, C70.2, C71.2, C72.2, C73.2, C74.2, C75.2, C76.2, C77.2, C78.2, C79.2, C80.2, C81.2, C82.2, C83.2, C84.2, GT1.1 (GND), J11.10 (GND), J11.17 (CHS), R56.1, R57.1, R59.1, R60.1, R61.1, U6.29 (VSS), U6.49 (PAD), U7.2 (GND)
GNDA: GT1.2 (AGND)
MDI1_N: J11.2 (MD1-), U6.3 (TXRXM_A)
MDI1_P: J11.1 (MD1+), U6.2 (TXRXP_A)
MDI2_N: J11.4 (MD2-), U6.6 (TXRXM_B)
MDI2_P: J11.3 (MD2+), U6.5 (TXRXP_B)
MDI3_N: J11.6 (MD3-), U6.8 (TXRXM_C)
MDI3_P: J11.5 (MD3+), U6.7 (TXRXP_C)
MDI4_N: J11.8 (MD4-), U6.11 (TXRXM_D)
MDI4_P: J11.7 (MD4+), U6.10 (TXRXP_D)
unnamed: D3.2 (A), U6.42 (~RESET)
unnamed: FB2.2, U6.4 (AVDDL)
unnamed: R58.1, U6.46 (XI)
unnamed: R58.2, U7.3 (OUT)
unnamed: R59.2, U6.48 (ISET)
unnamed: R60.2, U6.17 (LED1/PME_N1/PHYAD0)
unnamed: R61.2, U6.15 (LED2/PHYAD1)
P1.2V: C66.1, C67.1, C68.1, C69.1, C73.1, FB2.1, FB3.1, U6.14 (DVDDL), U6.18 (DVDDL), U6.23 (DVDDL), U6.26 (DVDDL), U6.30 (DVDDL), U6.39 (DVDDL), U6.43 (LDO_O)
P1.8V: C61.1, C62.1, C63.1, C74.1, R51.2, R52.2, R53.2, R54.2, R55.1, U6.16 (DVDDH), U6.34 (DVDDH), U6.40 (DVDDH)
P3V3: C60.1, C72.1, C75.1, C78.1, C79.1, C80.1, C81.1, C82.1, C83.1, C84.1, FB1.1, J11.12 (LEDOG_A), U7.1 (EN), U7.4 (VDD)

Notes on the sheet:
Use 50ohm odd 100ohm diff
PHY ADDRESS: 0x00
GIGABIT ETHERNET
JACK WILL NOT GO ON FINAL BOARD
Chassis filter included in jack
