CooterPMcGrew/Flight_Computer_REV01/COMM_USB.kicad_sch

## KiCad design COMM_USB.kicad_sch (2026-05-14)

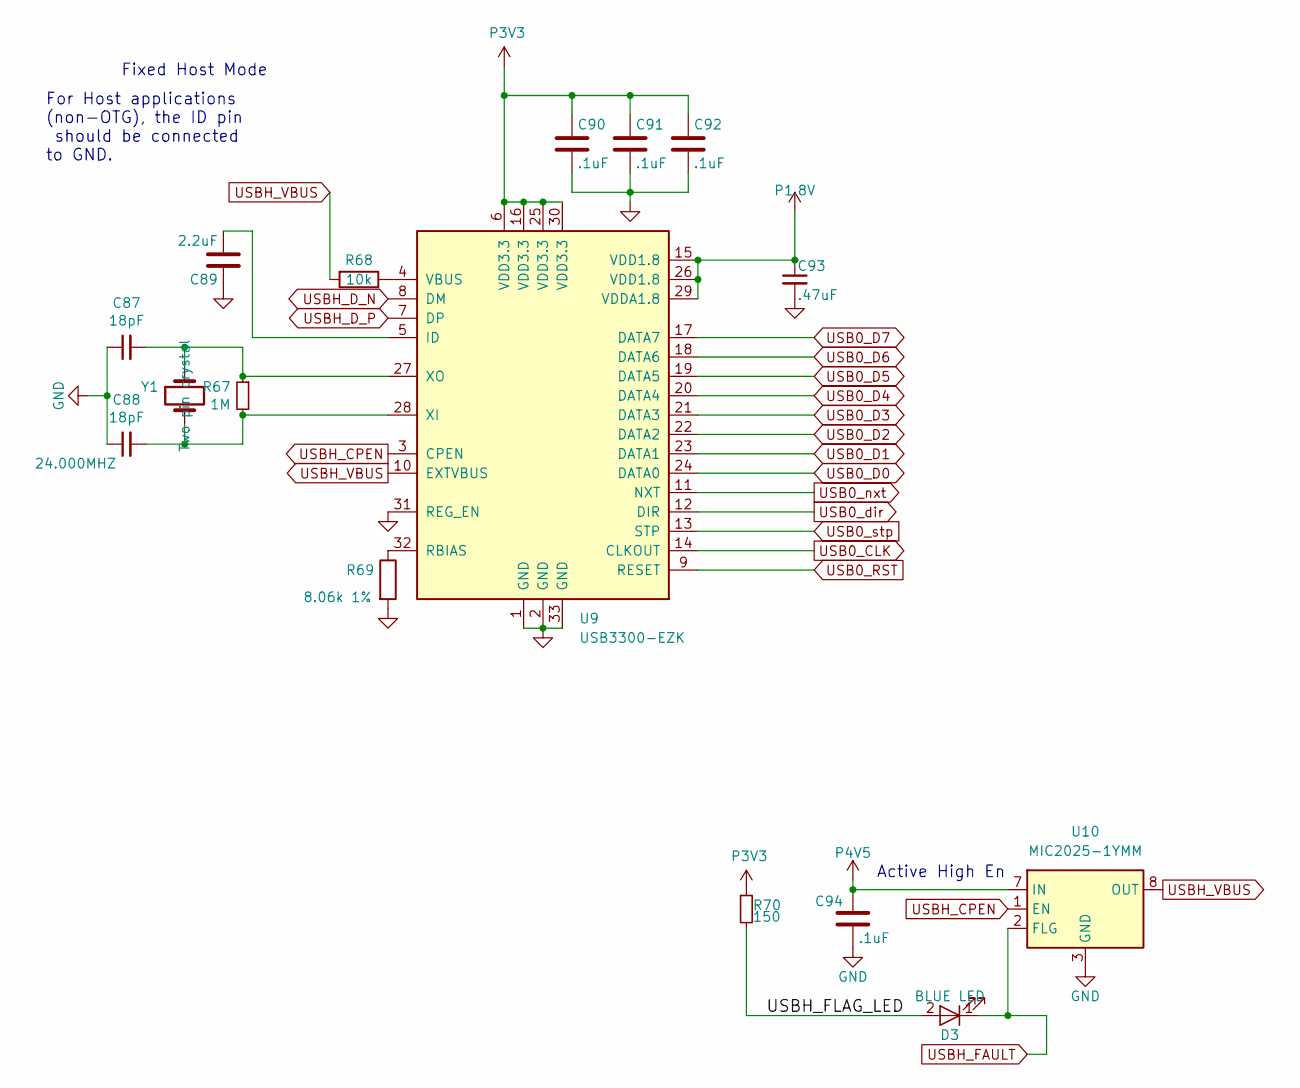
[picture p44: schematic COMM_USB.kicad_sch]

Parts:
C87, C88: 18pF; C_0402_1005Metric
C89: 2.2uF; C_0402_1005Metric
C90, C91, C92, C94: .1uF; C_0402_1005Metric
C93: .47uF; C_0402_1005Metric
D3: BLUE LED; C_0603_1608Metric
R67: 1M; R_0402_1005Metric
R68: 10k; R_0402_1005Metric
R69: 8.06k 1%; R_0402_1005Metric
R70: 150; R_0402_1005Metric
U9: USB3300-EZK; QFN-32-1EP_5x5mm_P0.5mm_EP3.45x3.45mm
U10: MIC2025-1YMM; MSOP-8_3x3mm_P0.65mm
Y1: 24.000MHZ; Crystal_SMD_Qantek_QC5CB-2Pin_5x3.2mm

Connections:
GND: C87.1, C88.1, C89.1, C90.2, C91.2, C92.2, C93.2, C94.2, R69.2, U9.1 (GND), U9.2 (GND), U9.31 (REG_EN), U9.33 (GND), U10.3 (GND)
unnamed: C87.2, R67.1, U9.27 (XO), Y1.1
unnamed: C88.2, R67.2, U9.28 (XI), Y1.2
unnamed: C89.2, U9.5 (ID)
unnamed: R68.1, U9.4 (VBUS)
unnamed: R69.1, U9.32 (RBIAS)
P1.8V: C93.1, U9.15 (VDD1.8), U9.26 (VDD1.8), U9.29 (VDDA1.8)
P3V3: C90.1, C91.1, C92.1, R70.1, U9.6 (VDD3.3), U9.16 (VDD3.3), U9.25 (VDD3.3), U9.30 (VDD3.3)
P4V5: C94.1, U10.7 (IN)
USB0_CLK: U9.14 (CLKOUT)
USB0_D0: U9.24 (DATA0)
USB0_D1: U9.23 (DATA1)
USB0_D2: U9.22 (DATA2)
USB0_D3: U9.21 (DATA3)
USB0_D4: U9.20 (DATA4)
USB0_D5: U9.19 (DATA5)
USB0_D6: U9.18 (DATA6)
USB0_D7: U9.17 (DATA7)
USB0_RST: U9.9 (RESET)
USB0_dir: U9.12 (DIR)
USB0_nxt: U9.11 (NXT)
USB0_stp: U9.13 (STP)
USBH_CPEN: U9.3 (CPEN), U10.1 (EN)
USBH_D_N: U9.8 (DM)
USBH_D_P: U9.7 (DP)
USBH_FAULT: D3.1 (K), U10.2 (FLG)
USBH_FLAG_LED: D3.2 (A), R70.2
USBH_VBUS: R68.2, U9.10 (EXTVBUS), U10.6 (OUT), U10.8 (OUT)

Notes on the sheet:
Fixed Host Mode
Active High En
For Host applications (non-OTG), the ID pin should be connected to GND.
