CooterPMcGrew/Flight_Computer_REV01/DDR.kicad_sch

## KiCad design DDR.kicad_sch (2026-05-14)

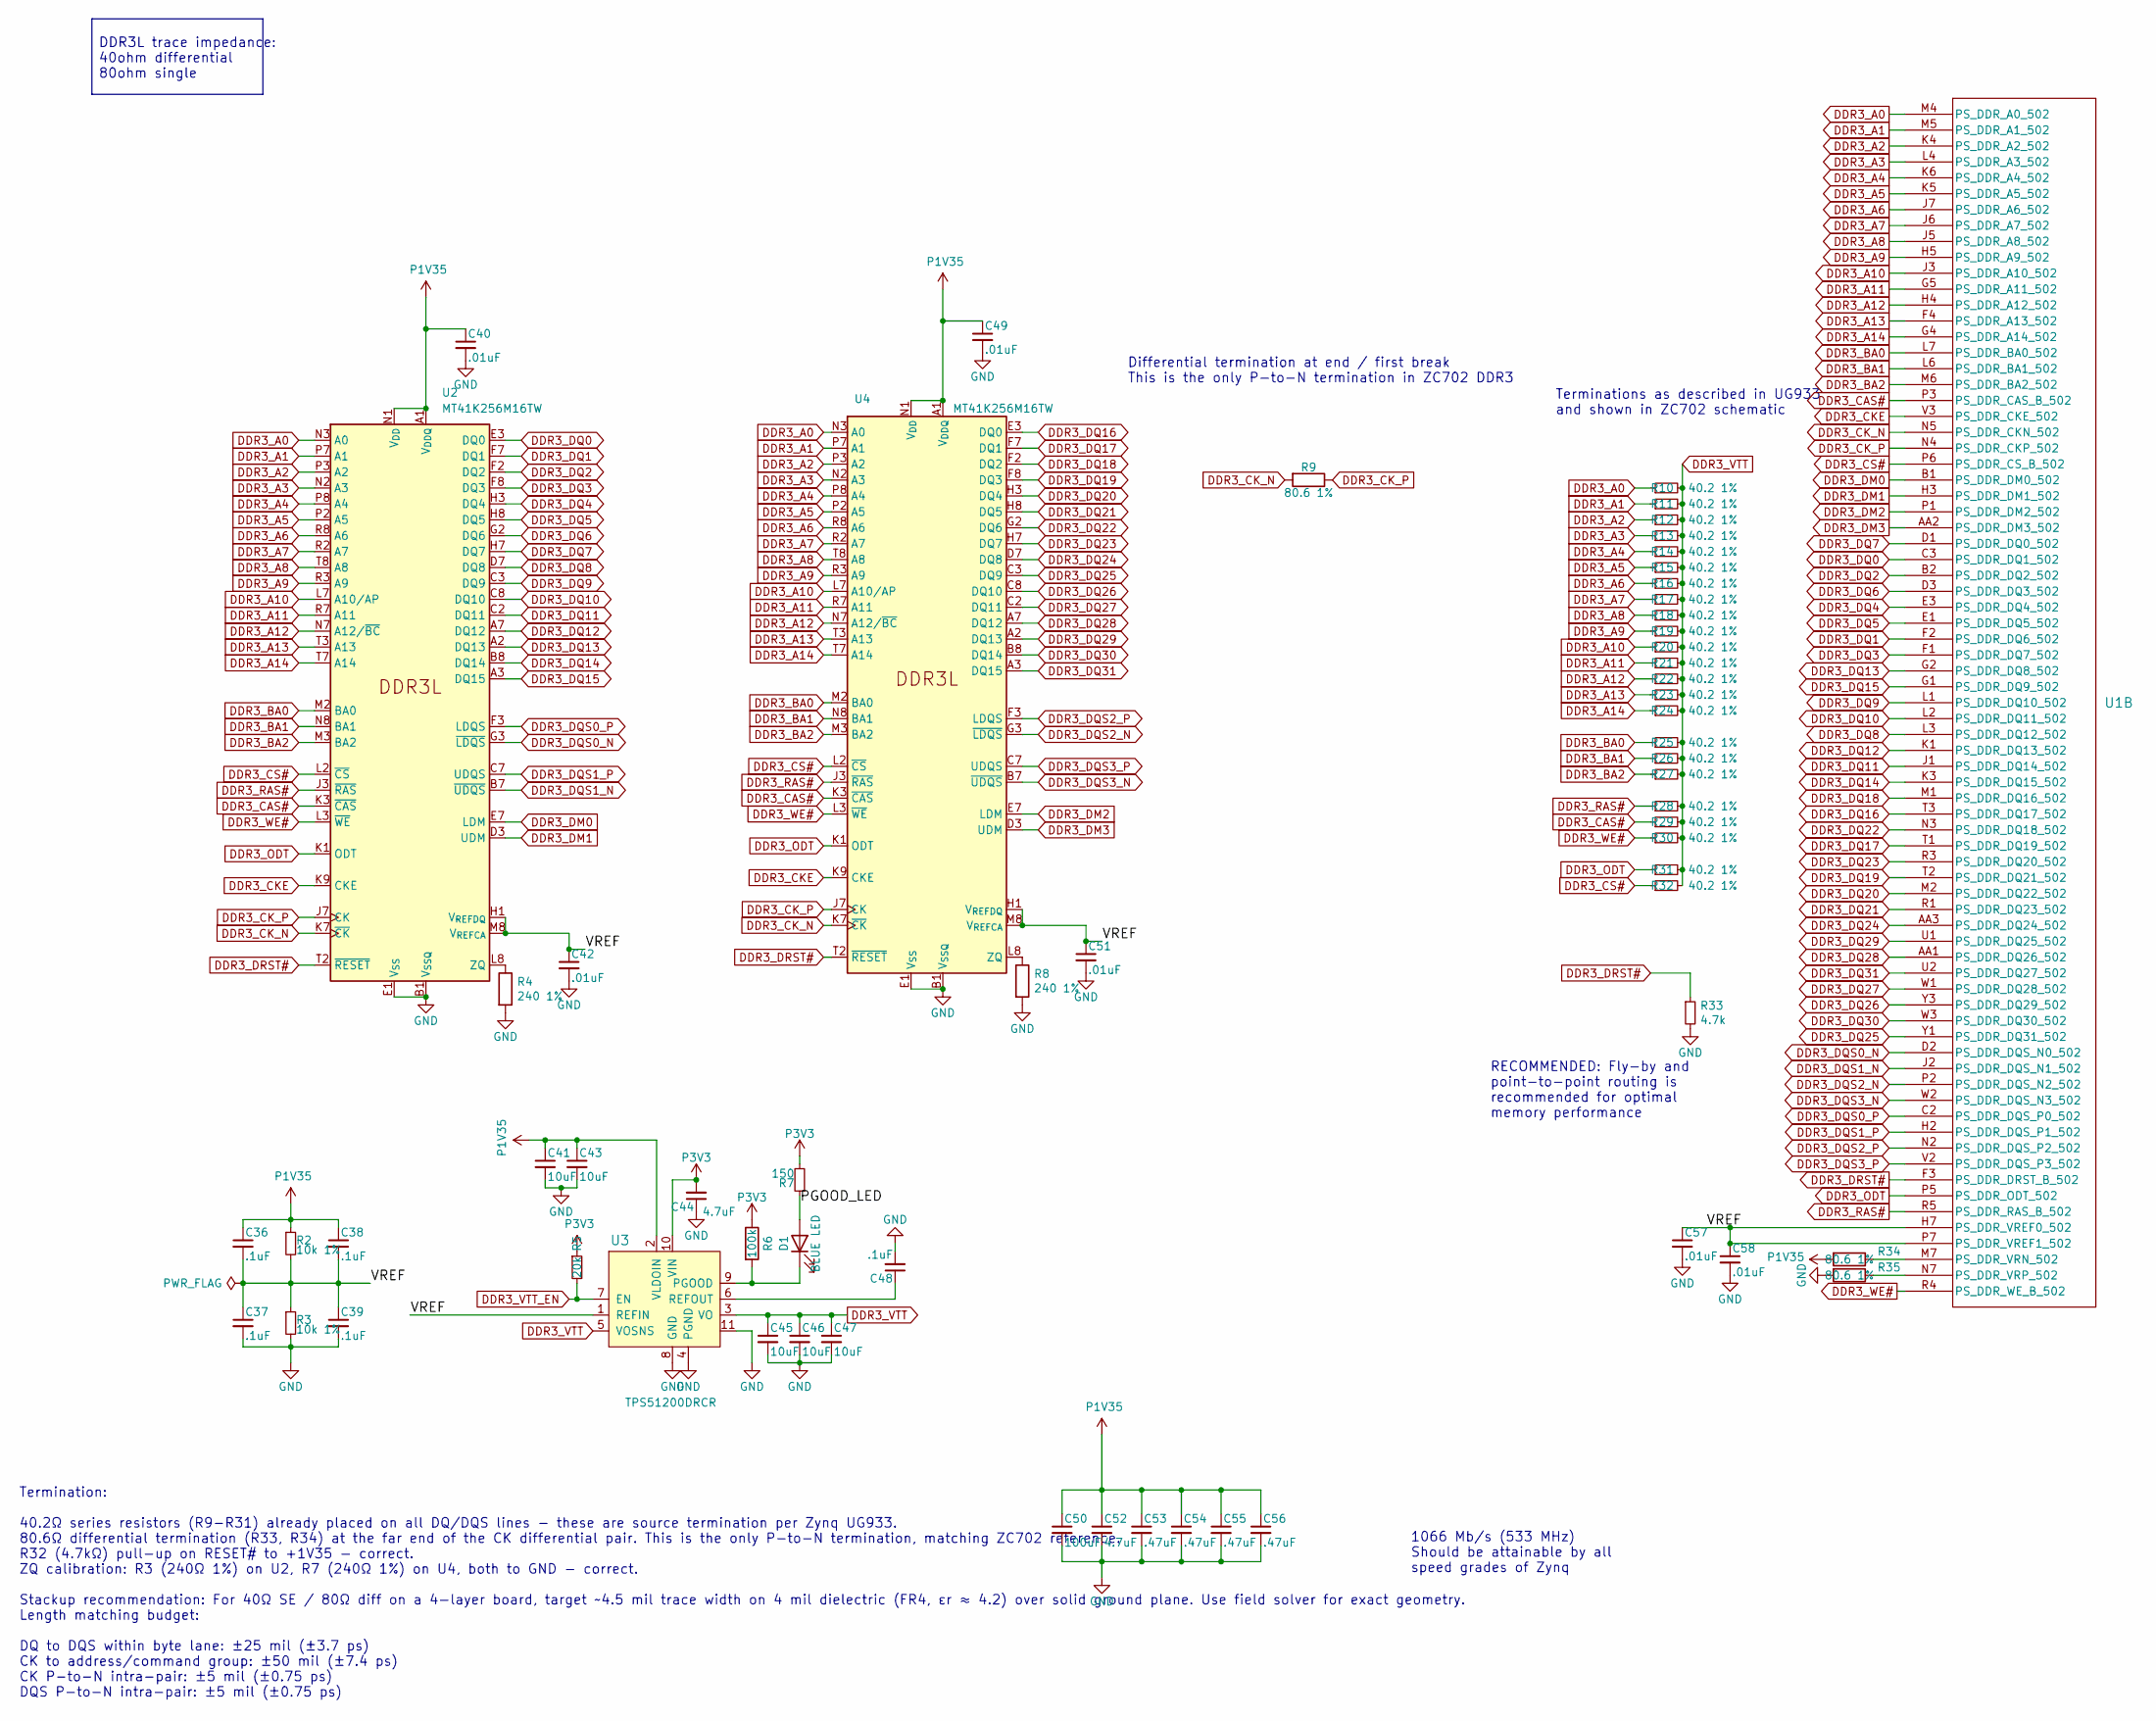
[picture p45: schematic DDR.kicad_sch]

Parts:
C36, C37, C38, C39, C48: .1uF; C_0402_1005Metric
C40, C42, C49, C51, C57, C58: .01uF; C_0402_1005Metric
C41, C43, C45, C46, C47: 10uF; C_0603_1608Metric
C44, C52: 4.7uF; C_0402_1005Metric
C50: 100uF; C_1210_3225Metric
C53, C54, C55, C56: .47uF; C_0402_1005Metric
D1: BLUE LED; C_0603_1608Metric
R2, R3: 10k 1%; R_0402_1005Metric
R4, R8: 240 1%; R_0402_1005Metric
R5: 20k; R_0402_1005Metric
R6: 100k; R_0402_1005Metric
R7: 150; R_0402_1005Metric
R9, R34, R35: 80.6 1%; R_0402_1005Metric
R10, R11, R12, R13, R14, R15, R16, R17, R18, R19, R20, R21, R22, R23, R24, R25, R26, R27, R28, R29, R30, R31, R32: 40.2 1%; R_0201_0603Metric_Pad0.64x0.40mm_HandSolder
R33: 4.7k; R_0402_1005Metric
U1: XC7Z020-2CLG484I; BGA-484_19.0x19.0mm_Layout22x22_P0.80mm_dia0.40mm
U2, U4: MT41K256M16TW; Micron_FBGA-96_8x14mm_Layout9x16_P0.8mm
U3: TPS51200DRCR; VSON-10-1EP_3x3mm_P0.5mm_EP1.65x2.4mm_ThermalVias

Connections:
DDR3_A0: R10.1, U1.M4 (PS_DDR_A0_502), U2.N3 (A0), U4.N3 (A0)
DDR3_A1: R11.1, U1.M5 (PS_DDR_A1_502), U2.P7 (A1), U4.P7 (A1)
DDR3_A2: R12.1, U1.K4 (PS_DDR_A2_502), U2.P3 (A2), U4.P3 (A2)
DDR3_A3: R13.1, U1.L4 (PS_DDR_A3_502), U2.N2 (A3), U4.N2 (A3)
DDR3_A4: R14.1, U1.K6 (PS_DDR_A4_502), U2.P8 (A4), U4.P8 (A4)
DDR3_A5: R15.1, U1.K5 (PS_DDR_A5_502), U2.P2 (A5), U4.P2 (A5)
DDR3_A6: R16.1, U1.J7 (PS_DDR_A6_502), U2.R8 (A6), U4.R8 (A6)
DDR3_A7: R17.1, U1.J6 (PS_DDR_A7_502), U2.R2 (A7), U4.R2 (A7)
DDR3_A8: R18.1, U1.J5 (PS_DDR_A8_502), U2.T8 (A8), U4.T8 (A8)
DDR3_A9: R19.1, U1.H5 (PS_DDR_A9_502), U2.R3 (A9), U4.R3 (A9)
DDR3_A10: R20.1, U1.J3 (PS_DDR_A10_502), U2.L7 (A10/AP), U4.L7 (A10/AP)
DDR3_A11: R21.1, U1.G5 (PS_DDR_A11_502), U2.R7 (A11), U4.R7 (A11)
DDR3_A12: R22.1, U1.H4 (PS_DDR_A12_502), U2.N7 (A12/~BC), U4.N7 (A12/~BC)
DDR3_A13: R23.1, U1.F4 (PS_DDR_A13_502), U2.T3 (A13), U4.T3 (A13)
DDR3_A14: R24.1, U1.G4 (PS_DDR_A14_502), U2.T7 (A14), U4.T7 (A14)
DDR3_BA0: R25.1, U1.L7 (PS_DDR_BA0_502), U2.M2 (BA0), U4.M2 (BA0)
DDR3_BA1: R26.1, U1.L6 (PS_DDR_BA1_502), U2.N8 (BA1), U4.N8 (BA1)
DDR3_BA2: R27.1, U1.M6 (PS_DDR_BA2_502), U2.M3 (BA2), U4.M3 (BA2)
DDR3_CAS#: R29.1, U1.P3 (PS_DDR_CAS_B_502), U2.K3 (~CAS), U4.K3 (~CAS)
DDR3_CKE: U1.V3 (PS_DDR_CKE_502), U2.K9 (CKE), U4.K9 (CKE)
DDR3_CK_N: R9.2, U1.N5 (PS_DDR_CKN_502), U2.K7 (~CK), U4.K7 (~CK)
DDR3_CK_P: R9.1, U1.N4 (PS_DDR_CKP_502), U2.J7 (CK), U4.J7 (CK)
DDR3_CS#: R32.1, U1.P6 (PS_DDR_CS_B_502), U2.L2 (~CS), U4.L2 (~CS)
DDR3_DM0: U1.B1 (PS_DDR_DM0_502), U2.E7 (LDM)
DDR3_DM1: U1.H3 (PS_DDR_DM1_502), U2.D3 (UDM)
DDR3_DM2: U1.P1 (PS_DDR_DM2_502), U4.E7 (LDM)
DDR3_DM3: U1.AA2 (PS_DDR_DM3_502), U4.D3 (UDM)
DDR3_DQ0: U1.C3 (PS_DDR_DQ1_502), U2.E3 (DQ0)
DDR3_DQ1: U1.F2 (PS_DDR_DQ6_502), U2.F7 (DQ1)
DDR3_DQ2: U1.B2 (PS_DDR_DQ2_502), U2.F2 (DQ2)
DDR3_DQ3: U1.F1 (PS_DDR_DQ7_502), U2.F8 (DQ3)
DDR3_DQ4: U1.E3 (PS_DDR_DQ4_502), U2.H3 (DQ4)
DDR3_DQ5: U1.E1 (PS_DDR_DQ5_502), U2.H8 (DQ5)
DDR3_DQ6: U1.D3 (PS_DDR_DQ3_502), U2.G2 (DQ6)
DDR3_DQ7: U1.D1 (PS_DDR_DQ0_502), U2.H7 (DQ7)
DDR3_DQ8: U1.L3 (PS_DDR_DQ12_502), U2.D7 (DQ8)
DDR3_DQ9: U1.L1 (PS_DDR_DQ10_502), U2.C3 (DQ9)
DDR3_DQ10: U1.L2 (PS_DDR_DQ11_502), U2.C8 (DQ10)
DDR3_DQ11: U1.J1 (PS_DDR_DQ14_502), U2.C2 (DQ11)
DDR3_DQ12: U1.K1 (PS_DDR_DQ13_502), U2.A7 (DQ12)
DDR3_DQ13: U1.G2 (PS_DDR_DQ8_502), U2.A2 (DQ13)
DDR3_DQ14: U1.K3 (PS_DDR_DQ15_502), U2.B8 (DQ14)
DDR3_DQ15: U1.G1 (PS_DDR_DQ9_502), U2.A3 (DQ15)
DDR3_DQ16: U1.T3 (PS_DDR_DQ17_502), U4.E3 (DQ0)
DDR3_DQ17: U1.T1 (PS_DDR_DQ19_502), U4.F7 (DQ1)
DDR3_DQ18: U1.M1 (PS_DDR_DQ16_502), U4.F2 (DQ2)
DDR3_DQ19: U1.T2 (PS_DDR_DQ21_502), U4.F8 (DQ3)
DDR3_DQ20: U1.M2 (PS_DDR_DQ22_502), U4.H3 (DQ4)
DDR3_DQ21: U1.R1 (PS_DDR_DQ23_502), U4.H8 (DQ5)
DDR3_DQ22: U1.N3 (PS_DDR_DQ18_502), U4.G2 (DQ6)
DDR3_DQ23: U1.R3 (PS_DDR_DQ20_502), U4.H7 (DQ7)
DDR3_DQ24: U1.AA3 (PS_DDR_DQ24_502), U4.D7 (DQ8)
DDR3_DQ25: U1.Y1 (PS_DDR_DQ31_502), U4.C3 (DQ9)
DDR3_DQ26: U1.Y3 (PS_DDR_DQ29_502), U4.C8 (DQ10)
DDR3_DQ27: U1.W1 (PS_DDR_DQ28_502), U4.C2 (DQ11)
DDR3_DQ28: U1.AA1 (PS_DDR_DQ26_502), U4.A7 (DQ12)
DDR3_DQ29: U1.U1 (PS_DDR_DQ25_502), U4.A2 (DQ13)
DDR3_DQ30: U1.W3 (PS_DDR_DQ30_502), U4.B8 (DQ14)
DDR3_DQ31: U1.U2 (PS_DDR_DQ27_502), U4.A3 (DQ15)
DDR3_DQS0_N: U1.D2 (PS_DDR_DQS_N0_502), U2.G3 (~LDQS)
DDR3_DQS0_P: U1.C2 (PS_DDR_DQS_P0_502), U2.F3 (LDQS)
DDR3_DQS1_N: U1.J2 (PS_DDR_DQS_N1_502), U2.B7 (~UDQS)
DDR3_DQS1_P: U1.H2 (PS_DDR_DQS_P1_502), U2.C7 (UDQS)
DDR3_DQS2_N: U1.P2 (PS_DDR_DQS_N2_502), U4.G3 (~LDQS)
DDR3_DQS2_P: U1.N2 (PS_DDR_DQS_P2_502), U4.F3 (LDQS)
DDR3_DQS3_N: U1.W2 (PS_DDR_DQS_N3_502), U4.B7 (~UDQS)
DDR3_DQS3_P: U1.V2 (PS_DDR_DQS_P3_502), U4.C7 (UDQS)
DDR3_DRST#: R33.1, U1.F3 (PS_DDR_DRST_B_502), U2.T2 (~RESET), U4.T2 (~RESET)
DDR3_ODT: R31.1, U1.P5 (PS_DDR_ODT_502), U2.K1 (ODT), U4.K1 (ODT)
DDR3_RAS#: R28.1, U1.R5 (PS_DDR_RAS_B_502), U2.J3 (~RAS), U4.J3 (~RAS)
DDR3_VTT: C45.1, C46.1, C47.1, R10.2, R11.2, R12.2, R13.2, R14.2, R15.2, R16.2, R17.2, R18.2, R19.2, R20.2, R21.2, R22.2, R23.2, R24.2, R25.2, R26.2, R27.2, R28.2, R29.2, R30.2, R31.2, R32.2, U3.3 (VO), U3.5 (VOSNS)
DDR3_VTT_EN: R5.2, U3.7 (EN)
DDR3_WE#: R30.1, U1.R4 (PS_DDR_WE_B_502), U2.L3 (~WE), U4.L3 (~WE)
GND: C37.2, C39.2, C40.2, C41.2, C42.2, C43.2, C44.1, C45.2, C46.2, C47.2, C48.2, C49.2, C50.2, C51.2, C52.2, C53.2, C54.2, C55.2, C56.2, C57.2, C58.2, R3.2, R4.2, R8.2, R33.2, R35.2, U2.A9 (V_{SS}), U2.B1 (V_{SSQ}), U2.B3 (V_{SS}), U2.B9 (V_{SSQ}), U2.D1 (V_{SSQ}), U2.D8 (V_{SSQ}), U2.E1 (V_{SS}), U2.E2 (V_{SSQ}), U2.E8 (V_{SSQ}), U2.F9 (V_{SSQ}), U2.G1 (V_{SSQ}), U2.G8 (V_{SS}), U2.G9 (V_{SSQ}), U2.J2 (V_{SS}), U2.J8 (V_{SS}), U2.M1 (V_{SS}), U2.M9 (V_{SS}), U2.P1 (V_{SS}), U2.P9 (V_{SS}), U2.T1 (V_{SS}), U2.T9 (V_{SS}), U3.4 (PGND), U3.8 (GND), U3.11, U4.A9 (V_{SS}), U4.B1 (V_{SSQ}), U4.B3 (V_{SS}), U4.B9 (V_{SSQ}), U4.D1 (V_{SSQ}), U4.D8 (V_{SSQ}), U4.E1 (V_{SS}), U4.E2 (V_{SSQ}), U4.E8 (V_{SSQ}), U4.F9 (V_{SSQ}), U4.G1 (V_{SSQ}), U4.G8 (V_{SS}), U4.G9 (V_{SSQ}), U4.J2 (V_{SS}), U4.J8 (V_{SS}), U4.M1 (V_{SS}), U4.M9 (V_{SS}), U4.P1 (V_{SS}), U4.P9 (V_{SS}), U4.T1 (V_{SS}), U4.T9 (V_{SS})
unnamed: C48.1, U3.6 (REFOUT)
unnamed: D1.1 (K), R6.2, U3.9 (PGOOD)
unnamed: R4.1, U2.L8 (ZQ)
unnamed: R8.1, U4.L8 (ZQ)
unnamed: R34.1, U1.M7 (PS_DDR_VRN_502)
unnamed: R35.1, U1.N7 (PS_DDR_VRP_502)
P1V35: C36.1, C38.1, C40.1, C41.1, C43.1, C49.1, C50.1, C52.1, C53.1, C54.1, C55.1, C56.1, R2.1, R34.2, U2.A1 (V_{DDQ}), U2.A8 (V_{DDQ}), U2.B2 (V_{DD}), U2.C1 (V_{DDQ}), U2.C9 (V_{DDQ}), U2.D2 (V_{DDQ}), U2.D9 (V_{DD}), U2.E9 (V_{DDQ}), U2.F1 (V_{DDQ}), U2.G7 (V_{DD}), U2.H2 (V_{DDQ}), U2.H9 (V_{DDQ}), U2.K2 (V_{DD}), U2.K8 (V_{DD}), U2.N1 (V_{DD}), U2.N9 (V_{DD}), U2.R1 (V_{DD}), U2.R9 (V_{DD}), U3.2 (VLDOIN), U4.A1 (V_{DDQ}), U4.A8 (V_{DDQ}), U4.B2 (V_{DD}), U4.C1 (V_{DDQ}), U4.C9 (V_{DDQ}), U4.D2 (V_{DDQ}), U4.D9 (V_{DD}), U4.E9 (V_{DDQ}), U4.F1 (V_{DDQ}), U4.G7 (V_{DD}), U4.H2 (V_{DDQ}), U4.H9 (V_{DDQ}), U4.K2 (V_{DD}), U4.K8 (V_{DD}), U4.N1 (V_{DD}), U4.N9 (V_{DD}), U4.R1 (V_{DD}), U4.R9 (V_{DD})
P3V3: C44.2, R5.1, R6.1, R7.2, U3.10 (VIN)
PGOOD_LED: D1.2 (A), R7.1
VREF: C36.2, C37.1, C38.2, C39.1, C42.1, C51.1, C57.1, C58.1, R2.2, R3.1, U1.H7 (PS_DDR_VREF0_502), U1.P7 (PS_DDR_VREF1_502), U2.H1 (V_{REFDQ}), U2.M8 (V_{REFCA}), U3.1 (REFIN), U4.H1 (V_{REFDQ}), U4.M8 (V_{REFCA})

Notes on the sheet:
1066 Mb/s (533 MHz) Should be attainable by all speed grades of Zynq
DDR3L trace impedance: 40ohm differential 80ohm single
Terminations as described in UG933 and shown in ZC702 schematic
Termination: 40.2Ω series resistors (R9-R31) already placed on all DQ/DQS lines - these are source termination per Zynq UG933. 80.6Ω differential termination (R33, R34) at the far end of the CK differential pair. This is the only P-to-N termination, matching ZC702 reference. R32 (4.7kΩ) pull-up on 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
RECOMMENDED: Fly-by and point-to-point routing is recommended for optimal memory performance
Differential termination at end / first break This is the only P-to-N termination in ZC702 DDR3
