CooterPMcGrew/Flight_Computer_REV01/Flight_Computer_REV01.kicad_sch

## KiCad design Flight_Computer_REV01.kicad_sch (2026-05-14)

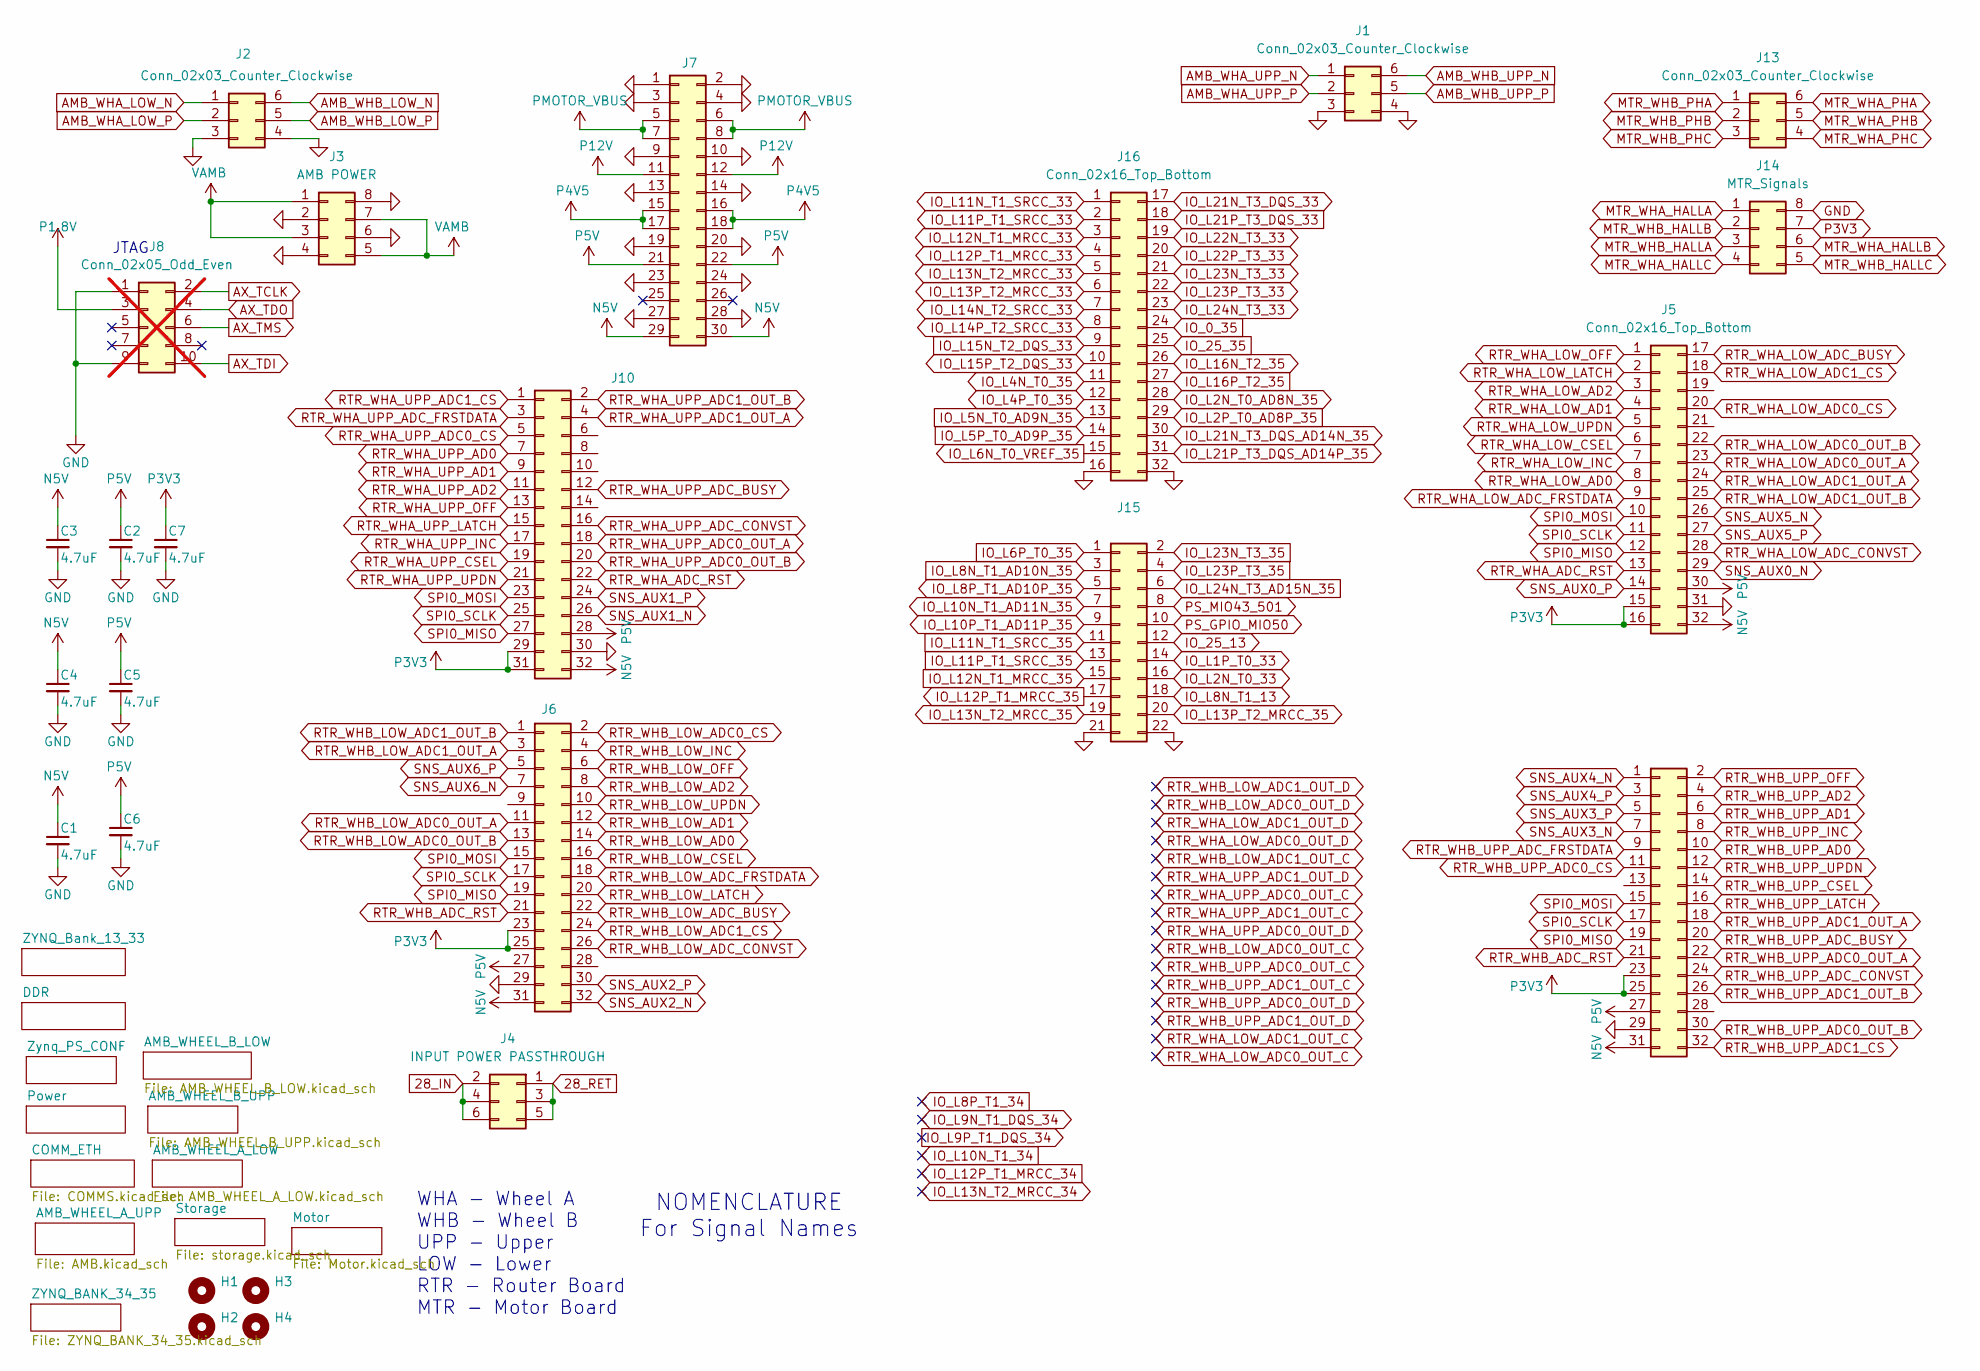
[picture p46: schematic Flight_Computer_REV01.kicad_sch]

Parts:
C1, C2, C3, C4, C5, C6, C7: 4.7uF; C_0402_1005Metric
H1, H2, H3, H4: MountingHole; MountingHole_3.2mm_M3
J1, J2, J13: Conn_02x03_Counter_Clockwise; PinHeader_2x03_P2.54mm_Vertical
J3: AMB POWER; PinHeader_2x04_P2.54mm_Vertical
J4: INPUT POWER PASSTHROUGH; PinHeader_2x03_P2.54mm_Vertical
J5, J6, J9, J10, J16: Conn_02x16_Top_Bottom; PinHeader_2x16_P1.27mm_Vertical
J7: Conn_02x10_Odd_Even; PinSocket_2x15_P2.54mm_Vertical
J8: Conn_02x05_Odd_Even; PinHeader_2x05_P2.54mm_Vertical; not fitted
J14: MTR_Signals; PinHeader_2x04_P1.27mm_Vertical
J15: Conn_02x30_Odd_Even; PinHeader_2x11_P1.27mm_Vertical

Connections:
28_IN: J4.2, J4.4, J4.6
28_RET: J4.1, J4.3, J4.5
AMB_WHA_LOW_N: J2.1
AMB_WHA_LOW_P: J2.2
AMB_WHA_UPP_N: J1.1
AMB_WHA_UPP_P: J1.2
AMB_WHB_LOW_N: J2.6
AMB_WHB_LOW_P: J2.5
AMB_WHB_UPP_N: J1.6
AMB_WHB_UPP_P: J1.5
AX_TCLK: J8.2
AX_TDI: J8.10
AX_TDO: J8.4
AX_TMS: J8.6
GND: C1.2, C2.2, C3.2, C4.2, C5.2, C6.2, C7.2, J1.3, J1.4, J2.3, J2.4, J3.2, J3.4, J3.6, J3.8, J5.31, J6.29, J7.1, J7.2, J7.3, J7.4, J7.9, J7.10, J7.13, J7.14, J7.19, J7.20, J7.23, J7.24, J7.27, J7.28, J8.1, J8.9, J9.29, J10.30, J14.8, J15.21, J15.22, J16.16, J16.32
IO_0_35: J16.24
IO_25_13: J15.12
IO_25_35: J16.25
IO_L1P_T0_33: J15.14
IO_L2N_T0_33: J15.16
IO_L2N_T0_AD8N_35: J16.28
IO_L2P_T0_AD8P_35: J16.29
IO_L4N_T0_35: J16.11
IO_L4P_T0_35: J16.12
IO_L5N_T0_AD9N_35: J16.13
IO_L5P_T0_AD9P_35: J16.14
IO_L6N_T0_VREF_35: J16.15
IO_L6P_T0_35: J15.1
IO_L8N_T1_13: J15.18
IO_L8N_T1_AD10N_35: J15.3
IO_L8P_T1_AD10P_35: J15.5
IO_L10N_T1_AD11N_35: J15.7
IO_L10P_T1_AD11P_35: J15.9
IO_L11N_T1_SRCC_33: J16.1
IO_L11N_T1_SRCC_35: J15.11
IO_L11P_T1_SRCC_33: J16.2
IO_L11P_T1_SRCC_35: J15.13
IO_L12N_T1_MRCC_33: J16.3
IO_L12N_T1_MRCC_35: J15.15
IO_L12P_T1_MRCC_33: J16.4
IO_L12P_T1_MRCC_35: J15.17
IO_L13N_T2_MRCC_33: J16.5
IO_L13N_T2_MRCC_35: J15.19
IO_L13P_T2_MRCC_33: J16.6
IO_L13P_T2_MRCC_35: J15.20
IO_L14N_T2_SRCC_33: J16.7
IO_L14P_T2_SRCC_33: J16.8
IO_L15N_T2_DQS_33: J16.9
IO_L15P_T2_DQS_33: J16.10
IO_L16N_T2_35: J16.26
IO_L16P_T2_35: J16.27
IO_L21N_T3_DQS_33: J16.17
IO_L21N_T3_DQS_AD14N_35: J16.30
IO_L21P_T3_DQS_33: J16.18
IO_L21P_T3_DQS_AD14P_35: J16.31
IO_L22N_T3_33: J16.19
IO_L22P_T3_33: J16.20
IO_L23N_T3_33: J16.21
IO_L23N_T3_35: J15.2
IO_L23P_T3_33: J16.22
IO_L23P_T3_35: J15.4
IO_L24N_T3_33: J16.23
IO_L24N_T3_AD15N_35: J15.6
MTR_WHA_HALLA: J14.1
MTR_WHA_HALLB: J14.6
MTR_WHA_HALLC: J14.4
MTR_WHA_PHA: J13.6
MTR_WHA_PHB: J13.5
MTR_WHA_PHC: J13.4
MTR_WHB_HALLA: J14.3
MTR_WHB_HALLB: J14.2
MTR_WHB_HALLC: J14.5
MTR_WHB_PHA: J13.1
MTR_WHB_PHB: J13.2
MTR_WHB_PHC: J13.3
N5V: C1.1, C3.1, C4.1, J5.32, J6.31, J7.29, J7.30, J9.31, J10.32
P1.8V: J8.3
P3V3: C7.1, J5.15, J5.16, J6.23, J6.25, J9.23, J9.25, J10.29, J10.31, J14.7
P4V5: J7.15, J7.16, J7.17, J7.18
P5V: C2.1, C5.1, C6.1, J5.30, J6.27, J7.21, J7.22, J9.27, J10.28
P12V: J7.11, J7.12
PMOTOR_VBUS: J7.5, J7.6, J7.7, J7.8
PS_GPIO_MIO50: J15.10
PS_MIO43_501: J15.8
RTR_WHA_ADC_RST: J5.13, J10.22
RTR_WHA_LOW_AD0: J5.8
RTR_WHA_LOW_AD1: J5.4
RTR_WHA_LOW_AD2: J5.3
RTR_WHA_LOW_ADC0_CS: J5.20
RTR_WHA_LOW_ADC0_OUT_A: J5.23
RTR_WHA_LOW_ADC0_OUT_B: J5.22
RTR_WHA_LOW_ADC1_CS: J5.18
RTR_WHA_LOW_ADC1_OUT_A: J5.24
RTR_WHA_LOW_ADC1_OUT_B: J5.25
RTR_WHA_LOW_ADC_BUSY: J5.17
RTR_WHA_LOW_ADC_CONVST: J5.28
RTR_WHA_LOW_ADC_FRSTDATA: J5.9
RTR_WHA_LOW_CSEL: J5.6
RTR_WHA_LOW_INC: J5.7
RTR_WHA_LOW_LATCH: J5.2
RTR_WHA_LOW_OFF: J5.1
RTR_WHA_LOW_UPDN: J5.5
RTR_WHA_UPP_AD0: J10.7
RTR_WHA_UPP_AD1: J10.9
RTR_WHA_UPP_AD2: J10.11
RTR_WHA_UPP_ADC0_CS: J10.5
RTR_WHA_UPP_ADC0_OUT_A: J10.18
RTR_WHA_UPP_ADC0_OUT_B: J10.20
RTR_WHA_UPP_ADC1_CS: J10.1
RTR_WHA_UPP_ADC1_OUT_A: J10.4
RTR_WHA_UPP_ADC1_OUT_B: J10.2
RTR_WHA_UPP_ADC_BUSY: J10.12
RTR_WHA_UPP_ADC_CONVST: J10.16
RTR_WHA_UPP_ADC_FRSTDATA: J10.3
RTR_WHA_UPP_CSEL: J10.19
RTR_WHA_UPP_INC: J10.17
RTR_WHA_UPP_LATCH: J10.15
RTR_WHA_UPP_OFF: J10.13
RTR_WHA_UPP_UPDN: J10.21
RTR_WHB_ADC_RST: J6.21, J9.21
RTR_WHB_LOW_AD0: J6.14
RTR_WHB_LOW_AD1: J6.12
RTR_WHB_LOW_AD2: J6.8
RTR_WHB_LOW_ADC0_CS: J6.2
RTR_WHB_LOW_ADC0_OUT_A: J6.11
RTR_WHB_LOW_ADC0_OUT_B: J6.13
RTR_WHB_LOW_ADC1_CS: J6.24
RTR_WHB_LOW_ADC1_OUT_A: J6.3
RTR_WHB_LOW_ADC1_OUT_B: J6.1
RTR_WHB_LOW_ADC_BUSY: J6.22
RTR_WHB_LOW_ADC_CONVST: J6.26
RTR_WHB_LOW_ADC_FRSTDATA: J6.18
RTR_WHB_LOW_CSEL: J6.16
RTR_WHB_LOW_INC: J6.4
RTR_WHB_LOW_LATCH: J6.20
RTR_WHB_LOW_OFF: J6.6
RTR_WHB_LOW_UPDN: J6.10
RTR_WHB_UPP_AD0: J9.10
RTR_WHB_UPP_AD1: J9.6
RTR_WHB_UPP_AD2: J9.4
RTR_WHB_UPP_ADC0_CS: J9.11
RTR_WHB_UPP_ADC0_OUT_A: J9.22
RTR_WHB_UPP_ADC0_OUT_B: J9.30
RTR_WHB_UPP_ADC1_CS: J9.32
RTR_WHB_UPP_ADC1_OUT_A: J9.18
RTR_WHB_UPP_ADC1_OUT_B: J9.26
RTR_WHB_UPP_ADC_BUSY: J9.20
RTR_WHB_UPP_ADC_CONVST: J9.24
RTR_WHB_UPP_ADC_FRSTDATA: J9.9
RTR_WHB_UPP_CSEL: J9.14
RTR_WHB_UPP_INC: J9.8
RTR_WHB_UPP_LATCH: J9.16
RTR_WHB_UPP_OFF: J9.2
RTR_WHB_UPP_UPDN: J9.12
SNS_AUX0_N: J5.29
SNS_AUX0_P: J5.14
SNS_AUX1_N: J10.26
SNS_AUX1_P: J10.24
SNS_AUX2_N: J6.32
SNS_AUX2_P: J6.30
SNS_AUX3_N: J9.7
SNS_AUX3_P: J9.5
SNS_AUX4_N: J9.1
SNS_AUX4_P: J9.3
SNS_AUX5_N: J5.26
SNS_AUX5_P: J5.27
SNS_AUX6_N: J6.7
SNS_AUX6_P: J6.5
SPI0_MISO: J5.12, J6.19, J9.19, J10.27
SPI0_MOSI: J5.10, J6.15, J9.15, J10.23
SPI0_SCLK: J5.11, J6.17, J9.17, J10.25
VAMB: J3.1, J3.3, J3.5, J3.7

Notes on the sheet:
NOMENCLATURE For Signal Names
WHA - Wheel A WHB - Wheel B UPP - Upper LOW - Lower RTR - Router Board MTR - Motor Board
JTAG
