CooterPMcGrew/Flight_Computer_REV01/ISS_MCU_REV05.kicad_sch

## KiCad design ISS_MCU_REV05.kicad_sch (2026-05-14)

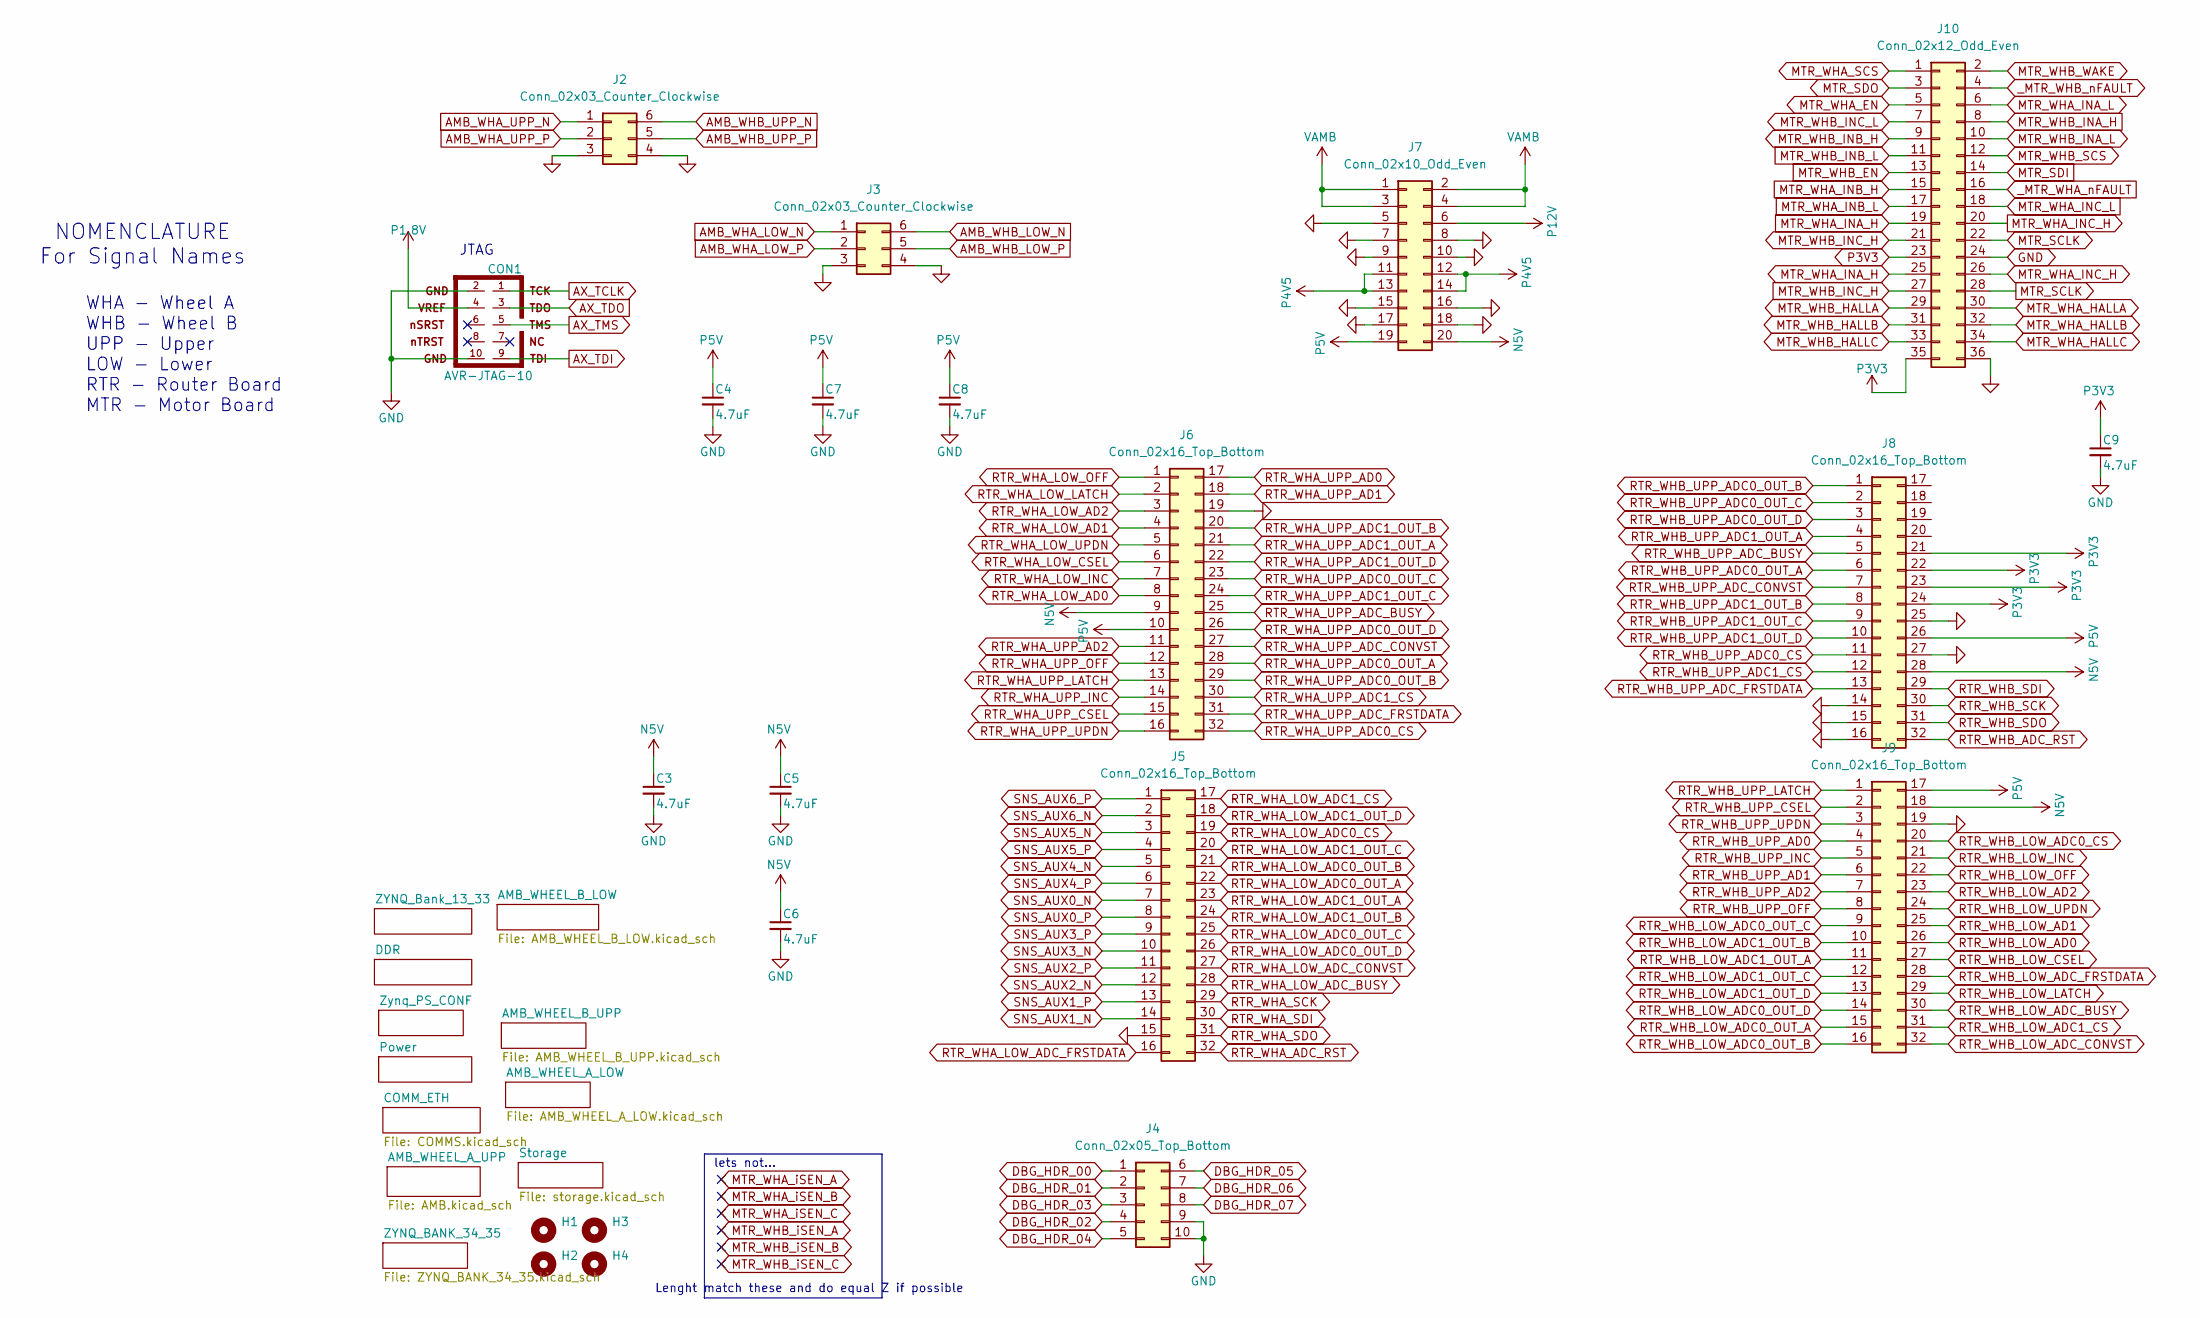
[picture p47: schematic ISS_MCU_REV05.kicad_sch]

Parts:
C3, C4, C5, C6, C7, C8, C9: 4.7uF; C_0402_1005Metric
CON1: AVR-JTAG-10; IDC-Header_2x05_P2.54mm_Vertical
H1, H2, H3, H4: MountingHole; MountingHole_3.2mm_M3
J2, J3: Conn_02x03_Counter_Clockwise; PinHeader_2x03_P2.54mm_Vertical
J4: Conn_02x05_Top_Bottom; PinHeader_2x05_P2.54mm_Vertical
J5, J6, J8, J9: Conn_02x16_Top_Bottom; PinHeader_2x16_P1.27mm_Vertical
J7: Conn_02x10_Odd_Even; PinSocket_2x10_P2.54mm_Vertical
J10: Conn_02x12_Odd_Even; PinHeader_2x12_P2.54mm_Vertical

Connections:
AMB_WHA_LOW_N: J3.1
AMB_WHA_LOW_P: J3.2
AMB_WHA_UPP_N: J2.1
AMB_WHA_UPP_P: J2.2
AMB_WHB_LOW_N: J3.6
AMB_WHB_LOW_P: J3.5
AMB_WHB_UPP_N: J2.6
AMB_WHB_UPP_P: J2.5
AX_TCLK: CON1.1
AX_TDI: CON1.9
AX_TDO: CON1.3
AX_TMS: CON1.5
DBG_HDR_00: J4.1
DBG_HDR_01: J4.2
DBG_HDR_02: J4.4
DBG_HDR_03: J4.3
DBG_HDR_04: J4.5
DBG_HDR_05: J4.6
DBG_HDR_06: J4.7
DBG_HDR_07: J4.8
GND: C3.2, C4.2, C5.2, C6.2, C7.2, C8.2, C9.2, CON1.2, CON1.10, J2.3, J2.4, J3.3, J3.4, J4.9, J4.10, J5.15, J6.19, J7.5, J7.7, J7.8, J7.9, J7.10, J7.15, J7.16, J7.17, J7.18, J8.14, J8.15, J8.16, J8.25, J8.27, J9.19, J10.24, J10.36
MTR_SCLK: J10.22, J10.28
MTR_SDI: J10.14
MTR_SDO: J10.3
MTR_WHA_EN: J10.5
MTR_WHA_HALLA: J10.30
MTR_WHA_HALLB: J10.32
MTR_WHA_HALLC: J10.34
MTR_WHA_INA_H: J10.19, J10.25
MTR_WHA_INA_L: J10.6
MTR_WHA_INB_H: J10.15
MTR_WHA_INB_L: J10.17
MTR_WHA_INC_H: J10.20, J10.26
MTR_WHA_INC_L: J10.18
MTR_WHA_SCS: J10.1
MTR_WHB_EN: J10.13
MTR_WHB_HALLA: J10.29
MTR_WHB_HALLB: J10.31
MTR_WHB_HALLC: J10.33
MTR_WHB_INA_H: J10.8
MTR_WHB_INA_L: J10.10
MTR_WHB_INB_H: J10.9
MTR_WHB_INB_L: J10.11
MTR_WHB_INC_H: J10.21, J10.27
MTR_WHB_INC_L: J10.7
MTR_WHB_SCS: J10.12
MTR_WHB_WAKE: J10.2
N5V: C3.1, C5.1, C6.1, J6.9, J7.20, J8.28, J9.18
P1.8V: CON1.4
P3V3: C9.1, J8.21, J8.22, J8.23, J8.24, J10.23, J10.35
P4V5: J7.11, J7.12, J7.13, J7.14
P5V: C4.1, C7.1, C8.1, J6.10, J7.19, J8.26, J9.17
P12V: J7.6
RTR_WHA_ADC_RST: J5.32
RTR_WHA_LOW_AD0: J6.8
RTR_WHA_LOW_AD1: J6.4
RTR_WHA_LOW_AD2: J6.3
RTR_WHA_LOW_ADC0_CS: J5.19
RTR_WHA_LOW_ADC0_OUT_A: J5.22
RTR_WHA_LOW_ADC0_OUT_B: J5.21
RTR_WHA_LOW_ADC0_OUT_C: J5.25
RTR_WHA_LOW_ADC0_OUT_D: J5.26
RTR_WHA_LOW_ADC1_CS: J5.17
RTR_WHA_LOW_ADC1_OUT_A: J5.23
RTR_WHA_LOW_ADC1_OUT_B: J5.24
RTR_WHA_LOW_ADC1_OUT_C: J5.20
RTR_WHA_LOW_ADC1_OUT_D: J5.18
RTR_WHA_LOW_ADC_BUSY: J5.28
RTR_WHA_LOW_ADC_CONVST: J5.27
RTR_WHA_LOW_ADC_FRSTDATA: J5.16
RTR_WHA_LOW_CSEL: J6.6
RTR_WHA_LOW_INC: J6.7
RTR_WHA_LOW_LATCH: J6.2
RTR_WHA_LOW_OFF: J6.1
RTR_WHA_LOW_UPDN: J6.5
RTR_WHA_SCK: J5.29
RTR_WHA_SDI: J5.30
RTR_WHA_SDO: J5.31
RTR_WHA_UPP_AD0: J6.17
RTR_WHA_UPP_AD1: J6.18
RTR_WHA_UPP_AD2: J6.11
RTR_WHA_UPP_ADC0_CS: J6.32
RTR_WHA_UPP_ADC0_OUT_A: J6.28
RTR_WHA_UPP_ADC0_OUT_B: J6.29
RTR_WHA_UPP_ADC0_OUT_C: J6.23
RTR_WHA_UPP_ADC0_OUT_D: J6.26
RTR_WHA_UPP_ADC1_CS: J6.30
RTR_WHA_UPP_ADC1_OUT_A: J6.21
RTR_WHA_UPP_ADC1_OUT_B: J6.20
RTR_WHA_UPP_ADC1_OUT_C: J6.24
RTR_WHA_UPP_ADC1_OUT_D: J6.22
RTR_WHA_UPP_ADC_BUSY: J6.25
RTR_WHA_UPP_ADC_CONVST: J6.27
RTR_WHA_UPP_ADC_FRSTDATA: J6.31
RTR_WHA_UPP_CSEL: J6.15
RTR_WHA_UPP_INC: J6.14
RTR_WHA_UPP_LATCH: J6.13
RTR_WHA_UPP_OFF: J6.12
RTR_WHA_UPP_UPDN: J6.16
RTR_WHB_ADC_RST: J8.32
RTR_WHB_LOW_AD0: J9.26
RTR_WHB_LOW_AD1: J9.25
RTR_WHB_LOW_AD2: J9.23
RTR_WHB_LOW_ADC0_CS: J9.20
RTR_WHB_LOW_ADC0_OUT_A: J9.15
RTR_WHB_LOW_ADC0_OUT_B: J9.16
RTR_WHB_LOW_ADC0_OUT_C: J9.9
RTR_WHB_LOW_ADC0_OUT_D: J9.14
RTR_WHB_LOW_ADC1_CS: J9.31
RTR_WHB_LOW_ADC1_OUT_A: J9.11
RTR_WHB_LOW_ADC1_OUT_B: J9.10
RTR_WHB_LOW_ADC1_OUT_C: J9.12
RTR_WHB_LOW_ADC1_OUT_D: J9.13
RTR_WHB_LOW_ADC_BUSY: J9.30
RTR_WHB_LOW_ADC_CONVST: J9.32
RTR_WHB_LOW_ADC_FRSTDATA: J9.28
RTR_WHB_LOW_CSEL: J9.27
RTR_WHB_LOW_INC: J9.21
RTR_WHB_LOW_LATCH: J9.29
RTR_WHB_LOW_OFF: J9.22
RTR_WHB_LOW_UPDN: J9.24
RTR_WHB_SCK: J8.30
RTR_WHB_SDI: J8.29
RTR_WHB_SDO: J8.31
RTR_WHB_UPP_AD0: J9.4
RTR_WHB_UPP_AD1: J9.6
RTR_WHB_UPP_AD2: J9.7
RTR_WHB_UPP_ADC0_CS: J8.11
RTR_WHB_UPP_ADC0_OUT_A: J8.6
RTR_WHB_UPP_ADC0_OUT_B: J8.1
RTR_WHB_UPP_ADC0_OUT_C: J8.2
RTR_WHB_UPP_ADC0_OUT_D: J8.3
RTR_WHB_UPP_ADC1_CS: J8.12
RTR_WHB_UPP_ADC1_OUT_A: J8.4
RTR_WHB_UPP_ADC1_OUT_B: J8.8
RTR_WHB_UPP_ADC1_OUT_C: J8.9
RTR_WHB_UPP_ADC1_OUT_D: J8.10
RTR_WHB_UPP_ADC_BUSY: J8.5
RTR_WHB_UPP_ADC_CONVST: J8.7
RTR_WHB_UPP_ADC_FRSTDATA: J8.13
RTR_WHB_UPP_CSEL: J9.2
RTR_WHB_UPP_INC: J9.5
RTR_WHB_UPP_LATCH: J9.1
RTR_WHB_UPP_OFF: J9.8
RTR_WHB_UPP_UPDN: J9.3
SNS_AUX0_N: J5.7
SNS_AUX0_P: J5.8
SNS_AUX1_N: J5.14
SNS_AUX1_P: J5.13
SNS_AUX2_N: J5.12
SNS_AUX2_P: J5.11
SNS_AUX3_N: J5.10
SNS_AUX3_P: J5.9
SNS_AUX4_N: J5.5
SNS_AUX4_P: J5.6
SNS_AUX5_N: J5.3
SNS_AUX5_P: J5.4
SNS_AUX6_N: J5.2
SNS_AUX6_P: J5.1
VAMB: J7.1, J7.2, J7.3, J7.4
_MTR_WHA_nFAULT: J10.16
_MTR_WHB_nFAULT: J10.4

Notes on the sheet:
NOMENCLATURE For Signal Names
lets not...
WHA - Wheel A WHB - Wheel B UPP - Upper LOW - Lower RTR - Router Board MTR - Motor Board
JTAG
Lenght match these and do equal Z if possible
