CooterPMcGrew/Flight_Computer_REV01/Motor.kicad_sch

## KiCad design Motor.kicad_sch (2026-05-14)

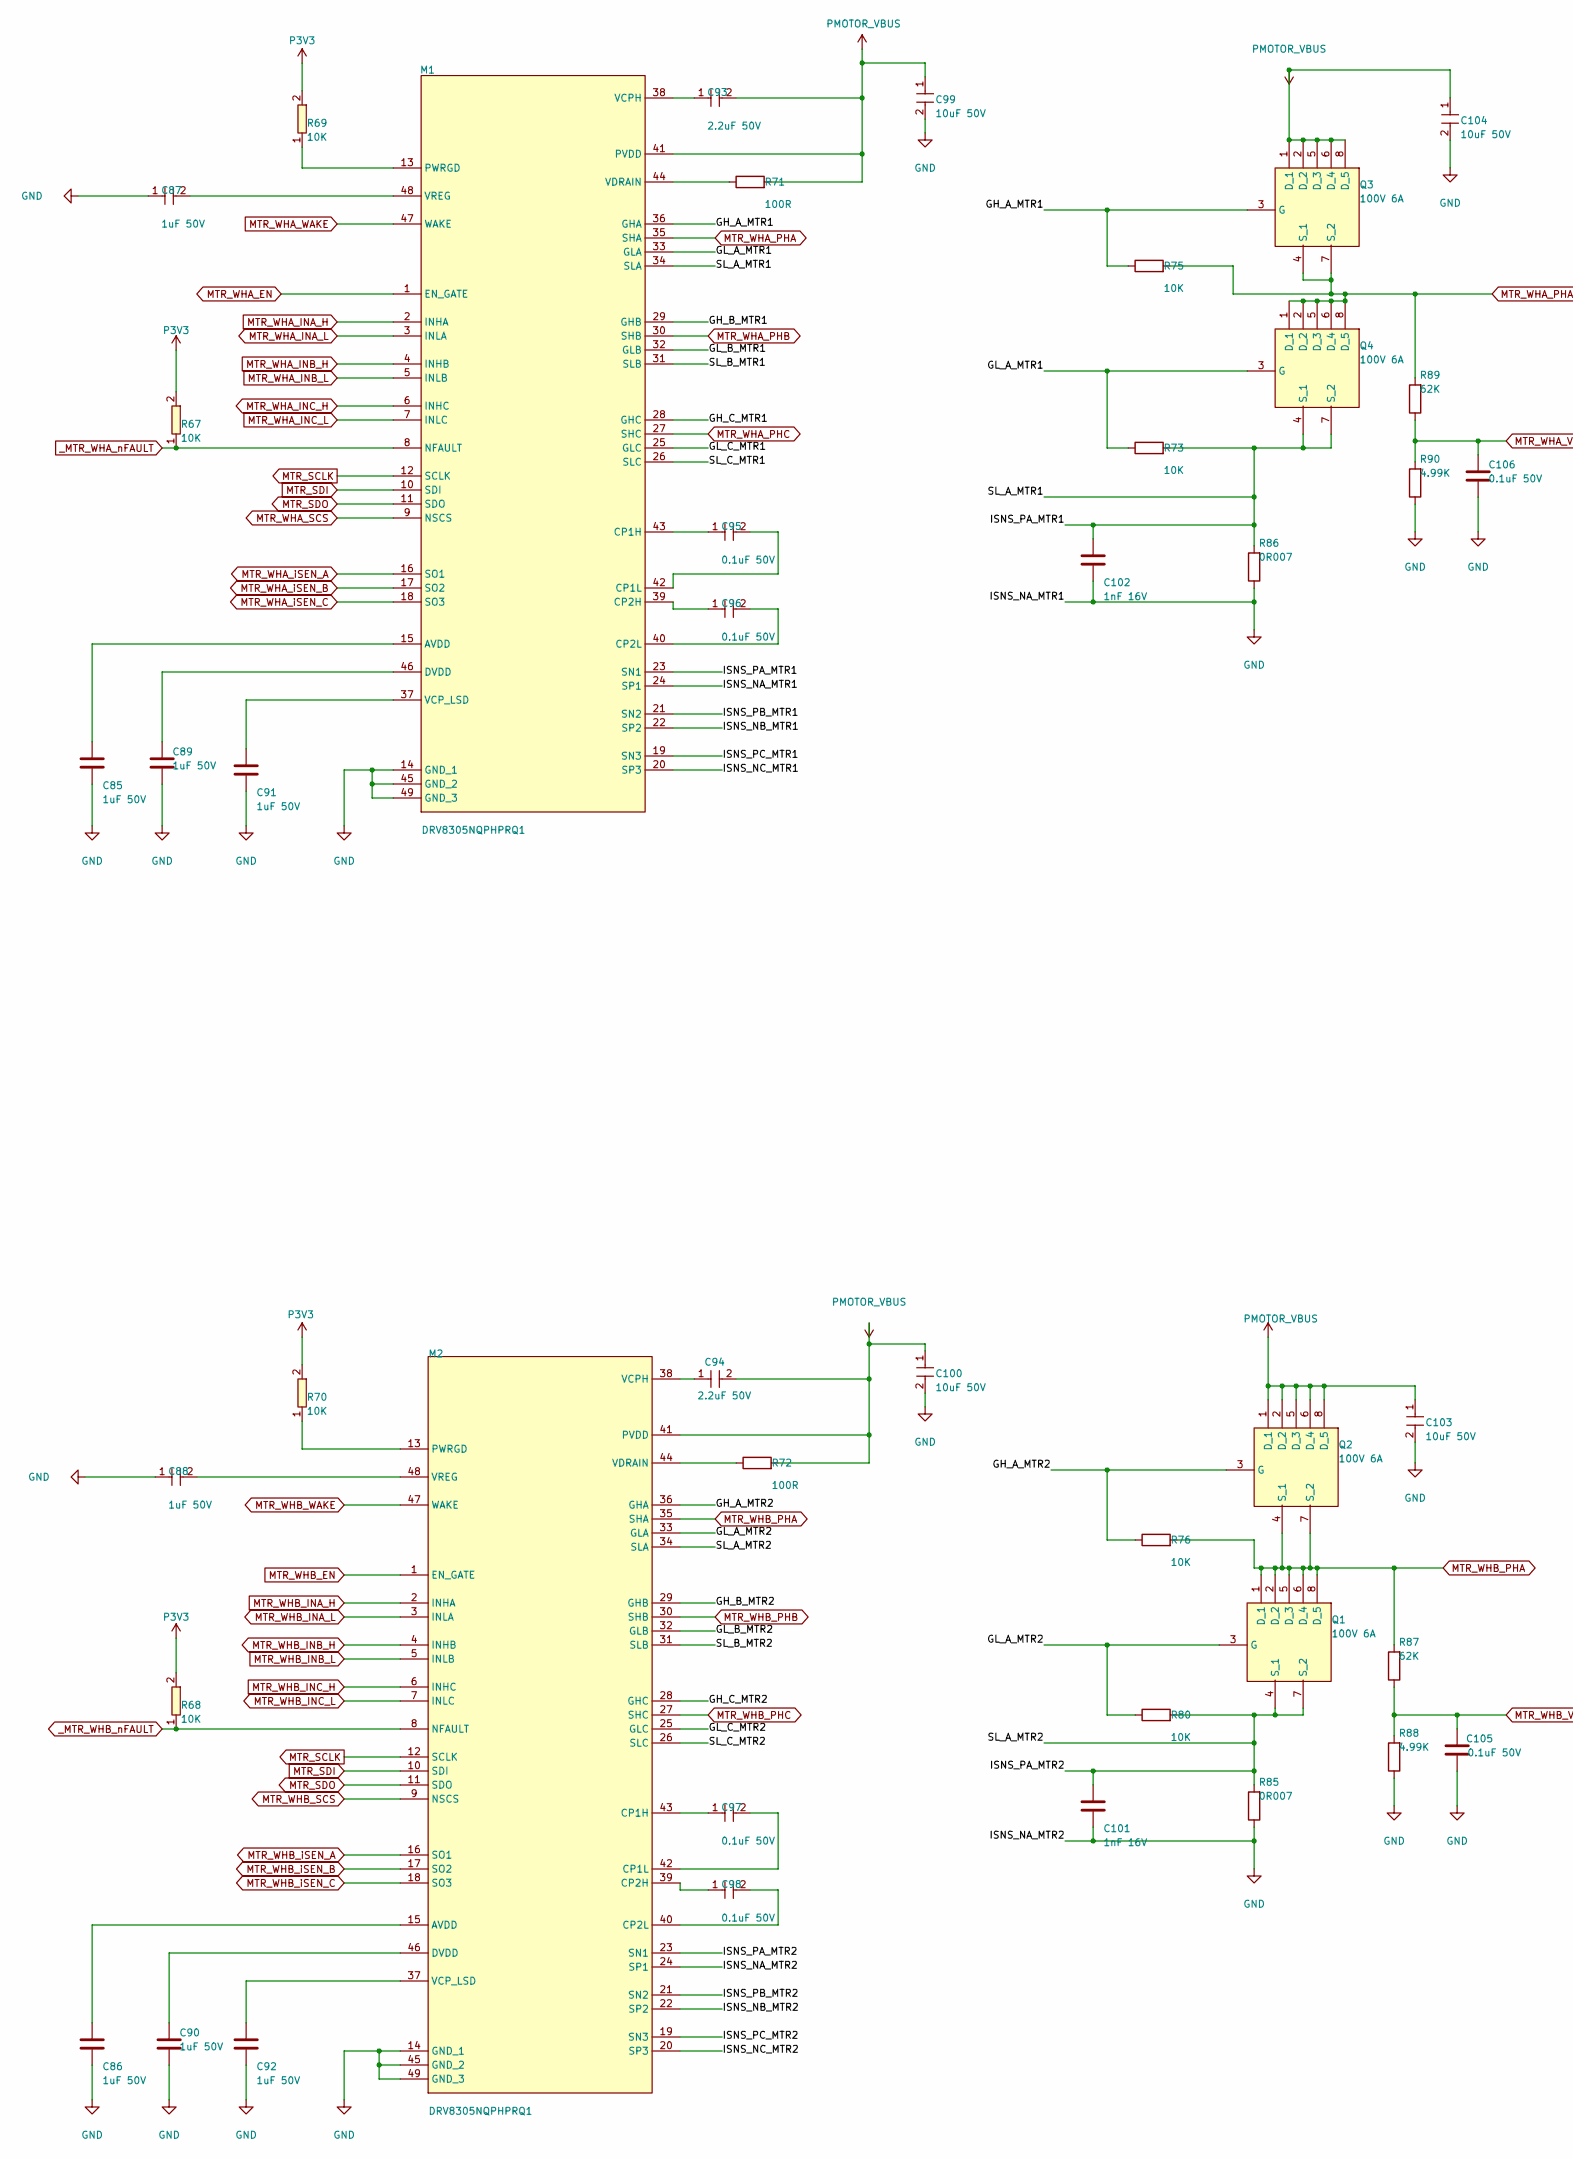
[picture p48: schematic Motor.kicad_sch, part in row 1, column 1]

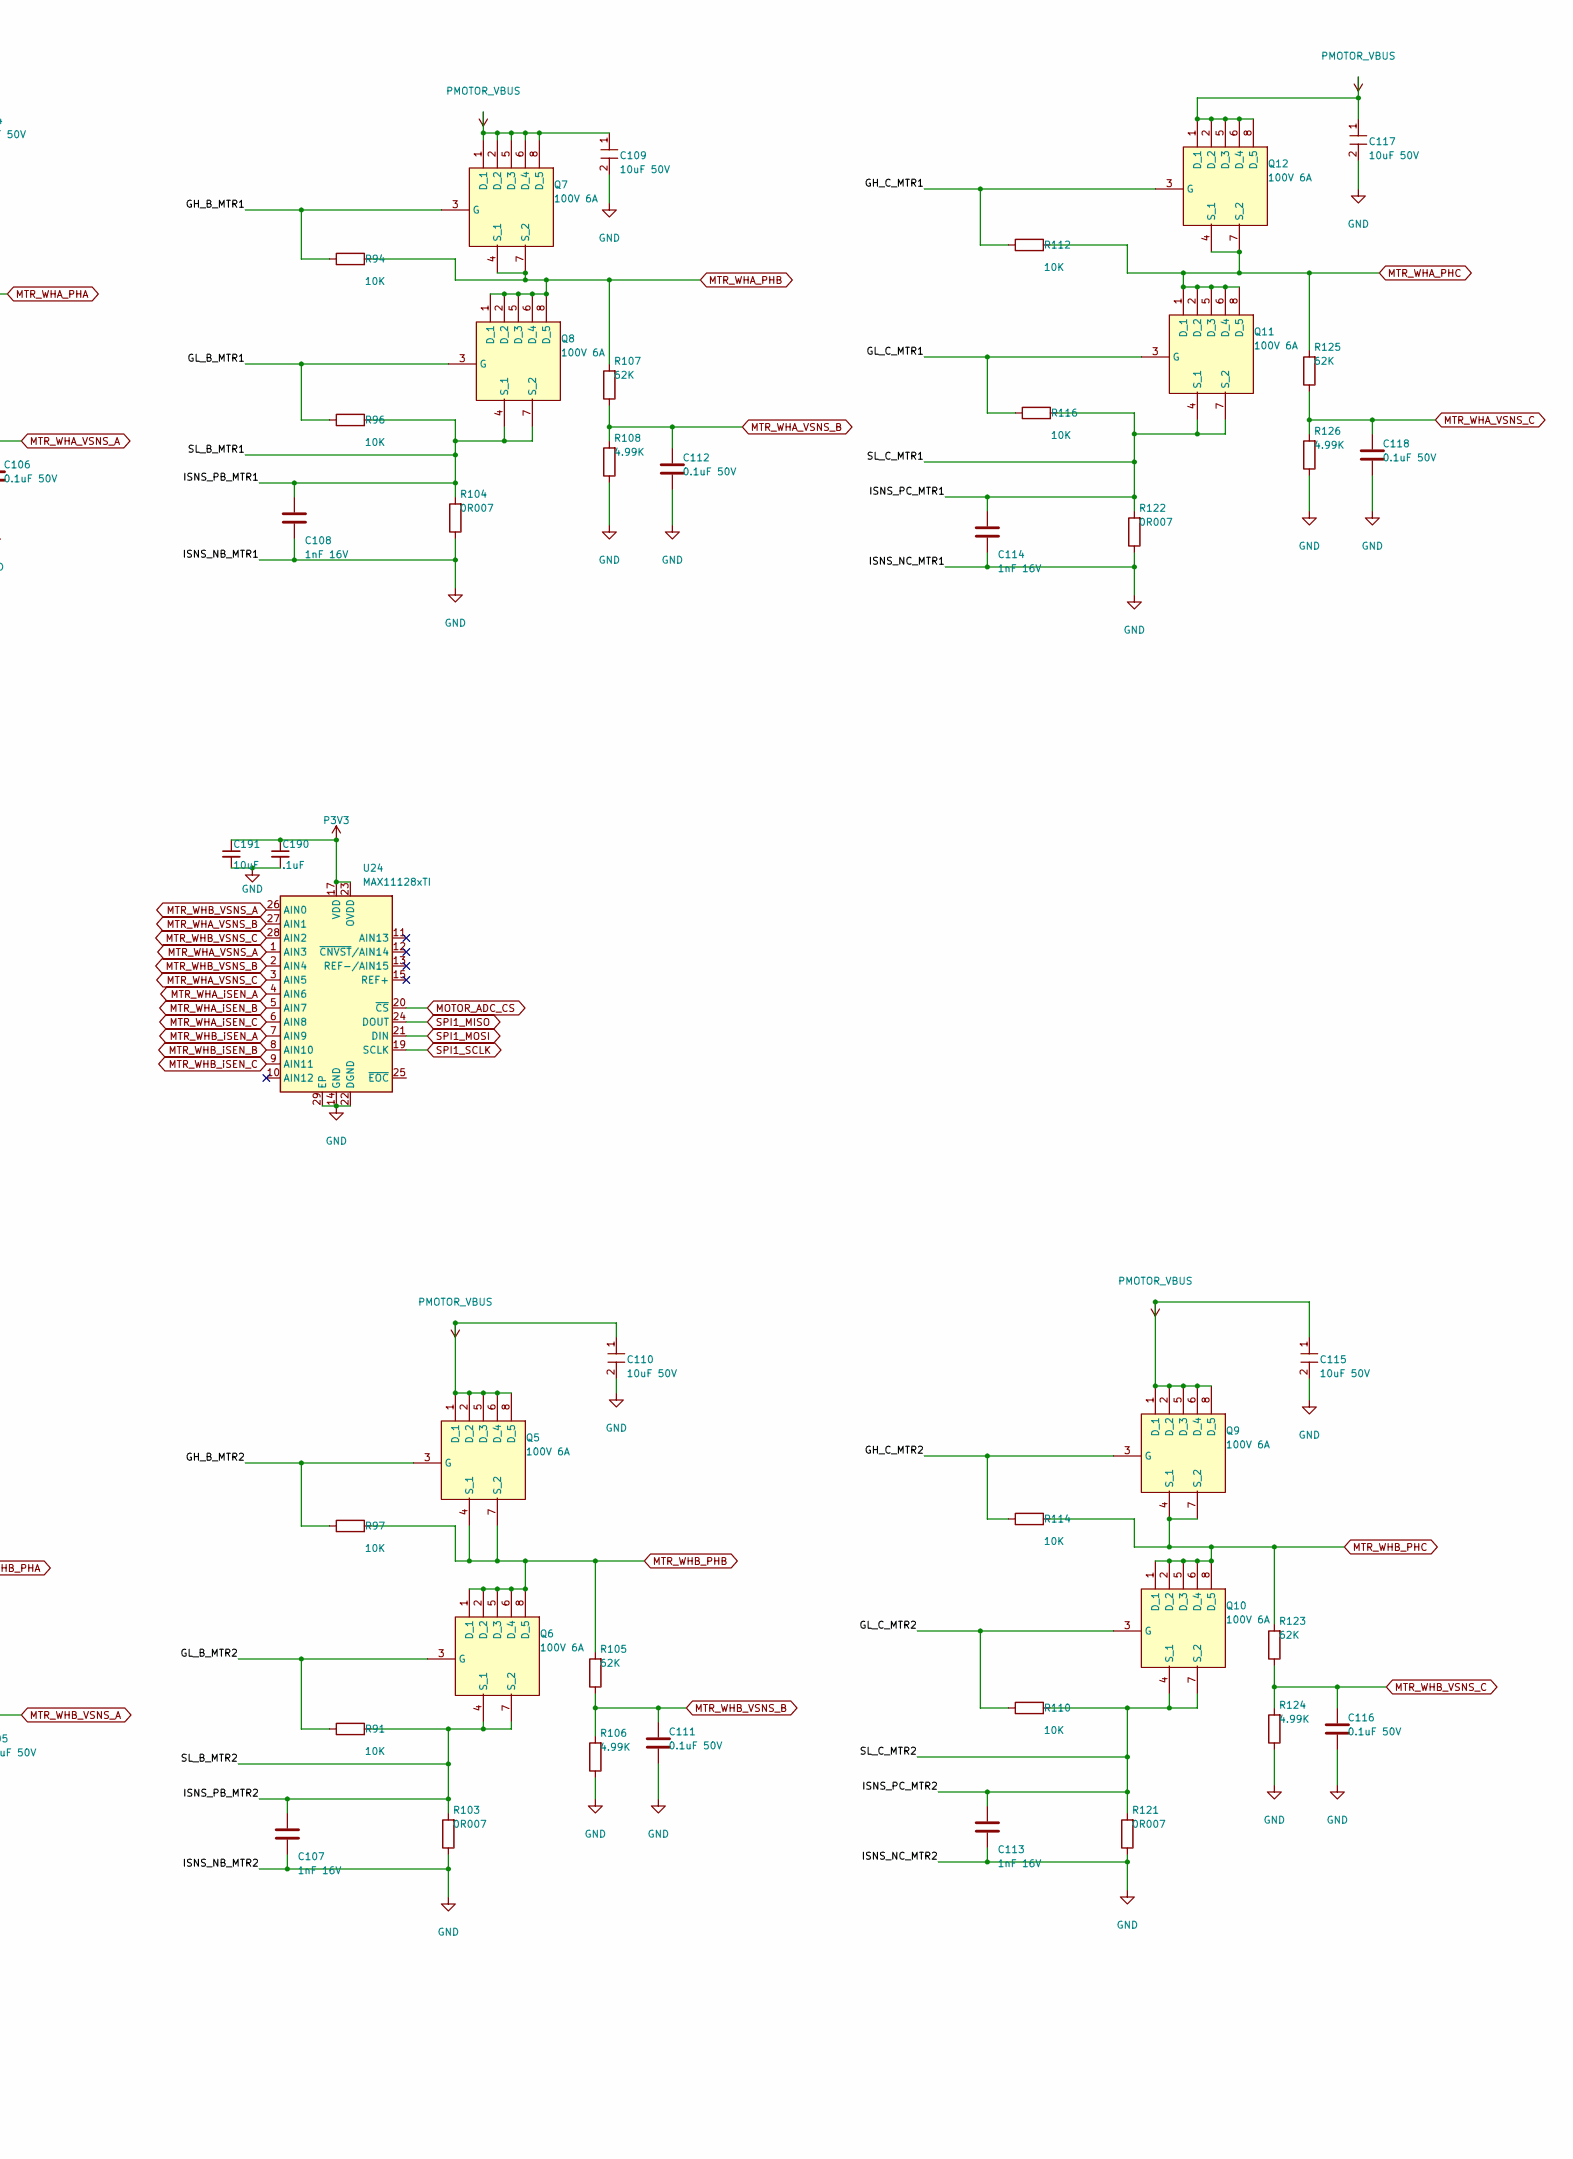
[picture p49: schematic Motor.kicad_sch, part in row 1, column 2]

Parts:
C85, C86, C87, C88, C89, C90, C91, C92: 1uF 50V; C_0603_1608Metric
C93, C94: 2.2uF 50V; C_0603_1608Metric
C95, C96, C97, C98, C105, C106, C111, C112, C116, C118: 0.1uF 50V; C_0603_1608Metric
C99, C100, C103, C104, C109, C110, C115, C117: 10uF 50V; C_0805_2012Metric
C101, C102, C107, C108, C113, C114: 1nF 16V; C_0603_1608Metric
C190: .1uF; C_0402_1005Metric
C191: 10uF; C_0603_1608Metric
M1, M2: DRV8305NQPHPRQ1; LQFP-48-1EP_7x7mm_P0.5mm_EP3.6x3.6mm; MANUFACTURER_PART_NUMBER DRV8305NQPHPRQ1; MOUSER PART NUMBER 595-DRV8305NQPHPRQ1
Q1, Q2, Q3, Q4, Q5, Q6, Q7, Q8, Q9, Q10, Q11, Q12: 100V 6A; UDFN6B; MANUFACTURER_PART_NUMBER SSM6K341NU,LF; MOUSER PART NUMBER 757-SSM6K341NULF
R67, R68, R69, R70: 10K; R_0402_1005Metric
R71, R72: 100R; R_0603_1608Metric
R73, R75, R76, R80, R91, R94, R96, R97, R110, R112, R114, R116: 10K; R_0603_1608Metric
R85, R86, R103, R104, R121, R122: 0R007; R_0603_1608Metric
R87, R89, R105, R107, R123, R125: 62K; R_0603_1608Metric
R88, R90, R106, R108, R124, R126: 4.99K; R_0603_1608Metric
U24: MAX11128xTI; TQFN-28-1EP_5x5mm_P0.5mm_EP3.25x3.25mm

Connections:
GH_A_MTR1: M1.36 (GHA), Q3.3 (G), R75.1
GH_A_MTR2: M2.36 (GHA), Q2.3 (G), R76.1
GH_B_MTR1: M1.29 (GHB), Q7.3 (G), R94.1
GH_B_MTR2: M2.29 (GHB), Q5.3 (G), R97.1
GH_C_MTR1: M1.28 (GHC), Q12.3 (G), R112.1
GH_C_MTR2: M2.28 (GHC), Q9.3 (G), R114.1
GL_A_MTR1: M1.33 (GLA), Q4.3 (G), R73.1
GL_A_MTR2: M2.33 (GLA), Q1.3 (G), R80.1
GL_B_MTR1: M1.32 (GLB), Q8.3 (G), R96.1
GL_B_MTR2: M2.32 (GLB), Q6.3 (G), R91.1
GL_C_MTR1: M1.25 (GLC), Q11.3 (G), R116.1
GL_C_MTR2: M2.25 (GLC), Q10.3 (G), R110.1
GND: C85.2, C86.2, C87.1, C88.1, C89.1, C90.1, C91.2, C92.2, C99.2, C100.2, C101.2, C102.2, C103.2, C104.2, C105.1, C106.1, C107.2, C108.2, C109.2, C110.2, C111.1, C112.1, C113.2, C114.2, C115.2, C116.1, C117.2, C118.1, C190.2, C191.2, M1.14 (GND_1), M1.20 (SP3), M1.22 (SP2), M1.24 (SP1), M1.45 (GND_2), M1.49 (GND_3), M2.14 (GND_1), M2.20 (SP3), M2.22 (SP2), M2.24 (SP1), M2.45 (GND_2), M2.49 (GND_3), R85.1, R86.1, R88.1, R90.1, R103.1, R104.1, R106.1, R108.1, R121.1, R122.1, R124.1, R126.1, U24.14 (GND), U24.16 (GND), U24.22 (DGND), U24.29 (EP)
ISNS_PA_MTR1: C102.1, M1.23 (SN1), M1.34 (SLA), Q4.4 (S_1), Q4.7 (S_2), R73.2, R86.2
ISNS_PA_MTR2: C101.1, M2.23 (SN1), M2.34 (SLA), Q1.4 (S_1), Q1.7 (S_2), R80.2, R85.2
ISNS_PB_MTR1: C108.1, M1.21 (SN2), M1.31 (SLB), Q8.4 (S_1), Q8.7 (S_2), R96.2, R104.2
ISNS_PB_MTR2: C107.1, M2.21 (SN2), M2.31 (SLB), Q6.4 (S_1), Q6.7 (S_2), R91.2, R103.2
ISNS_PC_MTR1: C114.1, M1.19 (SN3), M1.26 (SLC), Q11.4 (S_1), Q11.7 (S_2), R116.2, R122.2
ISNS_PC_MTR2: C113.1, M2.19 (SN3), M2.26 (SLC), Q10.4 (S_1), Q10.7 (S_2), R110.2, R121.2
MOTOR_ADC_CS: U24.20 (~CS)
MTR_SCLK: M1.12 (SCLK), M2.12 (SCLK)
MTR_SDI: M1.10 (SDI), M2.10 (SDI)
MTR_SDO: M1.11 (SDO), M2.11 (SDO)
MTR_WHA_EN: M1.1 (EN_GATE)
MTR_WHA_INA_H: M1.2 (INHA)
MTR_WHA_INA_L: M1.3 (INLA)
MTR_WHA_INB_H: M1.4 (INHB)
MTR_WHA_INB_L: M1.5 (INLB)
MTR_WHA_INC_H: M1.6 (INHC)
MTR_WHA_INC_L: M1.7 (INLC)
MTR_WHA_PHA: M1.35 (SHA), Q3.4 (S_1), Q3.7 (S_2), Q4.1 (D_1), Q4.2 (D_2), Q4.5 (D_3), Q4.6 (D_4), Q4.8 (D_5), R75.2, R89.2
MTR_WHA_PHB: M1.30 (SHB), Q7.4 (S_1), Q7.7 (S_2), Q8.1 (D_1), Q8.2 (D_2), Q8.5 (D_3), Q8.6 (D_4), Q8.8 (D_5), R94.2, R107.2
MTR_WHA_PHC: M1.27 (SHC), Q11.1 (D_1), Q11.2 (D_2), Q11.5 (D_3), Q11.6 (D_4), Q11.8 (D_5), Q12.4 (S_1), Q12.7 (S_2), R112.2, R125.2
MTR_WHA_SCS: M1.9 (NSCS)
MTR_WHA_VSNS_A: C106.2, R89.1, R90.2, U24.1 (AIN3)
MTR_WHA_VSNS_B: C112.2, R107.1, R108.2, U24.27 (AIN1)
MTR_WHA_VSNS_C: C118.2, R125.1, R126.2, U24.3 (AIN5)
MTR_WHA_WAKE: M1.47 (WAKE)
MTR_WHA_iSEN_A: M1.16 (SO1), U24.4 (AIN6)
MTR_WHA_iSEN_B: M1.17 (SO2), U24.5 (AIN7)
MTR_WHA_iSEN_C: M1.18 (SO3), U24.6 (AIN8)
MTR_WHB_EN: M2.1 (EN_GATE)
MTR_WHB_INA_H: M2.2 (INHA)
MTR_WHB_INA_L: M2.3 (INLA)
MTR_WHB_INB_H: M2.4 (INHB)
MTR_WHB_INB_L: M2.5 (INLB)
MTR_WHB_INC_H: M2.6 (INHC)
MTR_WHB_INC_L: M2.7 (INLC)
MTR_WHB_PHA: M2.35 (SHA), Q1.1 (D_1), Q1.2 (D_2), Q1.5 (D_3), Q1.6 (D_4), Q1.8 (D_5), Q2.4 (S_1), Q2.7 (S_2), R76.2, R87.2
MTR_WHB_PHB: M2.30 (SHB), Q5.4 (S_1), Q5.7 (S_2), Q6.1 (D_1), Q6.2 (D_2), Q6.5 (D_3), Q6.6 (D_4), Q6.8 (D_5), R97.2, R105.2
MTR_WHB_PHC: M2.27 (SHC), Q9.4 (S_1), Q9.7 (S_2), Q10.1 (D_1), Q10.2 (D_2), Q10.5 (D_3), Q10.6 (D_4), Q10.8 (D_5), R114.2, R123.2
MTR_WHB_SCS: M2.9 (NSCS)
MTR_WHB_VSNS_A: C105.2, R87.1, R88.2, U24.26 (AIN0)
MTR_WHB_VSNS_B: C111.2, R105.1, R106.2, U24.2 (AIN4)
MTR_WHB_VSNS_C: C116.2, R123.1, R124.2, U24.28 (AIN2)
MTR_WHB_WAKE: M2.47 (WAKE)
MTR_WHB_iSEN_A: M2.16 (SO1), U24.7 (AIN9)
MTR_WHB_iSEN_B: M2.17 (SO2), U24.8 (AIN10)
MTR_WHB_iSEN_C: M2.18 (SO3), U24.9 (AIN11)
unnamed: C85.1, M1.15 (AVDD)
unnamed: C86.1, M2.15 (AVDD)
unnamed: C87.2, M1.48 (VREG)
unnamed: C88.2, M2.48 (VREG)
unnamed: C89.2, M1.46 (DVDD)
unnamed: C90.2, M2.46 (DVDD)
unnamed: C91.1, M1.37 (VCP_LSD)
unnamed: C92.1, M2.37 (VCP_LSD)
unnamed: C93.1, M1.38 (VCPH)
unnamed: C94.1, M2.38 (VCPH)
unnamed: C95.1, M1.43 (CP1H)
unnamed: C95.2, M1.42 (CP1L)
unnamed: C96.1, M1.39 (CP2H)
unnamed: C96.2, M1.40 (CP2L)
unnamed: C97.1, M2.43 (CP1H)
unnamed: C97.2, M2.42 (CP1L)
unnamed: C98.1, M2.39 (CP2H)
unnamed: C98.2, M2.40 (CP2L)
unnamed: M1.13 (PWRGD), R69.1
unnamed: M1.44 (VDRAIN), R71.1
unnamed: M2.13 (PWRGD), R70.1
unnamed: M2.44 (VDRAIN), R72.1
P3V3: C190.1, C191.1, R67.2, R68.2, R69.2, R70.2, U24.17 (VDD), U24.18 (VDD), U24.23 (OVDD)
PMOTOR_VBUS: C93.2, C94.2, C99.1, C100.1, C103.1, C104.1, C109.1, C110.1, C115.1, C117.1, M1.41 (PVDD), M2.41 (PVDD), Q2.1 (D_1), Q2.2 (D_2), Q2.5 (D_3), Q2.6 (D_4), Q2.8 (D_5), Q3.1 (D_1), Q3.2 (D_2), Q3.5 (D_3), Q3.6 (D_4), Q3.8 (D_5), Q5.1 (D_1), Q5.2 (D_2), Q5.5 (D_3), Q5.6 (D_4), Q5.8 (D_5), Q7.1 (D_1), Q7.2 (D_2), Q7.5 (D_3), Q7.6 (D_4), Q7.8 (D_5), Q9.1 (D_1), Q9.2 (D_2), Q9.5 (D_3), Q9.6 (D_4), Q9.8 (D_5), Q12.1 (D_1), Q12.2 (D_2), Q12.5 (D_3), Q12.6 (D_4), Q12.8 (D_5), R71.2, R72.2
SPI1_MISO: U24.24 (DOUT)
SPI1_MOSI: U24.21 (DIN)
SPI1_SCLK: U24.19 (SCLK)
_MTR_WHA_nFAULT: M1.8 (NFAULT), R67.1
_MTR_WHB_nFAULT: M2.8 (NFAULT), R68.1
