CooterPMcGrew/Flight_Computer_REV01/Power.kicad_sch

## KiCad design Power.kicad_sch (2026-05-14)

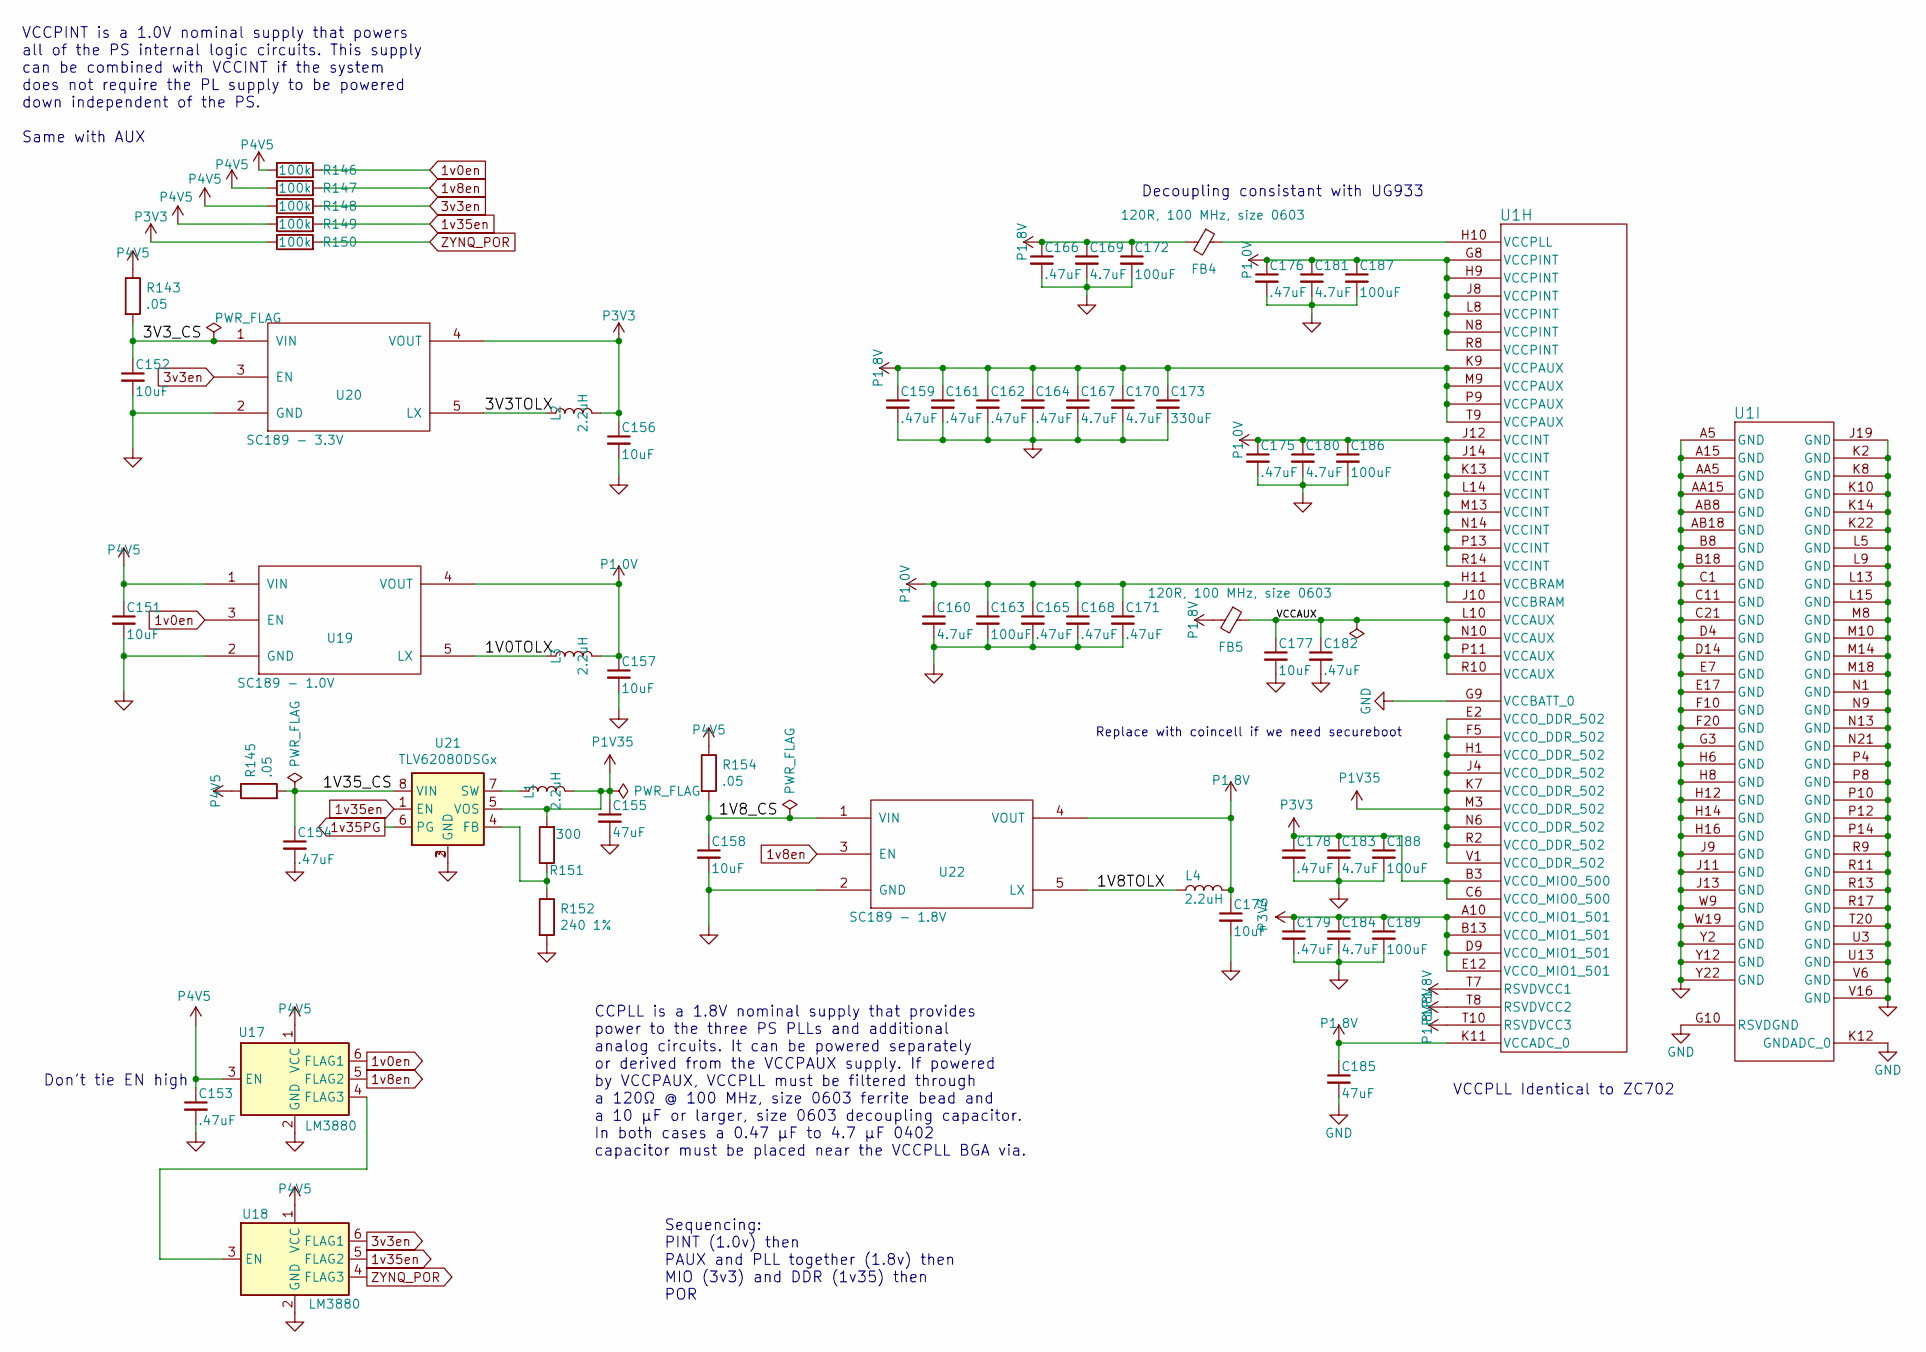
[picture p50: schematic Power.kicad_sch]

Parts:
C151, C152, C156, C157, C158, C174, C177: 10uF; C_0603_1608Metric
C153, C154, C159, C161, C162, C164, C165, C166, C168, C171, C175, C176, C178, C179, C182: .47uF; C_0402_1005Metric
C155, C185: 47uF; C_0805_2012Metric
C160, C167, C169, C170, C180, C181, C183, C184: 4.7uF; C_0402_1005Metric
C163, C172, C186, C187, C188, C189: 100uF; C_1210_3225Metric
C173: 330uF; C_1206_3216Metric
FB4, FB5: 120R, 100 MHz, size 0603; C_0603_1608Metric
L1, L2, L3, L4: 2.2uH; C_1812_4532Metric
R143, R145, R154: .05; R_2512_6332Metric
R146, R147, R148, R149, R150: 100k; R_0402_1005Metric
R151: 300; R_0402_1005Metric
R152: 240 1%; R_0402_1005Metric
U1: XC7Z020-2CLG484I; BGA-484_19.0x19.0mm_Layout22x22_P0.80mm_dia0.40mm
U17, U18: LM3880; SOT-23-6
U19: SC189 - 1.0V; SOT-23-5
U20: SC189 - 3.3V; SOT-23-5
U21: TLV62080DSGx; WSON-8-1EP_2x2mm_P0.5mm_EP0.9x1.6mm
U22: SC189 - 1.8V; SOT-23-5

Connections:
1V0TOLX: L3.1, U19.5 (LX)
1V8TOLX: L4.1, U22.5 (LX)
1V8_CS: C158.1, R154.2, U22.1 (VIN)
1V35_CS: C154.1, R145.2, U21.8 (VIN)
1v0en: R146.2, U17.6 (FLAG1), U19.3 (EN)
1v8en: R147.2, U17.5 (FLAG2), U22.3 (EN)
1v35PG: U21.6 (PG)
1v35en: R149.2, U18.5 (FLAG2), U21.1 (EN)
3V3TOLX: L2.1, U20.5 (LX)
3V3_CS: C152.1, R143.2, U20.1 (VIN)
3v3en: R148.2, U18.6 (FLAG1), U20.3 (EN)
GND: C151.2, C152.2, C153.2, C154.2, C155.2, C156.2, C157.2, C158.2, C159.2, C160.2, C161.2, C162.2, C163.2, C164.2, C165.2, C166.2, C167.2, C168.2, C169.2, C170.2, C171.2, C172.2, C173.2, C174.2, C175.2, C176.2, C177.2, C178.2, C179.2, C180.2, C181.2, C182.2, C183.2, C184.2, C185.2, C186.2, C187.2, C188.2, C189.2, R152.2, U1.A5 (GND), U1.A15 (GND), U1.AA5 (GND), U1.AA15 (GND), U1.AB8 (GND), U1.AB18 (GND), U1.B8 (GND), U1.B18 (GND), U1.C1 (GND), U1.C11 (GND), U1.C21 (GND), U1.D4 (GND), U1.D14 (GND), U1.E7 (GND), U1.E17 (GND), U1.F10 (GND), U1.F20 (GND), U1.G3 (GND), U1.G9 (VCCBATT_0), U1.G10 (RSVDGND), U1.H6 (GND), U1.H8 (GND), U1.H12 (GND), U1.H14 (GND), U1.H16 (GND), U1.J9 (GND), U1.J11 (GND), U1.J13 (GND), U1.J19 (GND), U1.K2 (GND), U1.K8 (GND), U1.K10 (GND), U1.K12 (GNDADC_0), U1.K14 (GND), U1.K22 (GND), U1.L5 (GND), U1.L9 (GND), U1.L13 (GND), U1.L15 (GND), U1.M8 (GND), U1.M10 (GND), U1.M14 (GND), U1.M18 (GND), U1.N1 (GND), U1.N9 (GND), U1.N13 (GND), U1.N21 (GND), U1.P4 (GND), U1.P8 (GND), U1.P10 (GND), U1.P12 (GND), U1.P14 (GND), U1.R9 (GND), U1.R11 (GND), U1.R13 (GND), U1.R17 (GND), U1.T20 (GND), U1.U3 (GND), U1.U13 (GND), U1.V6 (GND), U1.V16 (GND), U1.W9 (GND), U1.W19 (GND), U1.Y2 (GND), U1.Y12 (GND), U1.Y22 (GND), U17.2 (GND), U18.2 (GND), U19.2 (GND), U20.2 (GND), U21.2 (GND), U21.3 (GND), U21.9 (GND), U22.2 (GND)
unnamed: FB4.1, U1.H10 (VCCPLL)
unnamed: L1.1, U21.7 (SW)
unnamed: R151.1, R152.1, U21.4 (FB)
unnamed: U17.4 (FLAG3), U18.3 (EN)
P1.0V: C157.1, C160.1, C163.1, C165.1, C168.1, C171.1, C175.1, C176.1, C180.1, C181.1, C186.1, C187.1, L3.2, U1.G8 (VCCPINT), U1.H9 (VCCPINT), U1.H11 (VCCBRAM), U1.J8 (VCCPINT), U1.J10 (VCCBRAM), U1.J12 (VCCINT), U1.J14 (VCCINT), U1.K13 (VCCINT), U1.L8 (VCCPINT), U1.L14 (VCCINT), U1.M13 (VCCINT), U1.N8 (VCCPINT), U1.N14 (VCCINT), U1.P13 (VCCINT), U1.R8 (VCCPINT), U1.R14 (VCCINT), U19.4 (VOUT)
P1.8V: C159.1, C161.1, C162.1, C164.1, C166.1, C167.1, C169.1, C170.1, C172.1, C173.1, C174.1, C185.1, FB4.2, FB5.2, L4.2, U1.K9 (VCCPAUX), U1.K11 (VCCADC_0), U1.M9 (VCCPAUX), U1.P9 (VCCPAUX), U1.T7 (RSVDVCC1), U1.T8 (RSVDVCC2), U1.T9 (VCCPAUX), U1.T10 (RSVDVCC3), U22.4 (VOUT)
P1V35: C155.1, L1.2, R151.2, U1.E2 (VCCO_DDR_502), U1.F5 (VCCO_DDR_502), U1.H1 (VCCO_DDR_502), U1.J4 (VCCO_DDR_502), U1.K7 (VCCO_DDR_502), U1.M3 (VCCO_DDR_502), U1.N6 (VCCO_DDR_502), U1.R2 (VCCO_DDR_502), U1.V1 (VCCO_DDR_502), U21.5 (VOS)
P3V3: C156.1, C178.1, C179.1, C183.1, C184.1, C188.1, C189.1, L2.2, R150.1, U1.A10 (VCCO_MIO1_501), U1.B3 (VCCO_MIO0_500), U1.B13 (VCCO_MIO1_501), U1.C6 (VCCO_MIO0_500), U1.D9 (VCCO_MIO1_501), U1.E12 (VCCO_MIO1_501), U20.4 (VOUT)
P4V5: C151.1, C153.1, R143.1, R145.1, R146.1, R147.1, R148.1, R149.1, R154.1, U17.1 (VCC), U17.3 (EN), U18.1 (VCC), U19.1 (VIN)
VCCAUX: C177.1, C182.1, FB5.1, U1.L10 (VCCAUX), U1.N10 (VCCAUX), U1.P11 (VCCAUX), U1.R10 (VCCAUX)
ZYNQ_POR: R150.2, U18.4 (FLAG3)

Notes on the sheet:
Don't tie EN high
Replace with coincell if we need secureboot
Decoupling consistant with UG933
CCPLL is a 1.8V nominal supply that provides power to the three PS PLLs and additional analog circuits. It can be powered separately or derived from the VCCPAUX supply. If powered by VCCPAUX, VCCPLL must be filtered through a 120Ω @ 100 MHz, size 0603 ferrite bead and a 10 µF or larger, size 0603 d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
VCCPINT is a 1.0V nominal supply that powers all of the PS internal logic circuits. This supply can be combined with VCCINT if the system does not require the PL supply to be powered down independent of the PS. Same with AUX
Sequencing: PINT (1.0v) then PAUX and PLL together (1.8v) then MIO (3v3) and DDR (1v35) then POR
VCCPLL Identical to ZC702
