CooterPMcGrew/Flight_Computer_REV01/ZYNQ_BANK_34_35.kicad_sch

## KiCad design ZYNQ_BANK_34_35.kicad_sch (2026-05-14)

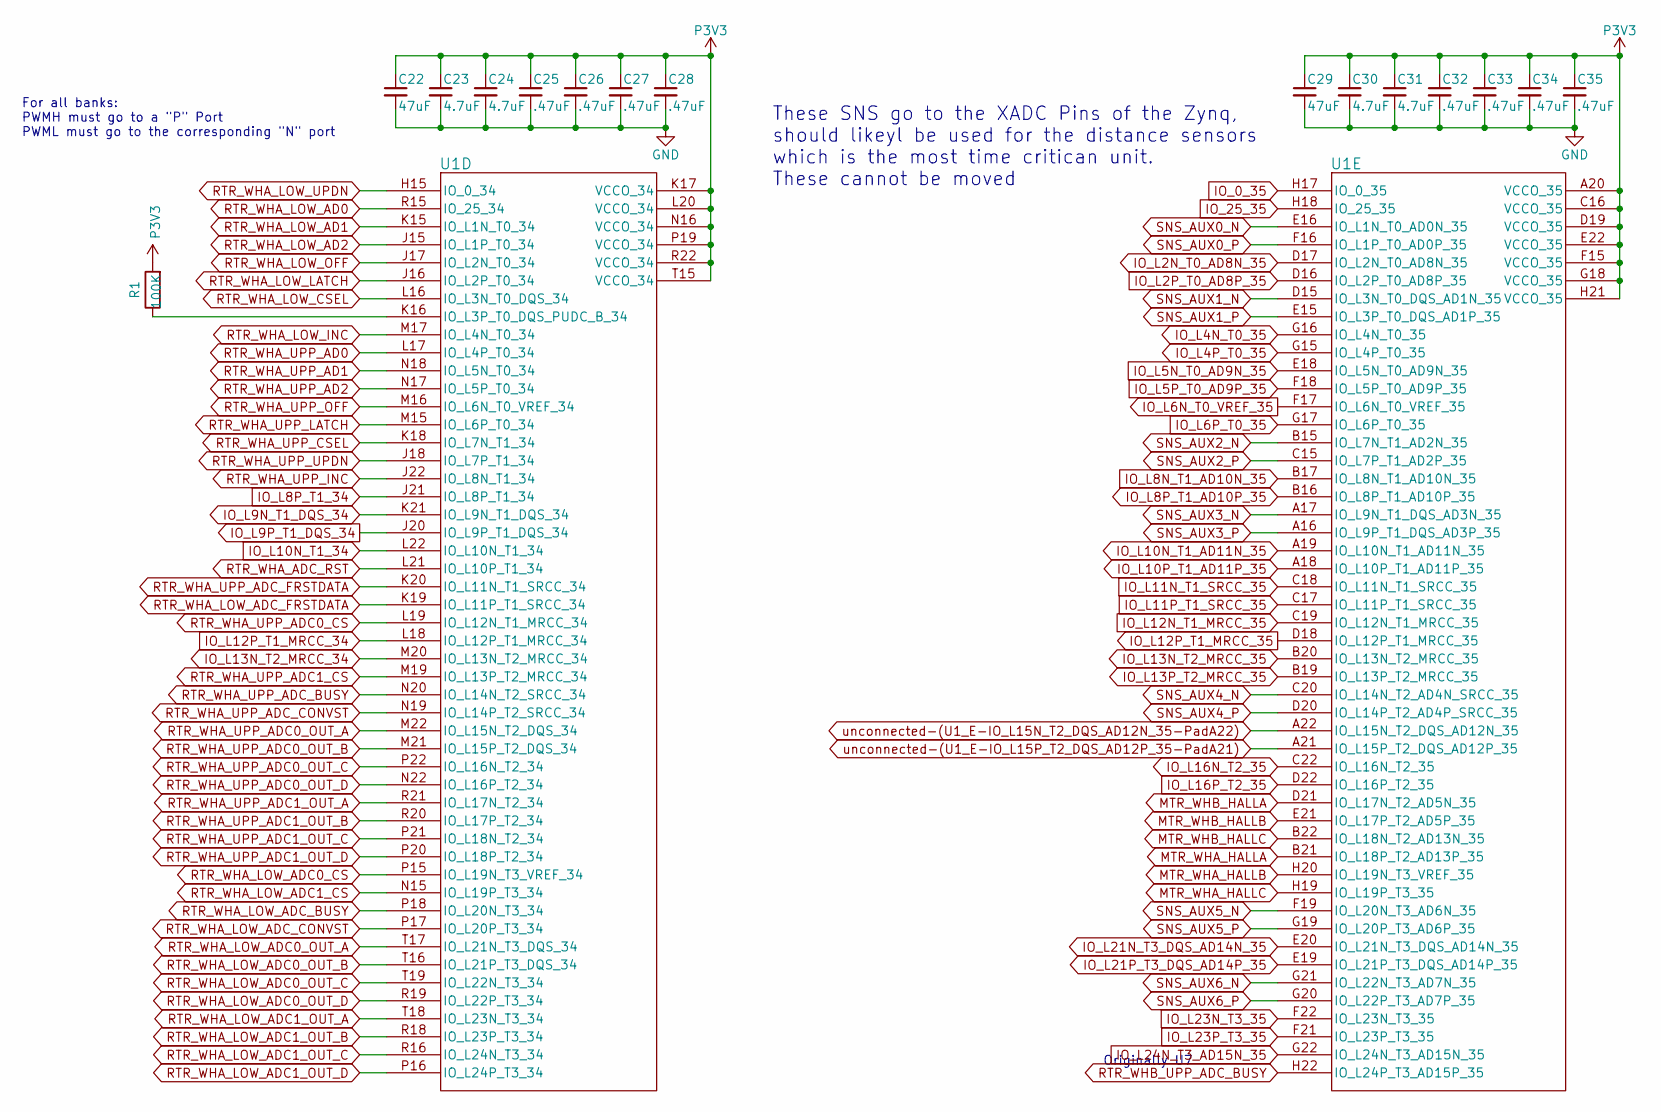
[picture p51: schematic ZYNQ_BANK_34_35.kicad_sch]

Parts:
C22, C29: 47uF; C_1210_3225Metric
C23, C24, C30, C31: 4.7uF; C_0402_1005Metric
C25, C26, C27, C28, C32, C33, C34, C35: .47uF; C_0402_1005Metric
R1: 100K; R_0402_1005Metric
U1: XC7Z020-2CLG484I; BGA-484_19.0x19.0mm_Layout22x22_P0.80mm_dia0.40mm

Connections:
GND: C22.2, C23.2, C24.2, C25.2, C26.2, C27.2, C28.2, C29.2, C30.2, C31.2, C32.2, C33.2, C34.2, C35.2
IO_0_35: U1.H17 (IO_0_35)
IO_25_35: U1.H18 (IO_25_35)
IO_L2N_T0_AD8N_35: U1.D17 (IO_L2N_T0_AD8N_35)
IO_L2P_T0_AD8P_35: U1.D16 (IO_L2P_T0_AD8P_35)
IO_L4N_T0_35: U1.G16 (IO_L4N_T0_35)
IO_L4P_T0_35: U1.G15 (IO_L4P_T0_35)
IO_L5N_T0_AD9N_35: U1.E18 (IO_L5N_T0_AD9N_35)
IO_L5P_T0_AD9P_35: U1.F18 (IO_L5P_T0_AD9P_35)
IO_L6N_T0_VREF_35: U1.F17 (IO_L6N_T0_VREF_35)
IO_L6P_T0_35: U1.G17 (IO_L6P_T0_35)
IO_L8N_T1_AD10N_35: U1.B17 (IO_L8N_T1_AD10N_35)
IO_L8P_T1_34: U1.J21 (IO_L8P_T1_34)
IO_L8P_T1_AD10P_35: U1.B16 (IO_L8P_T1_AD10P_35)
IO_L9N_T1_DQS_34: U1.K21 (IO_L9N_T1_DQS_34)
IO_L9P_T1_DQS_34: U1.J20 (IO_L9P_T1_DQS_34)
IO_L10N_T1_34: U1.L22 (IO_L10N_T1_34)
IO_L10N_T1_AD11N_35: U1.A19 (IO_L10N_T1_AD11N_35)
IO_L10P_T1_AD11P_35: U1.A18 (IO_L10P_T1_AD11P_35)
IO_L11N_T1_SRCC_35: U1.C18 (IO_L11N_T1_SRCC_35)
IO_L11P_T1_SRCC_35: U1.C17 (IO_L11P_T1_SRCC_35)
IO_L12N_T1_MRCC_35: U1.C19 (IO_L12N_T1_MRCC_35)
IO_L12P_T1_MRCC_34: U1.L18 (IO_L12P_T1_MRCC_34)
IO_L12P_T1_MRCC_35: U1.D18 (IO_L12P_T1_MRCC_35)
IO_L13N_T2_MRCC_34: U1.M20 (IO_L13N_T2_MRCC_34)
IO_L13N_T2_MRCC_35: U1.B20 (IO_L13N_T2_MRCC_35)
IO_L13P_T2_MRCC_35: U1.B19 (IO_L13P_T2_MRCC_35)
IO_L16N_T2_35: U1.C22 (IO_L16N_T2_35)
IO_L16P_T2_35: U1.D22 (IO_L16P_T2_35)
IO_L21N_T3_DQS_AD14N_35: U1.E20 (IO_L21N_T3_DQS_AD14N_35)
IO_L21P_T3_DQS_AD14P_35: U1.E19 (IO_L21P_T3_DQS_AD14P_35)
IO_L23N_T3_35: U1.F22 (IO_L23N_T3_35)
IO_L23P_T3_35: U1.F21 (IO_L23P_T3_35)
IO_L24N_T3_AD15N_35: U1.G22 (IO_L24N_T3_AD15N_35)
MTR_WHA_HALLA: U1.B21 (IO_L18P_T2_AD13P_35)
MTR_WHA_HALLB: U1.H20 (IO_L19N_T3_VREF_35)
MTR_WHA_HALLC: U1.H19 (IO_L19P_T3_35)
MTR_WHB_HALLA: U1.D21 (IO_L17N_T2_AD5N_35)
MTR_WHB_HALLB: U1.E21 (IO_L17P_T2_AD5P_35)
MTR_WHB_HALLC: U1.B22 (IO_L18N_T2_AD13N_35)
unnamed: R1.1, U1.K16 (IO_L3P_T0_DQS_PUDC_B_34)
P3V3: C22.1, C23.1, C24.1, C25.1, C26.1, C27.1, C28.1, C29.1, C30.1, C31.1, C32.1, C33.1, C34.1, C35.1, R1.2, U1.A20 (VCCO_35), U1.C16 (VCCO_35), U1.D19 (VCCO_35), U1.E22 (VCCO_35), U1.F15 (VCCO_35), U1.G18 (VCCO_35), U1.H21 (VCCO_35), U1.K17 (VCCO_34), U1.L20 (VCCO_34), U1.N16 (VCCO_34), U1.P19 (VCCO_34), U1.R22 (VCCO_34), U1.T15 (VCCO_34)
RTR_WHA_ADC_RST: U1.L21 (IO_L10P_T1_34)
RTR_WHA_LOW_AD0: U1.R15 (IO_25_34)
RTR_WHA_LOW_AD1: U1.K15 (IO_L1N_T0_34)
RTR_WHA_LOW_AD2: U1.J15 (IO_L1P_T0_34)
RTR_WHA_LOW_ADC0_CS: U1.P15 (IO_L19N_T3_VREF_34)
RTR_WHA_LOW_ADC0_OUT_A: U1.T17 (IO_L21N_T3_DQS_34)
RTR_WHA_LOW_ADC0_OUT_B: U1.T16 (IO_L21P_T3_DQS_34)
RTR_WHA_LOW_ADC0_OUT_C: U1.T19 (IO_L22N_T3_34)
RTR_WHA_LOW_ADC0_OUT_D: U1.R19 (IO_L22P_T3_34)
RTR_WHA_LOW_ADC1_CS: U1.N15 (IO_L19P_T3_34)
RTR_WHA_LOW_ADC1_OUT_A: U1.T18 (IO_L23N_T3_34)
RTR_WHA_LOW_ADC1_OUT_B: U1.R18 (IO_L23P_T3_34)
RTR_WHA_LOW_ADC1_OUT_C: U1.R16 (IO_L24N_T3_34)
RTR_WHA_LOW_ADC1_OUT_D: U1.P16 (IO_L24P_T3_34)
RTR_WHA_LOW_ADC_BUSY: U1.P18 (IO_L20N_T3_34)
RTR_WHA_LOW_ADC_CONVST: U1.P17 (IO_L20P_T3_34)
RTR_WHA_LOW_ADC_FRSTDATA: U1.K19 (IO_L11P_T1_SRCC_34)
RTR_WHA_LOW_CSEL: U1.L16 (IO_L3N_T0_DQS_34)
RTR_WHA_LOW_INC: U1.M17 (IO_L4N_T0_34)
RTR_WHA_LOW_LATCH: U1.J16 (IO_L2P_T0_34)
RTR_WHA_LOW_OFF: U1.J17 (IO_L2N_T0_34)
RTR_WHA_LOW_UPDN: U1.H15 (IO_0_34)
RTR_WHA_UPP_AD0: U1.L17 (IO_L4P_T0_34)
RTR_WHA_UPP_AD1: U1.N18 (IO_L5N_T0_34)
RTR_WHA_UPP_AD2: U1.N17 (IO_L5P_T0_34)
RTR_WHA_UPP_ADC0_CS: U1.L19 (IO_L12N_T1_MRCC_34)
RTR_WHA_UPP_ADC0_OUT_A: U1.M22 (IO_L15N_T2_DQS_34)
RTR_WHA_UPP_ADC0_OUT_B: U1.M21 (IO_L15P_T2_DQS_34)
RTR_WHA_UPP_ADC0_OUT_C: U1.P22 (IO_L16N_T2_34)
RTR_WHA_UPP_ADC0_OUT_D: U1.N22 (IO_L16P_T2_34)
RTR_WHA_UPP_ADC1_CS: U1.M19 (IO_L13P_T2_MRCC_34)
RTR_WHA_UPP_ADC1_OUT_A: U1.R21 (IO_L17N_T2_34)
RTR_WHA_UPP_ADC1_OUT_B: U1.R20 (IO_L17P_T2_34)
RTR_WHA_UPP_ADC1_OUT_C: U1.P21 (IO_L18N_T2_34)
RTR_WHA_UPP_ADC1_OUT_D: U1.P20 (IO_L18P_T2_34)
RTR_WHA_UPP_ADC_BUSY: U1.N20 (IO_L14N_T2_SRCC_34)
RTR_WHA_UPP_ADC_CONVST: U1.N19 (IO_L14P_T2_SRCC_34)
RTR_WHA_UPP_ADC_FRSTDATA: U1.K20 (IO_L11N_T1_SRCC_34)
RTR_WHA_UPP_CSEL: U1.K18 (IO_L7N_T1_34)
RTR_WHA_UPP_INC: U1.J22 (IO_L8N_T1_34)
RTR_WHA_UPP_LATCH: U1.M15 (IO_L6P_T0_34)
RTR_WHA_UPP_OFF: U1.M16 (IO_L6N_T0_VREF_34)
RTR_WHA_UPP_UPDN: U1.J18 (IO_L7P_T1_34)
RTR_WHB_UPP_ADC_BUSY: U1.H22 (IO_L24P_T3_AD15P_35)
SNS_AUX0_N: U1.E16 (IO_L1N_T0_AD0N_35)
SNS_AUX0_P: U1.F16 (IO_L1P_T0_AD0P_35)
SNS_AUX1_N: U1.D15 (IO_L3N_T0_DQS_AD1N_35)
SNS_AUX1_P: U1.E15 (IO_L3P_T0_DQS_AD1P_35)
SNS_AUX2_N: U1.B15 (IO_L7N_T1_AD2N_35)
SNS_AUX2_P: U1.C15 (IO_L7P_T1_AD2P_35)
SNS_AUX3_N: U1.A17 (IO_L9N_T1_DQS_AD3N_35)
SNS_AUX3_P: U1.A16 (IO_L9P_T1_DQS_AD3P_35)
SNS_AUX4_N: U1.C20 (IO_L14N_T2_AD4N_SRCC_35)
SNS_AUX4_P: U1.D20 (IO_L14P_T2_AD4P_SRCC_35)
SNS_AUX5_N: U1.F19 (IO_L20N_T3_AD6N_35)
SNS_AUX5_P: U1.G19 (IO_L20P_T3_AD6P_35)
SNS_AUX6_N: U1.G21 (IO_L22N_T3_AD7N_35)
SNS_AUX6_P: U1.G20 (IO_L22P_T3_AD7P_35)
unconnected-(U1_E-IO_L15N_T2_DQS_AD12N_35-PadA22): U1.A22 (IO_L15N_T2_DQS_AD12N_35)
unconnected-(U1_E-IO_L15P_T2_DQS_AD12P_35-PadA21): U1.A21 (IO_L15P_T2_DQS_AD12P_35)

Notes on the sheet:
These SNS go to the XADC Pins of the Zynq, should likeyl be used for the distance sensors which is the most time critican unit. These cannot be moved
Originally U7
For all banks: PWMH must go to a "P" Port PWML must go to the corresponding "N" port
