CooterPMcGrew/Flight_Computer_REV01/ZYNQ_Banks.kicad_sch

## KiCad design ZYNQ_Banks.kicad_sch (2026-05-14)

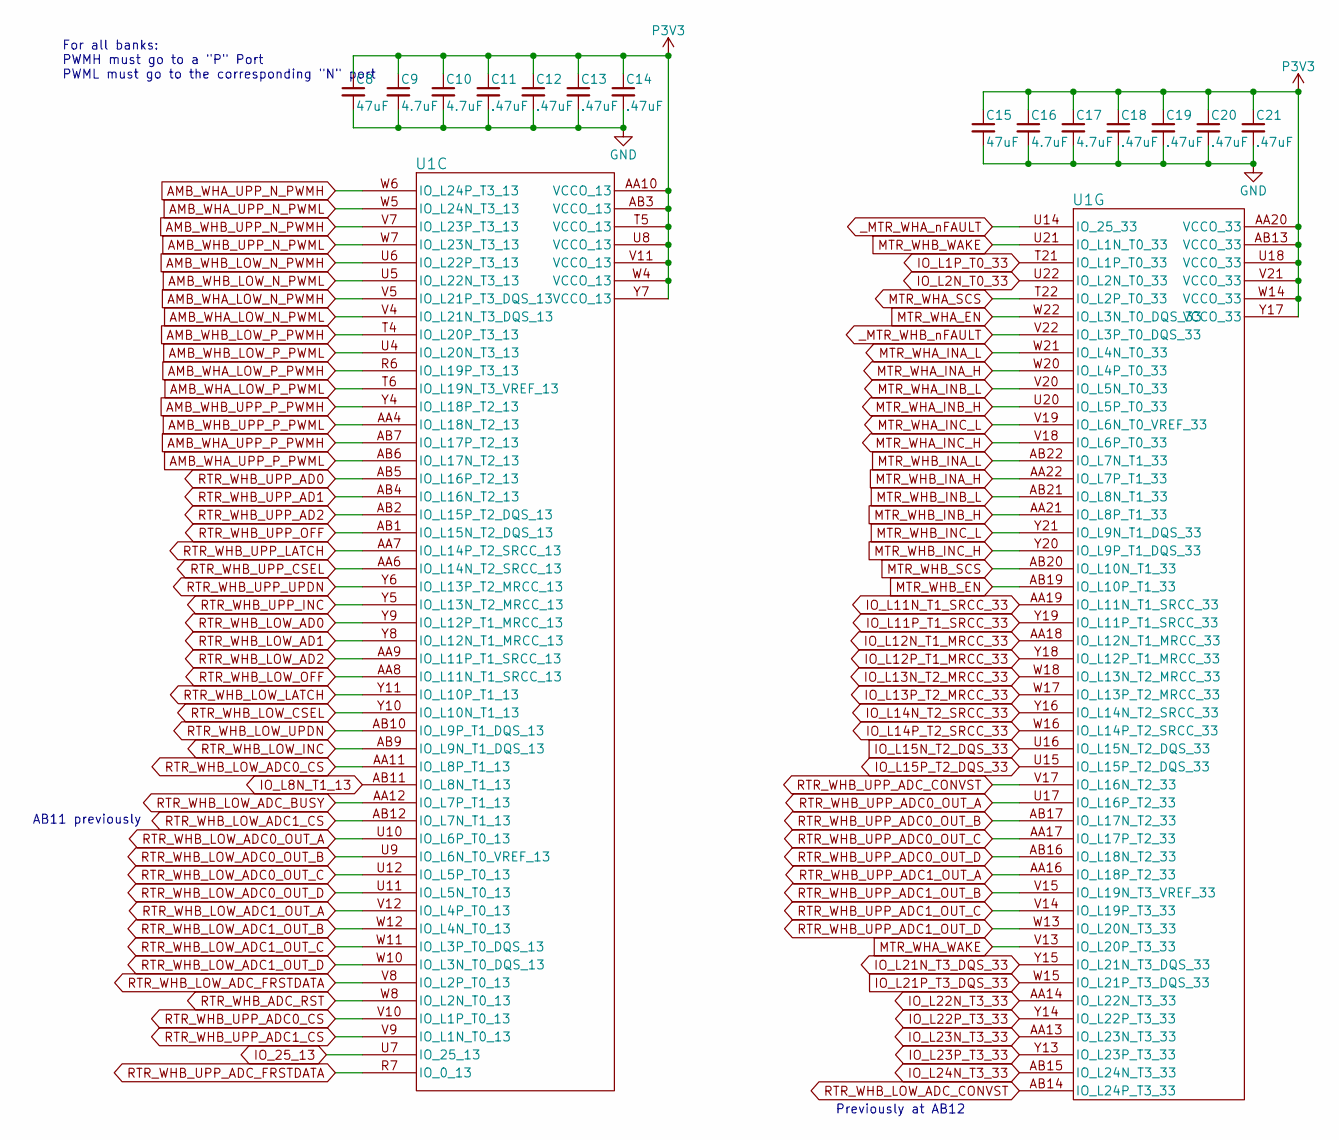
[picture p52: schematic ZYNQ_Banks.kicad_sch]

Parts:
C8, C15: 47uF; C_1210_3225Metric
C9, C10, C16, C17: 4.7uF; C_0402_1005Metric
C11, C12, C13, C14, C18, C19, C20, C21: .47uF; C_0402_1005Metric
U1: XC7Z020-2CLG484I; BGA-484_19.0x19.0mm_Layout22x22_P0.80mm_dia0.40mm

Connections:
AMB_WHA_LOW_N_PWMH: U1.V5 (IO_L21P_T3_DQS_13)
AMB_WHA_LOW_N_PWML: U1.V4 (IO_L21N_T3_DQS_13)
AMB_WHA_LOW_P_PWMH: U1.R6 (IO_L19P_T3_13)
AMB_WHA_LOW_P_PWML: U1.T6 (IO_L19N_T3_VREF_13)
AMB_WHA_UPP_N_PWMH: U1.W6 (IO_L24P_T3_13)
AMB_WHA_UPP_N_PWML: U1.W5 (IO_L24N_T3_13)
AMB_WHA_UPP_P_PWMH: U1.AB7 (IO_L17P_T2_13)
AMB_WHA_UPP_P_PWML: U1.AB6 (IO_L17N_T2_13)
AMB_WHB_LOW_N_PWMH: U1.U6 (IO_L22P_T3_13)
AMB_WHB_LOW_N_PWML: U1.U5 (IO_L22N_T3_13)
AMB_WHB_LOW_P_PWMH: U1.T4 (IO_L20P_T3_13)
AMB_WHB_LOW_P_PWML: U1.U4 (IO_L20N_T3_13)
AMB_WHB_UPP_N_PWMH: U1.V7 (IO_L23P_T3_13)
AMB_WHB_UPP_N_PWML: U1.W7 (IO_L23N_T3_13)
AMB_WHB_UPP_P_PWMH: U1.Y4 (IO_L18P_T2_13)
AMB_WHB_UPP_P_PWML: U1.AA4 (IO_L18N_T2_13)
GND: C8.2, C9.2, C10.2, C11.2, C12.2, C13.2, C14.2, C15.2, C16.2, C17.2, C18.2, C19.2, C20.2, C21.2
IO_25_13: U1.U7 (IO_25_13)
IO_L1P_T0_33: U1.T21 (IO_L1P_T0_33)
IO_L2N_T0_33: U1.U22 (IO_L2N_T0_33)
IO_L8N_T1_13: U1.AB11 (IO_L8N_T1_13)
IO_L11N_T1_SRCC_33: U1.AA19 (IO_L11N_T1_SRCC_33)
IO_L11P_T1_SRCC_33: U1.Y19 (IO_L11P_T1_SRCC_33)
IO_L12N_T1_MRCC_33: U1.AA18 (IO_L12N_T1_MRCC_33)
IO_L12P_T1_MRCC_33: U1.Y18 (IO_L12P_T1_MRCC_33)
IO_L13N_T2_MRCC_33: U1.W18 (IO_L13N_T2_MRCC_33)
IO_L13P_T2_MRCC_33: U1.W17 (IO_L13P_T2_MRCC_33)
IO_L14N_T2_SRCC_33: U1.Y16 (IO_L14N_T2_SRCC_33)
IO_L14P_T2_SRCC_33: U1.W16 (IO_L14P_T2_SRCC_33)
IO_L15N_T2_DQS_33: U1.U16 (IO_L15N_T2_DQS_33)
IO_L15P_T2_DQS_33: U1.U15 (IO_L15P_T2_DQS_33)
IO_L21N_T3_DQS_33: U1.Y15 (IO_L21N_T3_DQS_33)
IO_L21P_T3_DQS_33: U1.W15 (IO_L21P_T3_DQS_33)
IO_L22N_T3_33: U1.AA14 (IO_L22N_T3_33)
IO_L22P_T3_33: U1.Y14 (IO_L22P_T3_33)
IO_L23N_T3_33: U1.AA13 (IO_L23N_T3_33)
IO_L23P_T3_33: U1.Y13 (IO_L23P_T3_33)
IO_L24N_T3_33: U1.AB15 (IO_L24N_T3_33)
MTR_WHA_EN: U1.W22 (IO_L3N_T0_DQS_33)
MTR_WHA_INA_H: U1.W20 (IO_L4P_T0_33)
MTR_WHA_INA_L: U1.W21 (IO_L4N_T0_33)
MTR_WHA_INB_H: U1.U20 (IO_L5P_T0_33)
MTR_WHA_INB_L: U1.V20 (IO_L5N_T0_33)
MTR_WHA_INC_H: U1.V18 (IO_L6P_T0_33)
MTR_WHA_INC_L: U1.V19 (IO_L6N_T0_VREF_33)
MTR_WHA_SCS: U1.T22 (IO_L2P_T0_33)
MTR_WHA_WAKE: U1.V13 (IO_L20P_T3_33)
MTR_WHB_EN: U1.AB19 (IO_L10P_T1_33)
MTR_WHB_INA_H: U1.AA22 (IO_L7P_T1_33)
MTR_WHB_INA_L: U1.AB22 (IO_L7N_T1_33)
MTR_WHB_INB_H: U1.AA21 (IO_L8P_T1_33)
MTR_WHB_INB_L: U1.AB21 (IO_L8N_T1_33)
MTR_WHB_INC_H: U1.Y20 (IO_L9P_T1_DQS_33)
MTR_WHB_INC_L: U1.Y21 (IO_L9N_T1_DQS_33)
MTR_WHB_SCS: U1.AB20 (IO_L10N_T1_33)
MTR_WHB_WAKE: U1.U21 (IO_L1N_T0_33)
P3V3: C8.1, C9.1, C10.1, C11.1, C12.1, C13.1, C14.1, C15.1, C16.1, C17.1, C18.1, C19.1, C20.1, C21.1, U1.AA10 (VCCO_13), U1.AA20 (VCCO_33), U1.AB3 (VCCO_13), U1.AB13 (VCCO_33), U1.T5 (VCCO_13), U1.U8 (VCCO_13), U1.U18 (VCCO_33), U1.V11 (VCCO_13), U1.V21 (VCCO_33), U1.W4 (VCCO_13), U1.W14 (VCCO_33), U1.Y7 (VCCO_13), U1.Y17 (VCCO_33)
RTR_WHB_ADC_RST: U1.W8 (IO_L2N_T0_13)
RTR_WHB_LOW_AD0: U1.Y9 (IO_L12P_T1_MRCC_13)
RTR_WHB_LOW_AD1: U1.Y8 (IO_L12N_T1_MRCC_13)
RTR_WHB_LOW_AD2: U1.AA9 (IO_L11P_T1_SRCC_13)
RTR_WHB_LOW_ADC0_CS: U1.AA11 (IO_L8P_T1_13)
RTR_WHB_LOW_ADC0_OUT_A: U1.U10 (IO_L6P_T0_13)
RTR_WHB_LOW_ADC0_OUT_B: U1.U9 (IO_L6N_T0_VREF_13)
RTR_WHB_LOW_ADC0_OUT_C: U1.U12 (IO_L5P_T0_13)
RTR_WHB_LOW_ADC0_OUT_D: U1.U11 (IO_L5N_T0_13)
RTR_WHB_LOW_ADC1_CS: U1.AB12 (IO_L7N_T1_13)
RTR_WHB_LOW_ADC1_OUT_A: U1.V12 (IO_L4P_T0_13)
RTR_WHB_LOW_ADC1_OUT_B: U1.W12 (IO_L4N_T0_13)
RTR_WHB_LOW_ADC1_OUT_C: U1.W11 (IO_L3P_T0_DQS_13)
RTR_WHB_LOW_ADC1_OUT_D: U1.W10 (IO_L3N_T0_DQS_13)
RTR_WHB_LOW_ADC_BUSY: U1.AA12 (IO_L7P_T1_13)
RTR_WHB_LOW_ADC_CONVST: U1.AB14 (IO_L24P_T3_33)
RTR_WHB_LOW_ADC_FRSTDATA: U1.V8 (IO_L2P_T0_13)
RTR_WHB_LOW_CSEL: U1.Y10 (IO_L10N_T1_13)
RTR_WHB_LOW_INC: U1.AB9 (IO_L9N_T1_DQS_13)
RTR_WHB_LOW_LATCH: U1.Y11 (IO_L10P_T1_13)
RTR_WHB_LOW_OFF: U1.AA8 (IO_L11N_T1_SRCC_13)
RTR_WHB_LOW_UPDN: U1.AB10 (IO_L9P_T1_DQS_13)
RTR_WHB_UPP_AD0: U1.AB5 (IO_L16P_T2_13)
RTR_WHB_UPP_AD1: U1.AB4 (IO_L16N_T2_13)
RTR_WHB_UPP_AD2: U1.AB2 (IO_L15P_T2_DQS_13)
RTR_WHB_UPP_ADC0_CS: U1.V10 (IO_L1P_T0_13)
RTR_WHB_UPP_ADC0_OUT_A: U1.U17 (IO_L16P_T2_33)
RTR_WHB_UPP_ADC0_OUT_B: U1.AB17 (IO_L17N_T2_33)
RTR_WHB_UPP_ADC0_OUT_C: U1.AA17 (IO_L17P_T2_33)
RTR_WHB_UPP_ADC0_OUT_D: U1.AB16 (IO_L18N_T2_33)
RTR_WHB_UPP_ADC1_CS: U1.V9 (IO_L1N_T0_13)
RTR_WHB_UPP_ADC1_OUT_A: U1.AA16 (IO_L18P_T2_33)
RTR_WHB_UPP_ADC1_OUT_B: U1.V15 (IO_L19N_T3_VREF_33)
RTR_WHB_UPP_ADC1_OUT_C: U1.V14 (IO_L19P_T3_33)
RTR_WHB_UPP_ADC1_OUT_D: U1.W13 (IO_L20N_T3_33)
RTR_WHB_UPP_ADC_CONVST: U1.V17 (IO_L16N_T2_33)
RTR_WHB_UPP_ADC_FRSTDATA: U1.R7 (IO_0_13)
RTR_WHB_UPP_CSEL: U1.AA6 (IO_L14N_T2_SRCC_13)
RTR_WHB_UPP_INC: U1.Y5 (IO_L13N_T2_MRCC_13)
RTR_WHB_UPP_LATCH: U1.AA7 (IO_L14P_T2_SRCC_13)
RTR_WHB_UPP_OFF: U1.AB1 (IO_L15N_T2_DQS_13)
RTR_WHB_UPP_UPDN: U1.Y6 (IO_L13P_T2_MRCC_13)
_MTR_WHA_nFAULT: U1.U14 (IO_25_33)
_MTR_WHB_nFAULT: U1.V22 (IO_L3P_T0_DQS_33)

Notes on the sheet:
AB11 previously
For all banks: PWMH must go to a "P" Port PWML must go to the corresponding "N" port
Previously at AB12
