CooterPMcGrew/Flight_Computer_REV01/Zynq_PS_CONF.kicad_sch

## KiCad design Zynq_PS_CONF.kicad_sch (2026-05-14)

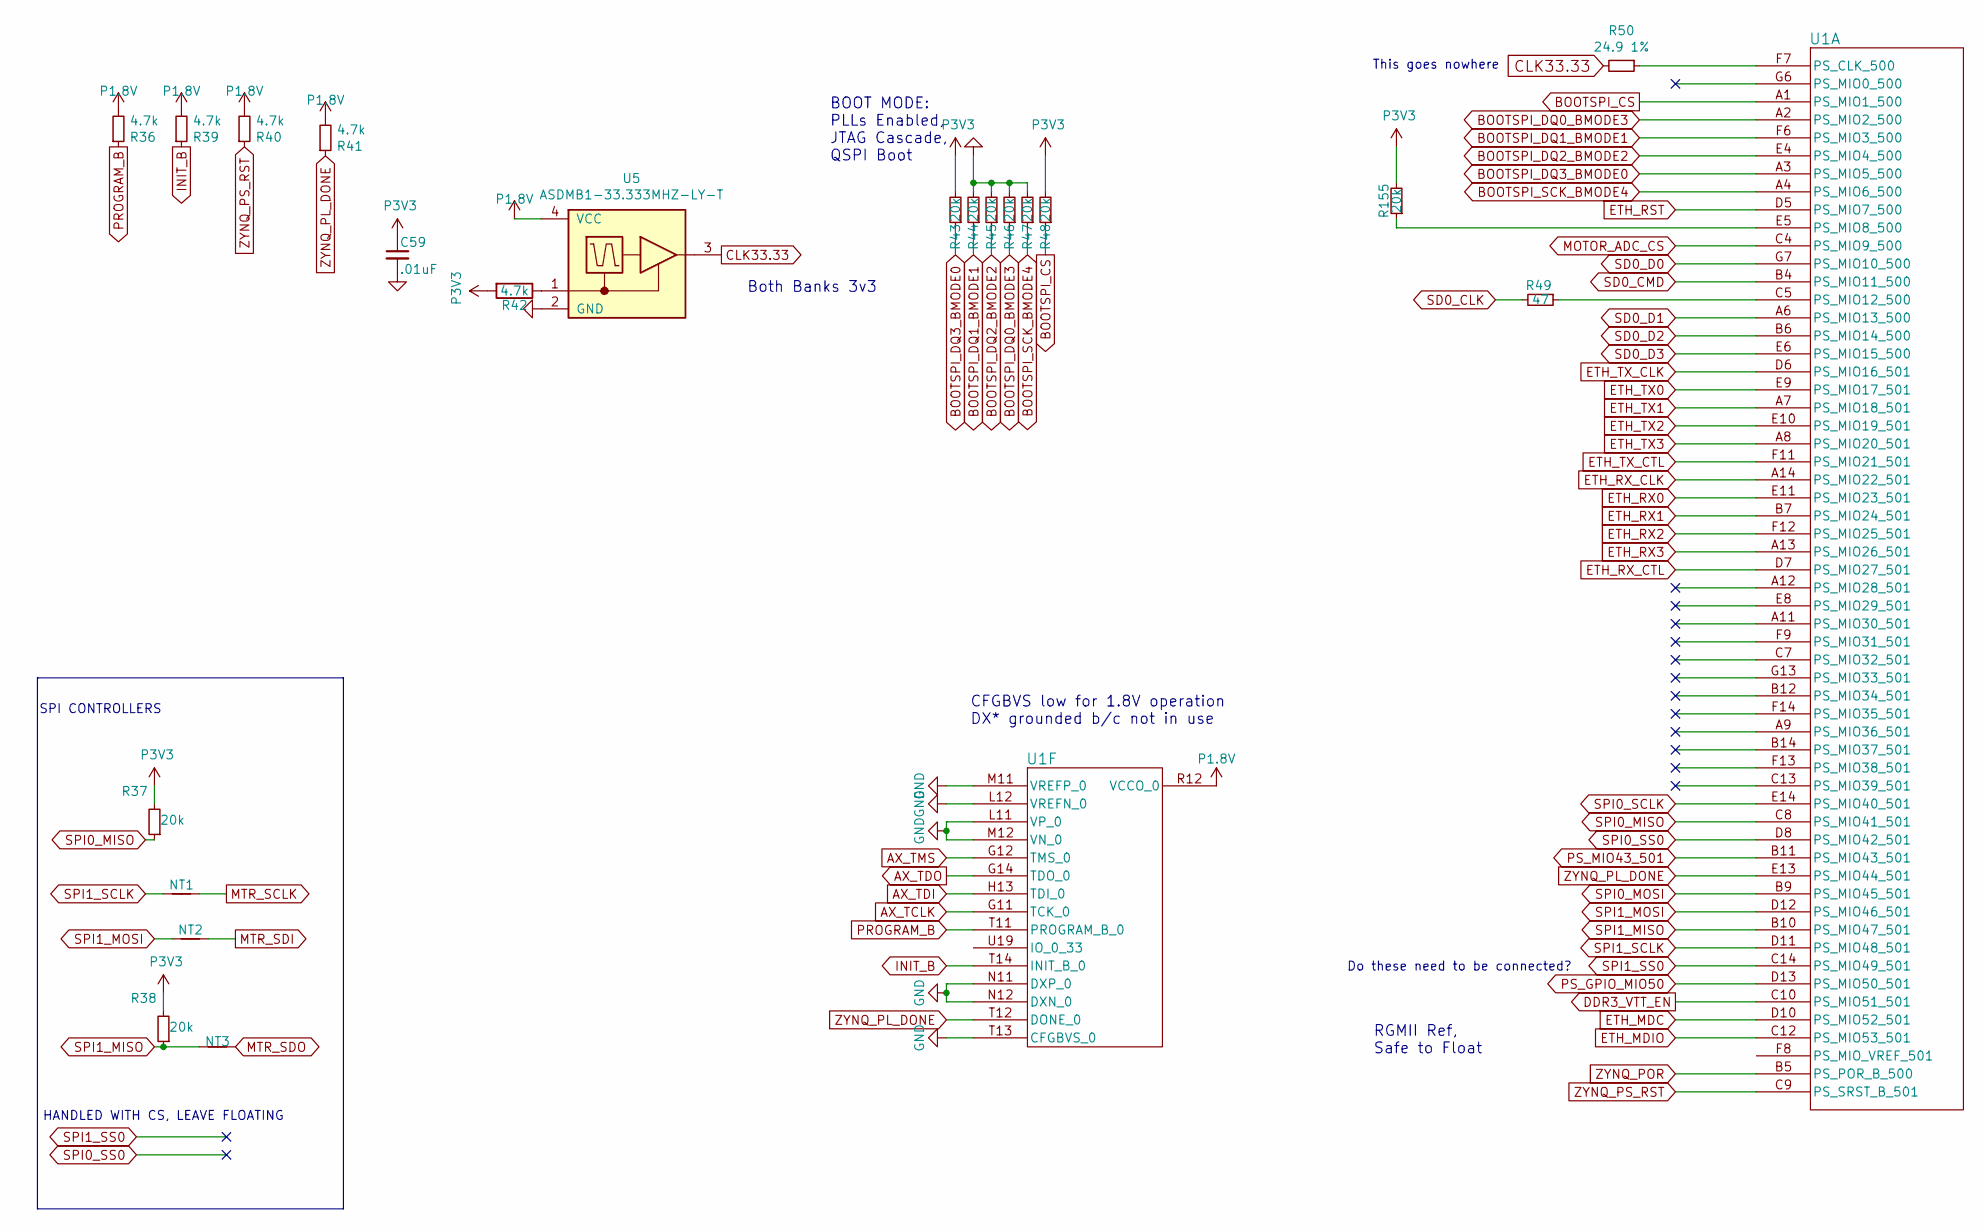
[picture p53: schematic Zynq_PS_CONF.kicad_sch]

Parts:
C59: .01uF; C_0402_1005Metric
NT1, NT2, NT3: NetTie_2
R36, R39, R40, R41, R42: 4.7k; R_0402_1005Metric
R37, R38, R43, R44, R45, R46, R47, R48, R155: 20k; R_0402_1005Metric
R49: 47; R_0402_1005Metric
R50: 24.9 1%; R_0402_1005Metric
U1: XC7Z020-2CLG484I; BGA-484_19.0x19.0mm_Layout22x22_P0.80mm_dia0.40mm
U5: ASDMB1-33.333MHZ-LY-T; Crystal_SMD_Abracon_ABM10-4Pin_2.5x2.0mm

Connections:
AX_TCLK: U1.G11 (TCK_0)
AX_TDI: U1.H13 (TDI_0)
AX_TDO: U1.G14 (TDO_0)
AX_TMS: U1.G12 (TMS_0)
BOOTSPI_CS: R48.1, U1.A1 (PS_MIO1_500)
BOOTSPI_DQ0_BMODE3: R46.1, U1.A2 (PS_MIO2_500)
BOOTSPI_DQ1_BMODE1: R44.1, U1.F6 (PS_MIO3_500)
BOOTSPI_DQ2_BMODE2: R45.1, U1.E4 (PS_MIO4_500)
BOOTSPI_DQ3_BMODE0: R43.1, U1.A3 (PS_MIO5_500)
BOOTSPI_SCK_BMODE4: R47.1, U1.A4 (PS_MIO6_500)
CLK33.33: R50.2, U5.3 (OUT)
DDR3_VTT_EN: U1.C10 (PS_MIO51_501)
ETH_MDC: U1.D10 (PS_MIO52_501)
ETH_MDIO: U1.C12 (PS_MIO53_501)
ETH_RST: U1.D5 (PS_MIO7_500)
ETH_RX0: U1.E11 (PS_MIO23_501)
ETH_RX1: U1.B7 (PS_MIO24_501)
ETH_RX2: U1.F12 (PS_MIO25_501)
ETH_RX3: U1.A13 (PS_MIO26_501)
ETH_RX_CLK: U1.A14 (PS_MIO22_501)
ETH_RX_CTL: U1.D7 (PS_MIO27_501)
ETH_TX0: U1.E9 (PS_MIO17_501)
ETH_TX1: U1.A7 (PS_MIO18_501)
ETH_TX2: U1.E10 (PS_MIO19_501)
ETH_TX3: U1.A8 (PS_MIO20_501)
ETH_TX_CLK: U1.D6 (PS_MIO16_501)
ETH_TX_CTL: U1.F11 (PS_MIO21_501)
GND: C59.2, R44.2, R45.2, R46.2, R47.2, U1.L11 (VP_0), U1.L12 (VREFN_0), U1.M11 (VREFP_0), U1.M12 (VN_0), U1.N11 (DXP_0), U1.N12 (DXN_0), U1.T13 (CFGBVS_0), U5.2 (GND)
INIT_B: R39.1, U1.T14 (INIT_B_0)
MOTOR_ADC_CS: U1.C4 (PS_MIO9_500)
MTR_SCLK: NT1.2
MTR_SDI: NT2.2
MTR_SDO: NT3.2
unnamed: R42.1, U5.1 (OE)
unnamed: R49.1, U1.C5 (PS_MIO12_500)
unnamed: R50.1, U1.F7 (PS_CLK_500)
unnamed: R155.1, U1.E5 (PS_MIO8_500)
P1.8V: R36.2, R39.2, R40.2, R41.2, U1.R12 (VCCO_0), U5.4 (VCC)
P3V3: C59.1, R37.2, R38.2, R42.2, R43.2, R48.2, R155.2
PROGRAM_B: R36.1, U1.T11 (PROGRAM_B_0)
PS_GPIO_MIO50: U1.D13 (PS_MIO50_501)
PS_MIO43_501: U1.B11 (PS_MIO43_501)
SD0_CLK: R49.2
SD0_CMD: U1.B4 (PS_MIO11_500)
SD0_D0: U1.G7 (PS_MIO10_500)
SD0_D1: U1.A6 (PS_MIO13_500)
SD0_D2: U1.B6 (PS_MIO14_500)
SD0_D3: U1.E6 (PS_MIO15_500)
SPI0_MISO: R37.1, U1.C8 (PS_MIO41_501)
SPI0_MOSI: U1.B9 (PS_MIO45_501)
SPI0_SCLK: U1.E14 (PS_MIO40_501)
SPI0_SS0: U1.D8 (PS_MIO42_501)
SPI1_MISO: NT3.1, R38.1, U1.B10 (PS_MIO47_501)
SPI1_MOSI: NT2.1, U1.D12 (PS_MIO46_501)
SPI1_SCLK: NT1.1, U1.D11 (PS_MIO48_501)
SPI1_SS0: U1.C14 (PS_MIO49_501)
ZYNQ_PL_DONE: R41.1, U1.E13 (PS_MIO44_501), U1.T12 (DONE_0)
ZYNQ_POR: U1.B5 (PS_POR_B_500)
ZYNQ_PS_RST: R40.1, U1.C9 (PS_SRST_B_501)

Notes on the sheet:
Both Banks 3v3
BOOT MODE: PLLs Enabled, JTAG Cascade, QSPI Boot
CFGBVS low for 1.8V operation DX* grounded b/c not in use
HANDLED WITH CS, LEAVE FLOATING
SPI CONTROLLERS
RGMII Ref, Safe to Float
Do these need to be connected?
This goes nowhere
