CooterPMcGrew/Flight_Computer_REV01/storage.kicad_sch

## KiCad design storage.kicad_sch (2026-05-14)

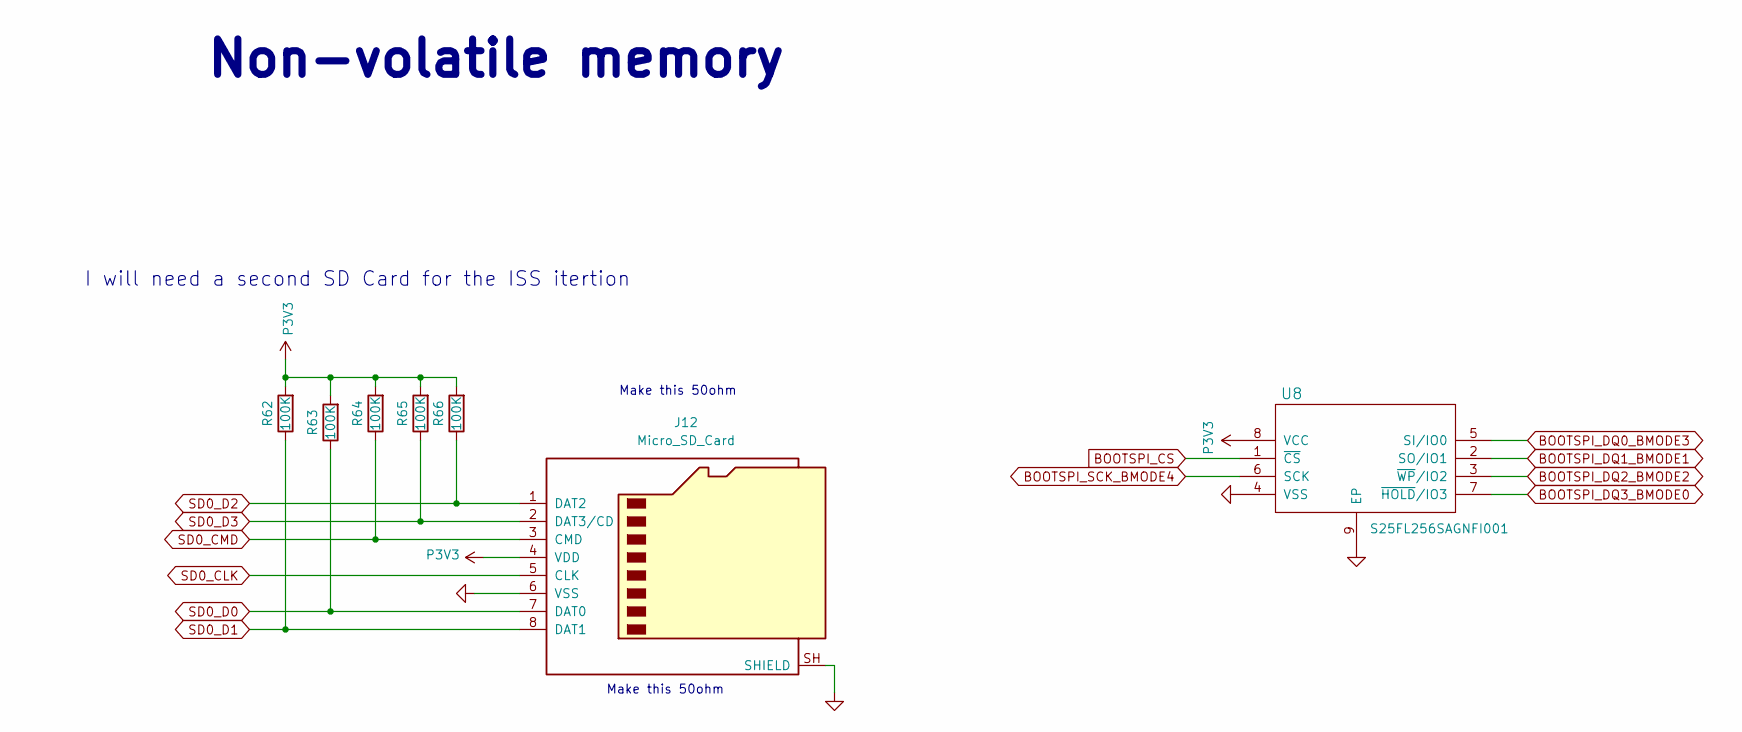
[picture p54: schematic storage.kicad_sch]

Parts:
J12: Micro_SD_Card; microSD_HC_Molex_47219-2001
R62, R63, R64, R65, R66: 100K; R_0402_1005Metric
U8: S25FL256SAGNFI001; WSON-8-1EP_8x6mm_P1.27mm_EP3.4x4.3mm

Connections:
BOOTSPI_CS: U8.1 (~CS)
BOOTSPI_DQ0_BMODE3: U8.5 (SI/IO0)
BOOTSPI_DQ1_BMODE1: U8.2 (SO/IO1)
BOOTSPI_DQ2_BMODE2: U8.3 (~WP/IO2)
BOOTSPI_DQ3_BMODE0: U8.7 (~HOLD/IO3)
BOOTSPI_SCK_BMODE4: U8.6 (SCK)
GND: J12.6 (VSS), J12.SH (SHIELD), U8.4 (VSS), U8.9 (EP)
P3V3: J12.4 (VDD), R62.2, R63.2, R64.2, R65.2, R66.2, U8.8 (VCC)
SD0_CLK: J12.5 (CLK)
SD0_CMD: J12.3 (CMD), R64.1
SD0_D0: J12.7 (DAT0), R63.1
SD0_D1: J12.8 (DAT1), R62.1
SD0_D2: J12.1 (DAT2), R66.1
SD0_D3: J12.2 (DAT3/CD), R65.1

Notes on the sheet:
Make this 50ohm
I will need a second SD Card for the ISS itertion
Non-volatile memory
