CooterPMcGrew/Flight_Computer_REV01/(commit log)

2026-05-05 updated layouts, added motor
    [AMB.kicad_sch, AMB_WHEEL_A_LOW.kicad_sch, AMB_WHEEL_B_LOW.kicad_sch, AMB_WHEEL_B_UPP.kicad_sch, COMMS.kicad_sch, DDR.kicad_sch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]
2026-05-06 SPI feedback repaired
    [Zynq_PS_CONF.kicad_sch]
2026-05-14 Changes to layout pins
    [AMB.kicad_sch, AMB_WHEEL_A_LOW.kicad_sch, AMB_WHEEL_B_LOW.kicad_sch, AMB_WHEEL_B_UPP.kicad_sch, COMMS.kicad_sch, COMM_USB.kicad_sch, DDR.kicad_sch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]
